wajmh/D-Y/CAN3_逻辑总结.md

# CAN3 / 小脑 (RK3588) 通信与总线逻辑总结

> [!IMPORTANT]
> **V1.2 硬件改版与总线对调关键背景**：
> - 依据《v1.2新版_电源板原理图_2026-09-17.pdf》及最新固件代码：由于 PCB 走线将 CAN2 与 CAN3 外接接口反接，且 STM32G474 物理引脚 AF 映射无法互换，固件已在**软件层对调 FDCAN2 与 FDCAN3 控制器职责**。
> - **与上位机 / 小脑 (RK3588) 通信的总线**：硬件接口连接 STM32 的 **`FDCAN2`（RX: PB5, TX: PB13）**；
> - **电池2 BMS 与外部充电桩总线**：硬件接口连接 STM32 的 **`FDCAN3`（RX: PA8, TX: PB4）**；
> - **电池1 BMS 总线**：连接 STM32 的 **`FDCAN1`（RX: PA11, TX: PA12）**。
> - 本文档全面梳理**与小脑 (RK3588) 交互的所有总线通信协议与底层逻辑**（在代码中由 [`fdcan.c`](file:///home/yq/ghf/workspace/D-Y-A10/Core/Src/fdcan.c) 的 `hfdcan2` 外设驱动），同时涵盖 V1.2 最新引入的**声光控制、IAP 在线升级、Bus-Off 自愈与硬件安全策略**。

---

## 1. 系统架构与总线拓扑

```mermaid
flowchart LR
    subgraph 电池与充电桩
        BAT1["电池1 BMS"] -->|FDCAN1 (PA11/PA12)| MCU
        BAT2["电池2 BMS"] -->|FDCAN3 (PA8/PB4)| MCU
        CHARGER["外部充电桩<br/>0x0500FF80"] -->|FDCAN3 (PA8/PB4)| MCU
    end

    subgraph 控制大脑
        MCU["STM32G474RBT6<br/>电源管理主控"]
    end

    subgraph 上位机小脑
        MCU -->|"FDCAN2 (PB13-TX)<br/>遥测/状态/转发"| RK["RK3588 小脑"]
        RK -->|"FDCAN2 (PB5-RX)<br/>控制/IAP/声光"| MCU
    end
```

### 控制器与物理引脚映射全景

| 逻辑总线角色 | MCU 外设控制器 | 物理引脚 | 外接对象 | 主要通信内容 |
|---|---|---|---|---|
| **小脑上位机总线** | **FDCAN2** | **RX: PB5<br/>TX: PB13** | **小脑 (RK3588)** | **遥测上报 (电流/告警/MOS/状态)<br/>声光控制 (0x04600000/01)<br/>IAP 固件升级 (0x04700000/01)<br/>BMS 报文转发 (0x0402/03/0E/07)** |
| **电池2 / 充电桩总线** | **FDCAN3** | **RX: PA8<br/>TX: PB4** | **电池2 BMS +<br/>外部充电桩** | 接收电池2状态/MOS/温度/故障<br/>接收充电桩握手帧 (0x0500FF80)<br/>向充电桩发送充电机回复帧 |
| **电池1 BMS 总线** | **FDCAN1** | **RX: PA11<br/>TX: PA12** | **电池1 BMS** | 接收电池1状态/MOS/温度/故障<br/>发送电池1开机唤醒帧 |

---

## 2. CAN 控制器硬件与参数配置

三路 FDCAN 控制器均采用标准经典 CAN 250 kbps 波特率配置（基于时钟源 PCLK1 = 170MHz）：

| 参数项 | FDCAN2 (小脑 RK 通信) | FDCAN3 (电池2 + 充电桩) | FDCAN1 (电池1 BMS) |
|---|---|---|---|
| **物理引脚** | PB5 (RX), PB13 (TX) | PA8 (RX), PB4 (TX) | PA11 (RX), PA12 (TX) |
| **波特率** | **250 kbps** | **250 kbps** | **250 kbps** |
| **位时序** | Prescaler=40, Seg1=13, Seg2=3, SJW=1 | Prescaler=40, Seg1=13, Seg2=3, SJW=1 | Prescaler=40, Seg1=13, Seg2=3, SJW=1 |
| **帧格式** | 经典 CAN (`FDCAN_FRAME_CLASSIC`) | 经典 CAN (`FDCAN_FRAME_CLASSIC`) | 经典 CAN (`FDCAN_FRAME_CLASSIC`) |
| **ID 类型** | 扩展帧 (29-bit Extended ID) | 扩展帧 (29-bit Extended ID) | 扩展帧 (29-bit Extended ID) |
| **TX 模式** | FIFO 队列模式 (`FDCAN_TX_FIFO_OPERATION`) | FIFO 队列模式 | FIFO 队列模式 |
| **自动重发** | 开启 (`AutoRetransmission = ENABLE`) | 开启 (`ENABLE`) | 开启 (`ENABLE`) |
| **RX 过滤器** | 1 标准 + **3 扩展过滤器**<br>(0x04500000, 0x04600000, 0x04700000) | 1 标准 + **8 扩展过滤器**<br>(7类BMS帧 + 0x0500FF80充电桩帧) | 1 标准 + **7 扩展过滤器**<br>(7类BMS帧) |

---

## 3. CAN 发送帧汇总（TX → 小脑 RK，由 FDCAN2 发送）

### 3.1 腿部电流上报 `0x04100000`

| 字段 | 属性 / 说明 |
|---|---|
| **CAN ID** | `0x04100000` |
| **帧类型** | 扩展帧 (29-bit)，数据帧 |
| **数据长度** | 8 字节 |
| **发送周期** | **200ms** 周期发送（与外设电流同时触发） |
| **发送函数** | [`FDCAN_SendCurrentReportsToRk()`](file:///home/yq/ghf/workspace/D-Y-A10/Core/Src/fdcan.c#L419-L435) |
| **硬件变动说明** | **V1.2 原理图已取消板载腿部运放检流电路**（PC0~PC3 废弃/预留，腿电流改由各关节电机 CAN 自行上报）。固件保留该接口与报文定义以保持上位机协议兼容，数据固定填充为 0.00A。 |

**数据格式（小端序 int16，缩放比例 100，即 0.01A）：**

| 字节偏移 | 字段定义 | 类型 | 数值范围与说明 |
|---|---|---|---|
| Byte 0-1 | Leg1 采样电流 | int16_t (LE) | `0`（硬件已取消，固定填充 0） |
| Byte 2-3 | Leg2 采样电流 | int16_t (LE) | `0`（硬件已取消，固定填充 0） |
| Byte 4-5 | Leg3 采样电流 | int16_t (LE) | `0`（硬件已取消，固定填充 0） |
| Byte 6-7 | Leg4 采样电流 | int16_t (LE) | `0`（硬件已取消，固定填充 0） |

---

### 3.2 外设电流上报 `0x04200000`

| 字段 | 属性 / 说明 |
|---|---|
| **CAN ID** | `0x04200000` |
| **帧类型** | 扩展帧 (29-bit)，数据帧 |
| **数据长度** | 8 字节 |
| **发送周期** | **200ms** 周期发送 |
| **发送函数** | [`FDCAN_SendCurrentReportsToRk()`](file:///home/yq/ghf/workspace/D-Y-A10/Core/Src/fdcan.c#L419-L435) |
| **硬件采样来源** | **PA4 (ADC2_IN17)** 经运放采样的外设放电电流，DMA 循环采集计算 |

**数据格式：**

| 字节偏移 | 字段定义 | 类型 | 数值范围与说明 |
|---|---|---|---|
| Byte 0-1 | 外设放电电流 | int16_t (LE) | 电流值(A) × 100（精度 0.01A） |
| Byte 2-7 | 保留字段 | uint8_t | 固定填充 `0x00` |

---

### 3.3 急停上报 `0x04300000` [已停用]

> [!WARNING]
> **硬件状态变动**：V1.2 硬件设计中，急停输入引脚 PD2 (`I_STOP_EN`) 硬件未连接且已在原理图中停用。
> 固件代码中，急停检测逻辑、定时轮询上报及 `0x04300000` 报文已在 [`fdcan.c`](file:///home/yq/ghf/workspace/D-Y-A10/Core/Src/fdcan.c#L43-L46) 中**注释停用**，正常运行期间不再发送此帧。

---

### 3.4 电池告警 + 本地 MOS 状态上报 `0x04400000`

| 字段 | 属性 / 说明 |
|---|---|
| **CAN ID** | `0x04400000` |
| **帧类型** | 扩展帧 (29-bit)，数据帧 |
| **数据长度** | 8 字节 |
| **发送周期** | **100ms** 周期（`FDCAN_BATTERY_ALARM_REPORT_PERIOD_MS = 100U`） |
| **发送函数** | [`FDCAN_SendBatteryAlarmReportToRk()`](file:///home/yq/ghf/workspace/D-Y-A10/Core/Src/fdcan.c#L446-L460) |

**多条件触发策略：**

| 运行条件 | 发送行为 | 说明 |
|---|---|---|
| **系统存在告警** | 每 **100ms** 周期发送 | 电池1或电池2告警状态不为 0 时持续高频上报 |
| **MOS 状态跳变** | **立即事件触发** | 任意 MOS（放电/回充/充电）发生开/关动作时立刻发送，零延时同步状态 |
| **告警刚刚清除** | 连续补发 **10 帧**（每 100ms） | 从有报警恢复正常时，突发补发 10 帧保证小脑可靠感知消除 |
| **正常心跳** | 每 **100ms** 周期发送 | 无告警且 MOS 稳定时的常规基线心跳（`FDCAN_BATTERY_ALARM_HEARTBEAT_PERIOD_MS`） |

**数据格式：**

| 字节偏移 | 字段定义 | 取值与说明 |
|---|---|---|
| **Byte 0** | 电池1 告警状态 | `0x00`=正常, 非0表示故障掩码（过压/欠压/过流/过温等） |
| **Byte 1** | 电池2 告警状态 | `0x00`=正常, 非0表示故障掩码 |
| **Byte 2** | 电池1 主放电 MOS 状态 | `0x01`=导通 (ON), `0x00`=断开 (OFF) |
| **Byte 3** | 电池1 回充 MOS 状态 | `0x01`=导通 (ON), `0x00`=断开 (OFF) |
| **Byte 4** | 电池2 主放电 MOS 状态 | `0x01`=导通 (ON), `0x00`=断开 (OFF) |
| **Byte 5** | 电池2 回充 MOS 状态 | `0x01`=导通 (ON), `0x00`=断开 (OFF) |
| **Byte 6** | 电池1 充电 MOS 状态 | `0x01`=导通 (ON), `0x00`=断开 (OFF)（V1.2 由 PB10 总充电 MOS 镜像同步） |
| **Byte 7** | 电池2 充电 MOS 状态 | `0x01`=导通 (ON), `0x00`=断开 (OFF)（V1.2 由 PB10 总充电 MOS 镜像同步） |

---

### 3.5 充电模式状态回复 `0x04500001`

| 字段 | 属性 / 说明 |
|---|---|
| **CAN ID** | `0x04500001` |
| **帧类型** | 扩展帧 (29-bit)，数据帧 |
| **数据长度** | 1 字节 |
| **触发条件** | **事件驱动**：进入或退出充电模式瞬间向小脑回复确认 |
| **发送函数** | [`FDCAN_SendChargeModeStatusToRk()`](file:///home/yq/ghf/workspace/D-Y-A10/Core/Src/fdcan.c#L462-L502) |

**数据格式：**

| 字节偏移 | 字段定义 | 取值说明 |
|---|---|---|
| Byte 0 | 充电模式当前状态 | `0x01` = 已成功切入充电模式<br/>`0x00` = 已退出充电模式 |

**典型触发场景：**
1. **握手进入**：小脑已发送充电请求（`rk_charge_mode_request = 1`）且 FDCAN3 收到充电桩握手帧（`0x0500FF80`）→ MCU 进入充电模式并回复 `0x01`；
2. **主动退出**：小脑发送 `0x04500000`（载荷 `0x00`）要求退出 → MCU 立即切出充电模式并回复 `0x00`；
3. **超时退出**：在充电激活状态下，若超过 **3000ms**（`FDCAN_CHARGER_CAN_TIMEOUT_MS`）未收到充电桩报文（拔枪或充电机断电）→ MCU 自动退出充电模式并回复 `0x00`；
4. **VBUS 持续供电保护**：进入充电模式时，在位电池的**主放电 MOS 保持导通**，确保 VBUS 持续带电供应板载 12V DCDC，**保障小脑 RK3588 绝对不掉电**；回充 MOS 与预充 MOS 强制切断以防倒灌。

---

### 3.6 声光指示状态遥测上报 `0x04600001` [V1.2 新增]

| 字段 | 属性 / 说明 |
|---|---|
| **CAN ID** | `0x04600001` |
| **帧类型** | 扩展帧 (29-bit)，数据帧 |
| **数据长度** | 8 字节 |
| **发送周期** | **500ms** 周期发送（`FDCAN_RK_INDICATOR_REPORT_PERIOD_MS = 500U`） |
| **发送函数** | [`FDCAN_SendIndicatorStatusToRk()`](file:///home/yq/ghf/workspace/D-Y-A10/Core/Src/fdcan.c#L2016-L2073) |

**数据格式：**

| 字节偏移 | 字段定义 | 取值与说明 |
|---|---|---|
| **Byte 0** | 小脑接管状态 | Bit0: `1`=RGB 被小脑接管, `0`=本地电量模式<br/>Bit1: `1`=蜂鸣器被小脑接管, `0`=本地默认 |
| **Byte 1** | 实际物理红灯状态 (R) | `0x01` = 点亮, `0x00` = 熄灭 |
| **Byte 2** | 实际物理绿灯状态 (G) | `0x01` = 点亮, `0x00` = 熄灭 |
| **Byte 3** | 实际物理蓝灯状态 (B) | `0x01` = 点亮, `0x00` = 熄灭 |
| **Byte 4** | 实际物理蜂鸣器状态 | `0x01` = 鸣响, `0x00` = 静音 |
| **Byte 5** | 双电池最小 SOC | 取两路在位电池 SOC 的最小值（0~100%，四舍五入整数） |
| **Byte 6** | 系统故障状态字节 | **Bit0**: `1` = 检测到 CAN Bus-Off 故障<br/>**Bit1**: 保留（原急停标志，已停用）<br/>**Bit2**: `1` = 严重低电量报警（SOC < 20%） |
| **Byte 7** | 保留字段 | 固定填充 `0x00` |

---

### 3.7 IAP 在线升级协议应答 `0x04700001` [V1.2 新增]

| 字段 | 属性 / 说明 |
|---|---|
| **CAN ID** | `0x04700001` |
| **帧类型** | 扩展帧 (29-bit)，数据帧 |
| **数据长度** | 8 字节 |
| **触发条件** | 收到小脑 `0x04700000` IAP 指令后立即应答 |
| **处理函数** | [`FDCAN_HandleIapCommand()`](file:///home/yq/ghf/workspace/D-Y-A10/Core/Src/fdcan.c#L1130-L1184) |

**数据格式（在 App 中运行时的典型回复）：**

| 响应指令 (CMD) | 作用 | 数据载荷 (8字节) | 详细含义 |
|---|---|---|---|
| `0x01` (PING 响应) | 查询当前固件状态 | `[0x01, 0x00, 0x02, Major, Minor, Patch, 0x01, 0x00]` | Byte1=0 (ACK_OK)<br/>Byte2=2 (当前运行于 App)<br/>Byte3~5=版本号 (如 1, 2, 4)<br/>Byte6=1 (App 固件有效) |
| `0x02` (START 响应) | 确认切入升级 | `[0x02, 0x00, 0x02, 0x00, 0x00, 0x00, 0x00, 0x00]` | Byte1=0 (ACK_OK)<br/>Byte2=2 (App 收到请求)<br/>*回复后延时 20ms 确保发送完成，随后执行无缝热接力平滑跳转至 Bootloader* |

---

### 3.8 电池 BMS 报文透明转发（FDCAN1/FDCAN3 → FDCAN2/小脑）

| 字段 | 属性 / 说明 |
|---|---|
| **CAN ID 规则** | `txId = (rxId & 0x1FFFFF00) | batteryIndex`<br>- `batteryIndex = 1`：源自 FDCAN1（电池1）<br>- `batteryIndex = 2`：源自 FDCAN3（电池2，硬件反接后映射） |
| **帧类型 / DLC** | 保持原始 BMS 扩展帧与数据长度 |
| **触发机制** | 收到符合条件的 BMS 扩展帧后立即打包转发至 FDCAN2 TX FIFO |
| **处理函数** | [`FDCAN_ForwardBatteryFrameToRk()`](file:///home/yq/ghf/workspace/D-Y-A10/Core/Src/fdcan.c#L641-L697) |

**转发的 4 类 BMS 核心帧：**

| 原始 ID Base (掩码过滤) | 转发后 ID (Bat1 / Bat2) | 报文含义 | 关键数据载荷 |
|---|---|---|---|
| `0x04028000` | `0x04028001` / `0x04028002` | **电池状态帧** | 总电压 (0.1V)、充放电电流 ((raw-30000)×0.1A)、SOC (0.1%) |
| `0x04038000` | `0x04038001` / `0x04038002` | **电池信息帧** | 电池容量、循环次数、出厂信息等 |
| `0x040E8000` | `0x040E8001` / `0x040E8002` | **电池故障帧** | BMS 内部单体过压/欠压、温差大、短路等硬报警 |
| `0x04078000` | `0x04078001` / `0x04078002` | **电池温度帧** | 各电芯探头采集的实际温度分布 |

> [!NOTE]
> - **不转发的帧**：BMS 内部 MOS 状态帧（`0x04068000`）和充电机回复帧（`0x04008000`, `0x04088000`）仅在 MCU 本地解析消抖并存储，不直接转发给小脑，而是通过 `0x04400000` 统一汇总上报。
> - **队列防溢出**：若 FDCAN2 总线处于 Bus-Off 或 TX FIFO 满，报文将被安全丢弃，丢帧计入 `battery_can_forward_drop_count` 调试计数器。

---

## 4. CAN 接收帧汇总（RX ← 小脑 RK，由 FDCAN2 接收）

小脑通过 FDCAN2 下发控制指令，MCU 在主循环 [`FDCAN_PollRkRx()`](file:///home/yq/ghf/workspace/D-Y-A10/Core/Src/fdcan.c#L1186-L1211) 中以非阻塞方式轮询处理。

### 4.1 充电模式控制指令 `0x04500000`

| 字段 | 属性 / 说明 |
|---|---|
| **CAN ID** | `0x04500000` |
| **帧类型** | 扩展帧 (29-bit)，数据帧 |
| **数据长度** | ≥ 1 字节 |
| **处理函数** | [`FDCAN_HandleRkChargeModeCommand()`](file:///home/yq/ghf/workspace/D-Y-A10/Core/Src/fdcan.c#L926-L949) |

**数据格式：**

| 字节偏移 | 字段定义 | 取值与作用 |
|---|---|---|
| Byte 0 | 充电模式指令代码 | `0x01` = 请求进入充电模式<br/>`0x00` = 请求退出充电模式 |

**状态机处理逻辑（两阶段安全握手）：**
- **收到 `0x01`**：置位标记 `rk_charge_mode_request = 1`。此时**并不立刻开启充电机 MOS**，而是等待外部充电桩在 FDCAN3 上发出 `0x0500FF80` 握手报文，确认充电机物理到位后才真正切换充电模式，避免空载打火；
- **收到 `0x00`**：立即清除请求，断开充电回路，退出充电模式，并回复状态帧 `0x04500001`（数据 `0x00`）。

---

### 4.2 小脑声光指示控制指令 `0x04600000` [V1.2 新增]

| 字段 | 属性 / 说明 |
|---|---|
| **CAN ID** | `0x04600000` |
| **帧类型** | 扩展帧 (29-bit)，数据帧 |
| **数据长度** | 1 ~ 8 字节 |
| **处理函数** | [`FDCAN_HandleRkIndicatorCommand()`](file:///home/yq/ghf/workspace/D-Y-A10/Core/Src/fdcan.c#L951-L1017) |

**数据格式：**

| 字节偏移 | 字段定义 | 详细取值与说明 |
|---|---|---|
| **Byte 0** | 接管使能掩码 (`ctrlMask`) | **Bit0 (0x01)**: 小脑接管 RGB 控制权（1:接管, 0:释放回到本地电量指示）<br/>**Bit1 (0x02)**: 小脑接管蜂鸣器（1:接管, 0:释放回到本地） |
| **Byte 1** | 红色分量 (R) | `0` = 关, `1` = 开 |
| **Byte 2** | 绿色分量 (G) | `0` = 关, `1` = 开 |
| **Byte 3** | 蓝色分量 (B) | `0` = 关, `1` = 开 |
| **Byte 4** | RGB 工作模式 | `0x00` = 常亮 (Solid)<br/>`0x01` = 闪烁 (Blink) |
| **Byte 5** | 蜂鸣器工作模式 | `0x00` = 静音 (Off)<br/>`0x01` = 持续长鸣 (On)<br/>`0x02` = 单次短鸣 200ms (`BEEP_ONCE`)<br/>`0x03` = 周期鸣叫 (`BLINK`) |
| **Byte 6** | 闪烁/鸣叫半周期 | 单位：**50 ms**（例如写入 `10` 表示 500ms 半周期，默认 500ms） |
| **Byte 7** | 通信安全超时时间 | 单位：**100 ms**（例如写入 `30` 表示 3000ms 超时）。超过此时间若无新指令，**自动安全释放接管权，退回本地电量显示**。若为 0 则表示无限期接管。 |

> [!TIP]
> 固件源码中定义有宏 `#define DEBUG_DISABLE_RK_BUZZER_CTRL 1`。在台架调试或特定版本中，可选择性屏蔽小脑对蜂鸣器的接管，避免上位机调试误触发尖锐警报。

---

### 4.3 IAP 在线升级控制指令 `0x04700000` [V1.2 新增]

| 字段 | 属性 / 说明 |
|---|---|
| **CAN ID** | `0x04700000` |
| **帧类型** | 扩展帧 (29-bit)，数据帧 |
| **数据长度** | 1 ~ 8 字节 |
| **处理函数** | [`FDCAN_HandleIapCommand()`](file:///home/yq/ghf/workspace/D-Y-A10/Core/Src/fdcan.c#L1130-L1184) |

**指令集：**

| 指令 (Byte 0) | 作用 | 载荷参数 | MCU 动作 |
|---|---|---|---|
| `0x01` | **握手与状态查询 (PING)** | 无附加参数 | 回复 `0x04700001`，上报当前运行状态（App态）及三位固件版本号 |
| `0x02` | **请求跳转 Bootloader** | 携带预备固件大小等 | 回复 ACK，随后**启动无缝热接力时序**平滑跳转至 Bootloader |

---

## 5. 小脑通信总线协议帧全景速查表

| # | 传输方向 | CAN 标识符 (ID) | DLC | 周期 / 触发方式 | 协议用途与核心作用 |
|:---:|:---:|:---:|:---:|:---:|---|
| **1** | TX → 小脑 | `0x04100000` | 8B | 200ms 周期 | **腿部电流上报**（V1.2 硬件取消，兼容保留填 0） |
| **2** | TX → 小脑 | `0x04200000` | 8B | 200ms 周期 | **外设放电电流上报**（PA4 运放检流，0.01A 精度） |
| **3** | TX → 小脑 | `0x04300000` | 8B | *(已停用)* | **急停状态上报**（硬件断开，代码已注释禁用） |
| **4** | TX → 小脑 | `0x04400000` | 8B | 100ms / 状态跳变 | **电池告警 + 6路MOS物理状态汇总上报** |
| **5** | TX → 小脑 | `0x04500001` | 1B | 事件驱动 | **充电模式状态应答**（0x01 进入 / 0x00 退出） |
| **6** | TX → 小脑 | `0x04600001` | 8B | 500ms 周期 | **声光指示状态遥测**（物理灯/蜂鸣器/SOC/Bus-Off） |
| **7** | TX → 小脑 | `0x04700001` | 8B | 事件驱动 | **IAP 固件升级握手响应与固件版本回复** |
| **8** | TX → 小脑 | `0x0402xx01/02` | 6~8B | 收到 BMS 立即转发 | **电池状态帧转发**（总压、电流、SOC） |
| **9** | TX → 小脑 | `0x0403xx01/02` | 8B | 收到 BMS 立即转发 | **电池信息帧转发**（容量、循环次数等） |
| **10** | TX → 小脑 | `0x040Exx01/02` | 8B | 收到 BMS 立即转发 | **电池故障告警帧转发**（BMS 硬件报警） |
| **11** | TX → 小脑 | `0x0407xx01/02` | 8B | 收到 BMS 立即转发 | **电池温度帧转发**（各电芯传感器测温） |
| **12** | RX ← 小脑 | `0x04500000` | 1B | 上位机事件下发 | **充电模式控制指令**（0x01 请求充电 / 0x00 退出） |
| **13** | RX ← 小脑 | `0x04600000` | 8B | 上位机事件/周期 | **声光指示接管控制**（RGB模式、蜂鸣器、超时设定） |
| **14** | RX ← 小脑 | `0x04700000` | 1~8B | 上位机升级指令 | **IAP 在线升级触发指令**（PING 查询 / 切入 Bootloader） |

---

## 6. 系统数据流向与状态机架构

```mermaid
flowchart TD
    subgraph 电池与充电桩输入
        B1["电池1 BMS (FDCAN1)"] -->|状态/信息/故障/温度| FWD["报文转发模块<br/>ID低8位替换为0x01"]
        B2["电池2 BMS (FDCAN3)"] -->|状态/信息/故障/温度| FWD2["报文转发模块<br/>ID低8位替换为0x02"]
        B1 -->|MOS/电压/SOC| PARSE["BMS状态解析与3帧消抖"]
        B2 -->|MOS/电压/SOC| PARSE
        CHG_PLUG["充电桩握手 0x0500FF80 (FDCAN3)"] --> CHARGE_MGR["充电状态机"]
    end

    subgraph MCU 核心业务处理
        ADC_SAMPLER["ADC2 DMA采样<br/>外设电流 (PA4) & VBUS (PB15)"]
        ALARM_MGR["电池与系统告警判断"]
        INDICATOR["声光优先级仲裁状态机<br/>Priority 1: Bus-Off (红闪)<br/>Priority 2: 小脑接管<br/>Priority 3: 本地电量 (绿/蓝/红)"]
        IAP_MGR["IAP 在线升级管理器"]
    end

    subgraph FDCAN2 上位机交互出口
        FWD -->|0x0402/03/0E/07xx01| RK_BUS["小脑 (RK3588)"]
        FWD2 -->|0x0402/03/0E/07xx02| RK_BUS
        ADC_SAMPLER -->|0x04100000 / 0x04200000| RK_BUS
        ALARM_MGR & PARSE -->|0x04400000 (100ms/跳变)| RK_BUS
        CHARGE_MGR -->|0x04500001| RK_BUS
        INDICATOR -->|0x04600001 (500ms)| RK_BUS
        IAP_MGR -->|0x04700001| RK_BUS

        RK_BUS -->|0x04500000 充电指令| CHARGE_MGR
        RK_BUS -->|0x04600000 声光控制| INDICATOR
        RK_BUS -->|0x04700000 IAP指令| IAP_MGR
    end
```

---

## 7. 关键系统安全与可靠性机制

### 7.1 Bus-Off 中断自动检测与非阻塞状态机恢复
- **问题与隐患**：当 CAN 总线受到大电机强烈干扰或插拔接头瞬间，物理层极易出现严重位错误使控制器陷入 Bus-Off（总线关闭）脱网状态。
- **恢复状态机**：
  1. `FDCAN_BUSOFF_STATE_PENDING`：在中断回调中捕获，等待 **100ms** 滤波延迟以避开突发总线噪声；
  2. `FDCAN_BUSOFF_STATE_REQUEST_INIT`：置位 `CCCR.INIT` 请求进入初始化模式；
  3. `FDCAN_BUSOFF_STATE_START_SYNC`：复位 `CCCR.INIT` 请求退出并启动恢复，硬件自动监听 **129 次 11 个隐性位序列**；
  4. `FDCAN_BUSOFF_STATE_RECOVERING`：持续监测 PSR，同步完成后自动切回 `IDLE` 正常工作。
- **上位机上报门禁**：当 FDCAN2 处于 Bus-Off 期间，MCU 会**自动阻断向小脑的一切发送尝试**，消除 TX FIFO 满队列导致的系统卡顿与计算开销。
- **故障声光指示**：总线发生 Bus-Off 故障时，三色状态灯自动切为**红灯闪烁**，蜂鸣器保持静音。

### 7.2 充电模式“小脑永不断电”设计
- **回路供电关系**：动力电池 → 主放电 MOS (PB6/PC11) → 母线 VBUS → 12V 隔离 DCDC (PA7) → 小脑 RK3588。
- **策略改进**：切入充电模式时，MCU **坚决维持在位电池的主放电 MOS 持续导通**，仅切断回充 MOS 与预放电 MOS；充电输入由 PB10 单路直通 VBUS，母线持续带电，**彻底消除切入充电导致小脑失电死机的严重隐患**。

### 7.3 IAP 在线升级“无缝热接力（Warm Handover）”
- **零断电跳转**：App 在跳转前仅关断充电与泄放回路，保持主放电 MOS 与 12V/24V DCDC 开启；
- **免预充直接切回**：升级完毕切回 App 时，App 识别 SRAM 握手魔数（`HOT_BOOT_MAGIC`），**直接跳过 400ms 预充延时与 MOS 开关动作**，实现毫秒级平滑过渡，确保小脑升级过程全程不掉电、不重启。
