wajmh/D-Y/电源板V1.2_MCU引脚分配与功能说明.md

# 电源板 V1.2 MCU 引脚分配与功能说明文档

- **芯片型号**：STM32G474RBT6
- **封装形式**：LQFP64
- **硬件版本**：V1.2（对应原理图 `v1.2新版_SCH_Schematic1_2026-09-17.pdf`）
- **基准工程**：`D-Y.ioc`（STM32CubeMX 6.18.1 / FW_G4 V1.6.3）
- **更新日期**：2026-09-20

---

## 一、 总体引脚分配全景表 (Pin 1 ~ Pin 64)

| 引脚号 | 芯片引脚名 | 网络标号 (Net Name) | STM32CubeMX 配置 | 默认电平 / 属性 | 功能说明 |
|:---:|:---|:---|:---|:---:|:---|
| **1** | VBAT | VCC_3V3 | Power | 3.3V | 芯片备用电池电源引脚，接 3.3V 主电源 |
| **2** | **PC13** | **O_Alarm** | GPIO_Output | Low (推挽) | **蜂鸣器报警控制**：高电平驱动 N-MOS (Q26) 导通，使蜂鸣器发声 |
| **3** | **PC14-OSC32_IN** | **O_RGB_B** | GPIO_Output | Low (推挽) | **三色状态指示灯-蓝灯**：高电平驱动 N-MOS (Q24) 导通拉低驱动 LED |
| **4** | **PC15-OSC32_OUT**| **O_RGB_R** | GPIO_Output | Low (推挽) | **三色状态指示灯-红灯**：高电平驱动 N-MOS (Q23) 导通拉低驱动 LED |
| **5** | PF0-OSC_IN | OSC_IN2 | RCC_OSC_IN | Analog | 外部高速晶振输入（24MHz） |
| **6** | PF1-OSC_OUT | OSC_OUT2 | RCC_OSC_OUT | Analog | 外部高速晶振输出（24MHz） |
| **7** | PG10-NRST | NRST | Reset | Input | 硬件复位引脚（外接 RC 复位电路） |
| **8** | PC0 | LPUART1_RX | NC / (LPUART1_RX) | 悬空 / 预留 | 预留低功耗串口 1 接收端（原腿4电流采样已取消） |
| **9** | PC1 | LPUART1_TX | NC / (LPUART1_TX) | 悬空 / 预留 | 预留低功耗串口 1 发送端（原腿3电流采样已取消） |
| **10** | **PC2** | **O_RGB_G** | GPIO_Output | Low (推挽) | **三色状态指示灯-绿灯**：高电平驱动 N-MOS (Q25) 导通拉低驱动 LED |
| **11** | PC3 | *(NC)* | Reset_State | 悬空 | 废弃悬空（原腿2电流采样已取消） |
| **12** | PA0 | *(NC)* | Reset_State | 悬空 | 废弃悬空（原电池1放电 MOS 已移至 PB6） |
| **13** | PA1 | RS485_1_DIR | USART2_DE | 硬件流控 | 无线充电 RS485 收发方向切换控制端 |
| **14** | PA2 | *(NC)* | Reset_State | 悬空 | 废弃悬空（原电池1充电电流采样已取消） |
| **15** | VSS | AGND | Ground | 0V | 芯片接地（通过 0Ω 电阻 R158 连接模拟地/数字地） |
| **16** | VDD | VCC_3V3 | Power | 3.3V | 芯片数字主供电（外接去耦电容） |
| **17** | PA3 | RS485_1_RX | USART2_RX | 复用输入 | 无线充电 RS485 接收引脚 |
| **18** | **PA4** | **A_Peripheral_Current** | **ADC2_IN17** | Analog (Rank 1)| **外设放电电流检测**：运放检流电路输入，经 DMA 连续循环采集 |
| **19** | **PA5** | **O_Peripheral_G** | GPIO_Output | Low (推挽) | **外设供电 MOS 控制**：控制外设电源总开关（高电平开启供电） |
| **20** | PA6 | *(NC)* | Reset_State | 悬空 | 废弃悬空（原电池1电压采样已取消，由 BMS 上报） |
| **21** | **PA7** | **O_Enable_12V** | GPIO_Output | Low (推挽) | **12V DCDC 电源使能控制**：高电平驱动 N-MOS (Q5) 导通拉低 EN |
| **22** | **PC4** | **O_Enable_24V** | GPIO_Output | Low (推挽) | **24V DCDC 电源使能控制**：高电平驱动 N-MOS (Q6) 导通拉低 EN |
| **23** | PC5 | *(NC)* | Reset_State | 悬空 | 废弃悬空（原充电器电压采样已取消） |
| **24** | PB0 | *(NC)* | Reset_State | 悬空 | 废弃悬空（原电池1预放电 MOS 已移至 PB9） |
| **25** | PB1 | *(NC)* | Reset_State | 悬空 | 废弃悬空（原电池2预放电 MOS 已移至 PC12） |
| **26** | PB2 | *(NC)* | Reset_State | 悬空 | 废弃悬空（原外设电流采样已移至 PA4） |
| **27** | VSSA | AGND | Ground | 0V | 模拟地 |
| **28** | VREF+ | VCC_3V3 | Power | 3.3V | ADC 模拟参考电压（3.3V） |
| **29** | VDDA | VCC_3V3 | Power | 3.3V | 模拟部分电源供电（3.3V） |
| **30** | **PB10** | **O_Bat_C_G** | GPIO_Output | Low (推挽) | **单路总充电 MOS 控制**：充电口背对背 MOS 控制，连通充电器与 VBUS |
| **31** | VSS | AGND | Ground | 0V | 芯片数字地 |
| **32** | VDD | VCC_3V3 | Power | 3.3V | 芯片数字主供电 |
| **33** | **PB11** | **O_Power_Release2**| GPIO_Output | Low (推挽) | **反电势吸收保护控制回路 2**：高电平导通泄放 MOS 吸收电势 |
| **34** | **PB12** | **O_Power_Release1**| GPIO_Output | Low (推挽) | **反电势吸收保护控制回路 1**：高电平导通泄放 MOS 吸收电势 |
| **35** | PB13 | CAN2_TX | FDCAN2_TX | 复用输出 | 电池2 BMS 通信 CAN2 发送端 |
| **36** | PB14 | *(NC)* | Reset_State | 悬空 | 废弃悬空（原 Vbus 电压采样已移至 PB15） |
| **37** | **PB15** | **A_Vbus_Voltage** | **ADC2_IN15** | Analog (Rank 2)| **总线电压检测 (VBUS)**：总线分压采样输入，经 DMA 连续循环采集 |
| **38** | PC6 | *(NC)* | Reset_State | 悬空 | 未引出 |
| **39** | PC7 | *(NC)* | Reset_State | 悬空 | 未引出 |
| **40** | PC8 | *(NC)* | Reset_State | 悬空 | 未引出 |
| **41** | PC9 | *(NC)* | Reset_State | 悬空 | 未引出 |
| **42** | PA8 | CAN3_RX | FDCAN3_RX | 复用输入 | 充电器 / RK3588 主控通信 CAN3 接收端 |
| **43** | PA9 | *(NC)* | Reset_State | 悬空 | 未引出 |
| **44** | PA10 | *(NC)* | Reset_State | 悬空 | 未引出 |
| **45** | PA11 | CAN1_RX | FDCAN1_RX | 复用输入 | 电池1 BMS 通信 CAN1 接收端 |
| **46** | PA12 | CAN1_TX | FDCAN1_TX | 复用输出 | 电池1 BMS 通信 CAN1 发送端 |
| **47** | VSS | AGND | Ground | 0V | 芯片数字地 |
| **48** | VDD | VCC_3V3 | Power | 3.3V | 芯片数字主供电 |
| **49** | PA13 | SWDIO | SYS_JTMS-SWDIO | 复用双向 | SWD 调试仿真数据线 |
| **50** | PA14 | SWCLK | SYS_JTCK-SWCLK | 复用输入 | SWD 调试仿真时钟线 |
| **51** | PA15 | *(NC)* | Reset_State | 悬空 | 废弃悬空（原 OLED I2C1_SCL 已取消） |
| **52** | **PC10** | **O_Bat2_D_CHG** | GPIO_Output | Low (推挽) | **电池2 回充 MOS 控制**：控制电池2双向回充通路 |
| **53** | **PC11** | **O_Bat2_D_DSG** | GPIO_Output | Low (推挽) | **电池2 主放电 MOS 控制**：控制电池2主放电通路 |
| **54** | **PC12** | **O_Bat2_D_PDSG**| GPIO_Output | Low (推挽) | **电池2 预放电 MOS 控制**：串联限流电阻软启动防打火冲击 |
| **55** | **PD2** | **I_STOP_EN** | GPIO_Input | Floating (浮空)| **急停信号输入**：停用，硬件上去除 |
| **56** | PB3 | RS485_1_TX | USART2_TX | 复用输出 | 无线充电 RS485 发送引脚 |
| **57** | PB4 | CAN3_TX | FDCAN3_TX | 复用输出 | 充电器 / RK3588 主控通信 CAN3 发送端 |
| **58** | PB5 | CAN2_RX | FDCAN2_RX | 复用输入 | 电池2 BMS 通信 CAN2 接收端 |
| **59** | **PB6** | **O_Bat1_D_DSG** | GPIO_Output | Low (推挽) | **电池1 主放电 MOS 控制**：控制电池1主放电通路 |
| **60** | **PB7** | **O_Bat1_D_CHG** | GPIO_Output | Low (推挽) | **电池1 回充 MOS 控制**：控制电池1双向回充通路 |
| **61** | PB8-BOOT0 | BOOT0 | BOOT0 | Input (下拉) | 启动模式选择（外接 10kΩ 下拉至地） |
| **62** | **PB9** | **O_Bat1_D_PDSG**| GPIO_Output | Low (推挽) | **电池1 预放电 MOS 控制**：串联限流电阻软启动防打火冲击 |
| **63** | VSS | AGND | Ground | 0V | 芯片数字地 |
| **64** | VDD | VCC_3V3 | Power | 3.3V | 芯片数字主供电 |

---

## 二、 功能模块分类说明

### 1. 双电池管理及充放电控制模块 (共 7 个 GPIO 输出)
V1.2 架构下，每个电池包具备 3 个控制 MOS，充电变更为单路直通 VBUS：
- **电池1 通路**：
  - `PB9` (`O_Bat1_D_PDSG`)：电池1 预放电 MOS。上电时先闭合预充回路，对系统大电容进行限流缓充。
  - `PB6` (`O_Bat1_D_DSG`)：电池1 主放电 MOS。预充完成后导通，承载主供电大电流。
  - `PB7` (`O_Bat1_D_CHG`)：电池1 回充 MOS。双电池并联均衡或外部回充时导通。
- **电池2 通路**：
  - `PC12` (`O_Bat2_D_PDSG`)：电池2 预放电 MOS。
  - `PC11` (`O_Bat2_D_DSG`)：电池2 主放电 MOS。
  - `PC10` (`O_Bat2_D_CHG`)：电池2 回充 MOS。
- **单路总充电控制**：
  - `PB10` (`O_Bat_C_G`)：单路总充电回路背对背 MOS 控制。外部充电器插入时，由此信号控制充电输入直通 `VBUS`。

### 2. 功率保护与外设供电模块 (共 3 个 GPIO 输出)
- `PA5` (`O_Peripheral_G`)：外设供电 MOS 控制。控制板载外设电源分支的开断。
- `PB12` (`O_Power_Release1`)：反电势吸收回路 1 控制。
- `PB11` (`O_Power_Release2`)：反电势吸收回路 2 控制。
  - *注：硬件由旧版的 1 路吸收扩展为 2 路独立吸收保护，当电机刹车等工况产生反向电动势且 VBUS 泵升超限时导通泄放。*

### 3. DCDC 电源使能控制模块 (共 2 个 GPIO 输出)
- `PA7` (`O_Enable_12V`)：12V 隔离电源模块硬件使能脚（低电平驱动 N-MOS 拉低使能端）。
- `PC4` (`O_Enable_24V`)：24V 隔离电源模块硬件使能脚（低电平驱动 N-MOS 拉低使能端）。

### 4. 状态指示与报警模块 (共 4 个 GPIO 输出)
- `PC15` (`O_RGB_R`)：三色状态灯红光控制（N-MOS 驱动低端吸电流）。
- `PC2` (`O_RGB_G`)：三色状态灯绿光控制（N-MOS 驱动低端吸电流）。
- `PC14` (`O_RGB_B`)：三色状态灯蓝光控制（N-MOS 驱动低端吸电流）。
- `PC13` (`O_Alarm`)：蜂鸣器报警控制（高电平导通驱动管使鸣响）。

### 5. 模拟量采样模块 (ADC2 DMA 循环连续采集，共 2 通道)
- `PA4` (`A_Peripheral_Current`)：**ADC2 通道 17 (Rank 1)**。外设负载回路检流采样。
- `PB15` (`A_Vbus_Voltage`)：**ADC2 通道 15 (Rank 2)**。系统主母线 VBUS 电压分压采样。
- *配置参数*：12位分辨率、右对齐、连续扫描模式、DMA 循环传输（DMA1 Channel 2）、DMA Continuous Requests 开启。

### 6. 安全与急停控制 (共 1 个 GPIO 输入)（停用，硬件没接）
- `PD2` (`I_STOP_EN`)：外部急停输入。硬件来源于小脑运控板光耦隔离输出，低电平代表急停触发。

### 7. 通信接口模块 (共 3 路 FDCAN + 1 路 RS485 + 1 路预留串口)
- **FDCAN1**（电池1 BMS 通信）：
  - `PA11`：FDCAN1_RX
  - `PA12`：FDCAN1_TX
- **FDCAN2**（硬件 PB13/PB5，因 PCB 走线与 CAN3 反接，软件已对调为上位机/小脑 RK3588 通信）：
  - `PB5`：FDCAN2_RX（硬件走线接 RK3588）
  - `PB13`：FDCAN2_TX（硬件走线接 RK3588）
- **FDCAN3**（硬件 PB4/PA8，因 PCB 走线与 CAN2 反接，软件已对调为电池2 BMS + 外部充电桩通信）：
  - `PA8`：FDCAN3_RX（硬件走线接 电池2 BMS / 充电桩）
  - `PB4`：FDCAN3_TX（硬件走线接 电池2 BMS / 充电桩）
- **USART2**（无线充电 RS485 通信）：
  - `PA1`：USART2_DE（方向切换控制）
  - `PA3`：USART2_RX
  - `PB3`：USART2_TX
- **LPUART1**（低功耗串口，硬件预留）：
  - `PC0`：LPUART1_RX
  - `PC1`：LPUART1_TX

> **说明（硬件反接软件对调）**：因 PCB 走线将 CAN2 与 CAN3 的外接接口反接，而 STM32G474 物理引脚 AF 映射无法互换，固件已在软件层对调 FDCAN2 与 FDCAN3 控制器职责：由 FDCAN2 接管原 FDCAN3 的所有上位机通信及上报；由 FDCAN3 接管原 FDCAN2 的电池2与充电桩通信。

---

## 三、 V1.0 至 V1.2 引脚迁移速查对照表

| 目标电路 / 功能 | 原 V1.0 引脚 | 新 V1.2 引脚 | 状态变动说明 |
|:---|:---:|:---:|:---|
| 电池1 主放电 MOS | PA0 | **PB6** | 迁移至 PB6 |
| 电池1 回充 MOS | PA4 | **PB7** | 迁移至 PB7 |
| 电池1 预放电 MOS | PB0 | **PB9** | 迁移至 PB9 |
| 电池2 主放电 MOS | PA5 | **PC11** | 迁移至 PC11 |
| 电池2 回充 MOS | PC4 | **PC10** | 迁移至 PC10 |
| 电池2 预放电 MOS | PB1 | **PC12** | 迁移至 PC12 |
| 电池独立充电 MOS | PC12, PC11 | **PB10** | 废弃双路独立充电，改为单路直通 VBUS (PB10) |
| 外设供电 MOS | PB10 | **PA5** | 迁移至 PA5 |
| 反电势保护吸收 | PB11 (1路) | **PB12, PB11** | 扩充为 2 路独立控制 |
| 外设电流采样 | PB2 (ADC2_IN12) | **PA4 (ADC2_IN17)**| 迁移通道与引脚 |
| 母线电压采样 | PB14 (ADC1_IN5) | **PB15 (ADC2_IN15)**| 迁移通道与引脚，合并至 ADC2 |
| 12V / 24V DCDC 使能 | *(无)* | **PA7, PC4** | 新增硬件使能控制 |
| 三色灯 RGB (R/G/B) | *(无)* | **PC15, PC2, PC14** | 新增状态指示灯驱动 |
| 蜂鸣器报警 | *(无)* | **PC13** | 新增报警蜂鸣器驱动 |
| 板载 OLED (I2C1) | PA15, PB7 | *(取消)* | 硬件取消 OLED 接口，释放 I2C1 |
| 腿1~4 电流检测 | PC2, PC3, PC1, PC0 | *(取消)* | 硬件取消，改由电机 CAN 通信读取 |
| 电池电压与充电电流 | PA6, PA7, PA2, PB12, PC5| *(取消)* | 硬件取消，改由 BMS CAN 通信读取 |
