wajmh/D-Y/v1.2新版_电源板原理图_2026-09-17.pdf

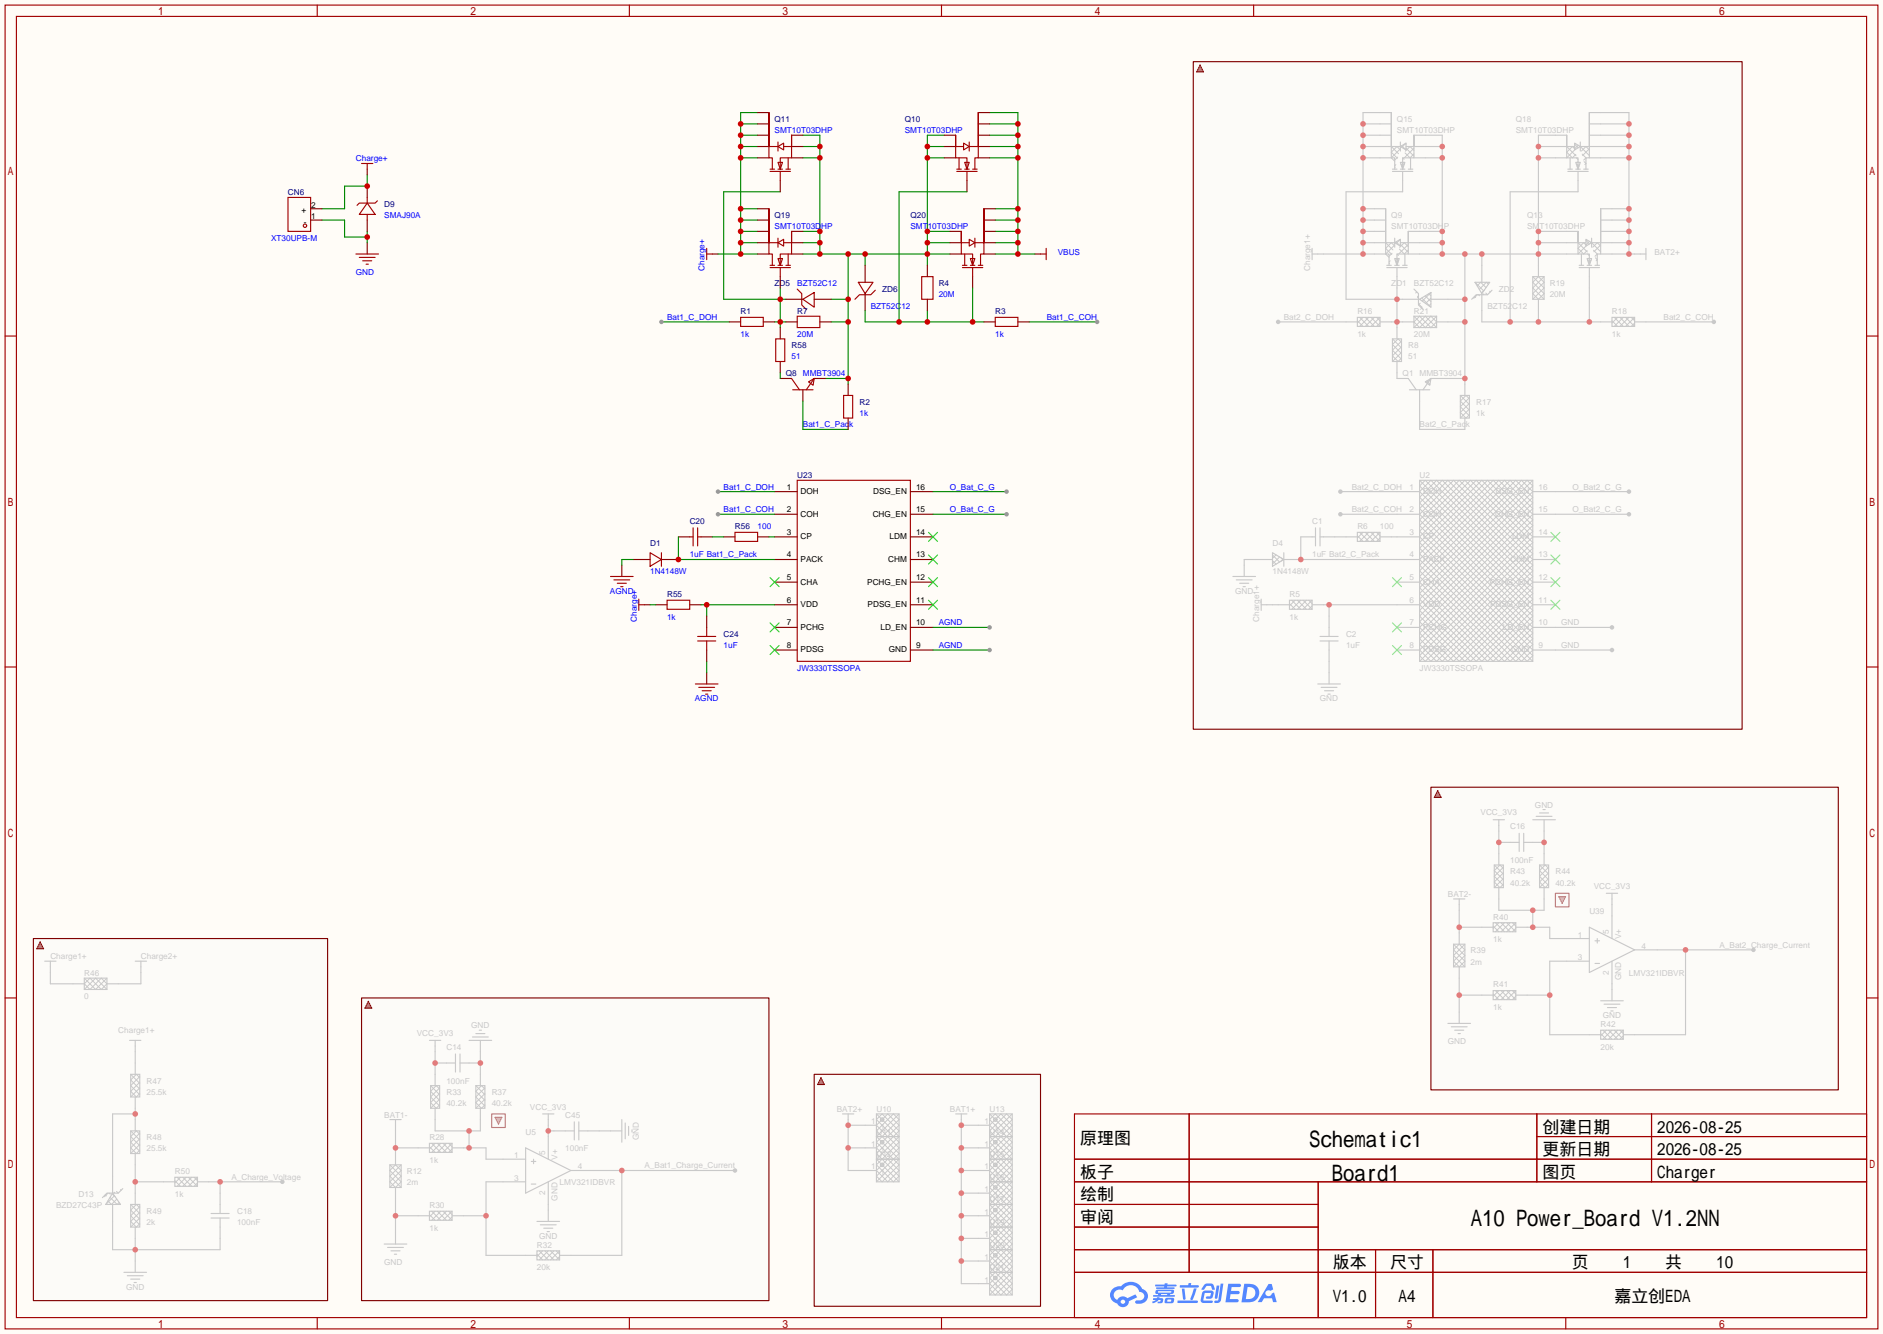
[picture p1: page 1]

原理图 | Schematic1 | 创建日期 | 2026-08-25

更新日期 | 2026-08-25

绘制 | A10 Power_Board V1.2NN
审阅

V1.0 | A4 | 嘉立创EDA

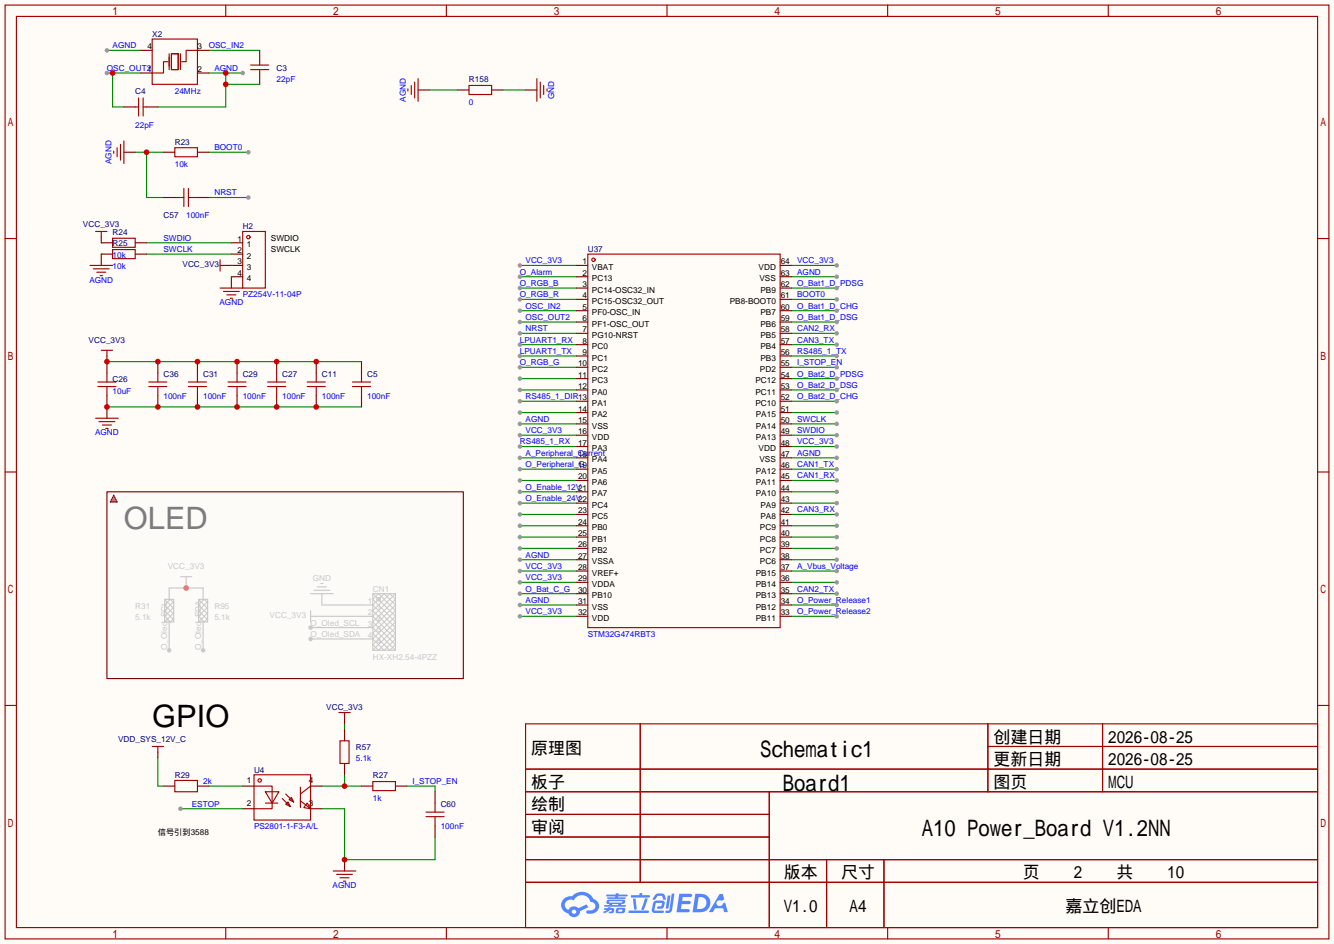
[picture p2: page 2]

原理图 | Schematic1 | 创建日期 | 2026-08-25

更新日期 | 2026-08-25

板子 | Board1 | 图页 | MCU
绘制 | | A10 Power_Board V1.2NN
审阅

72V~12V

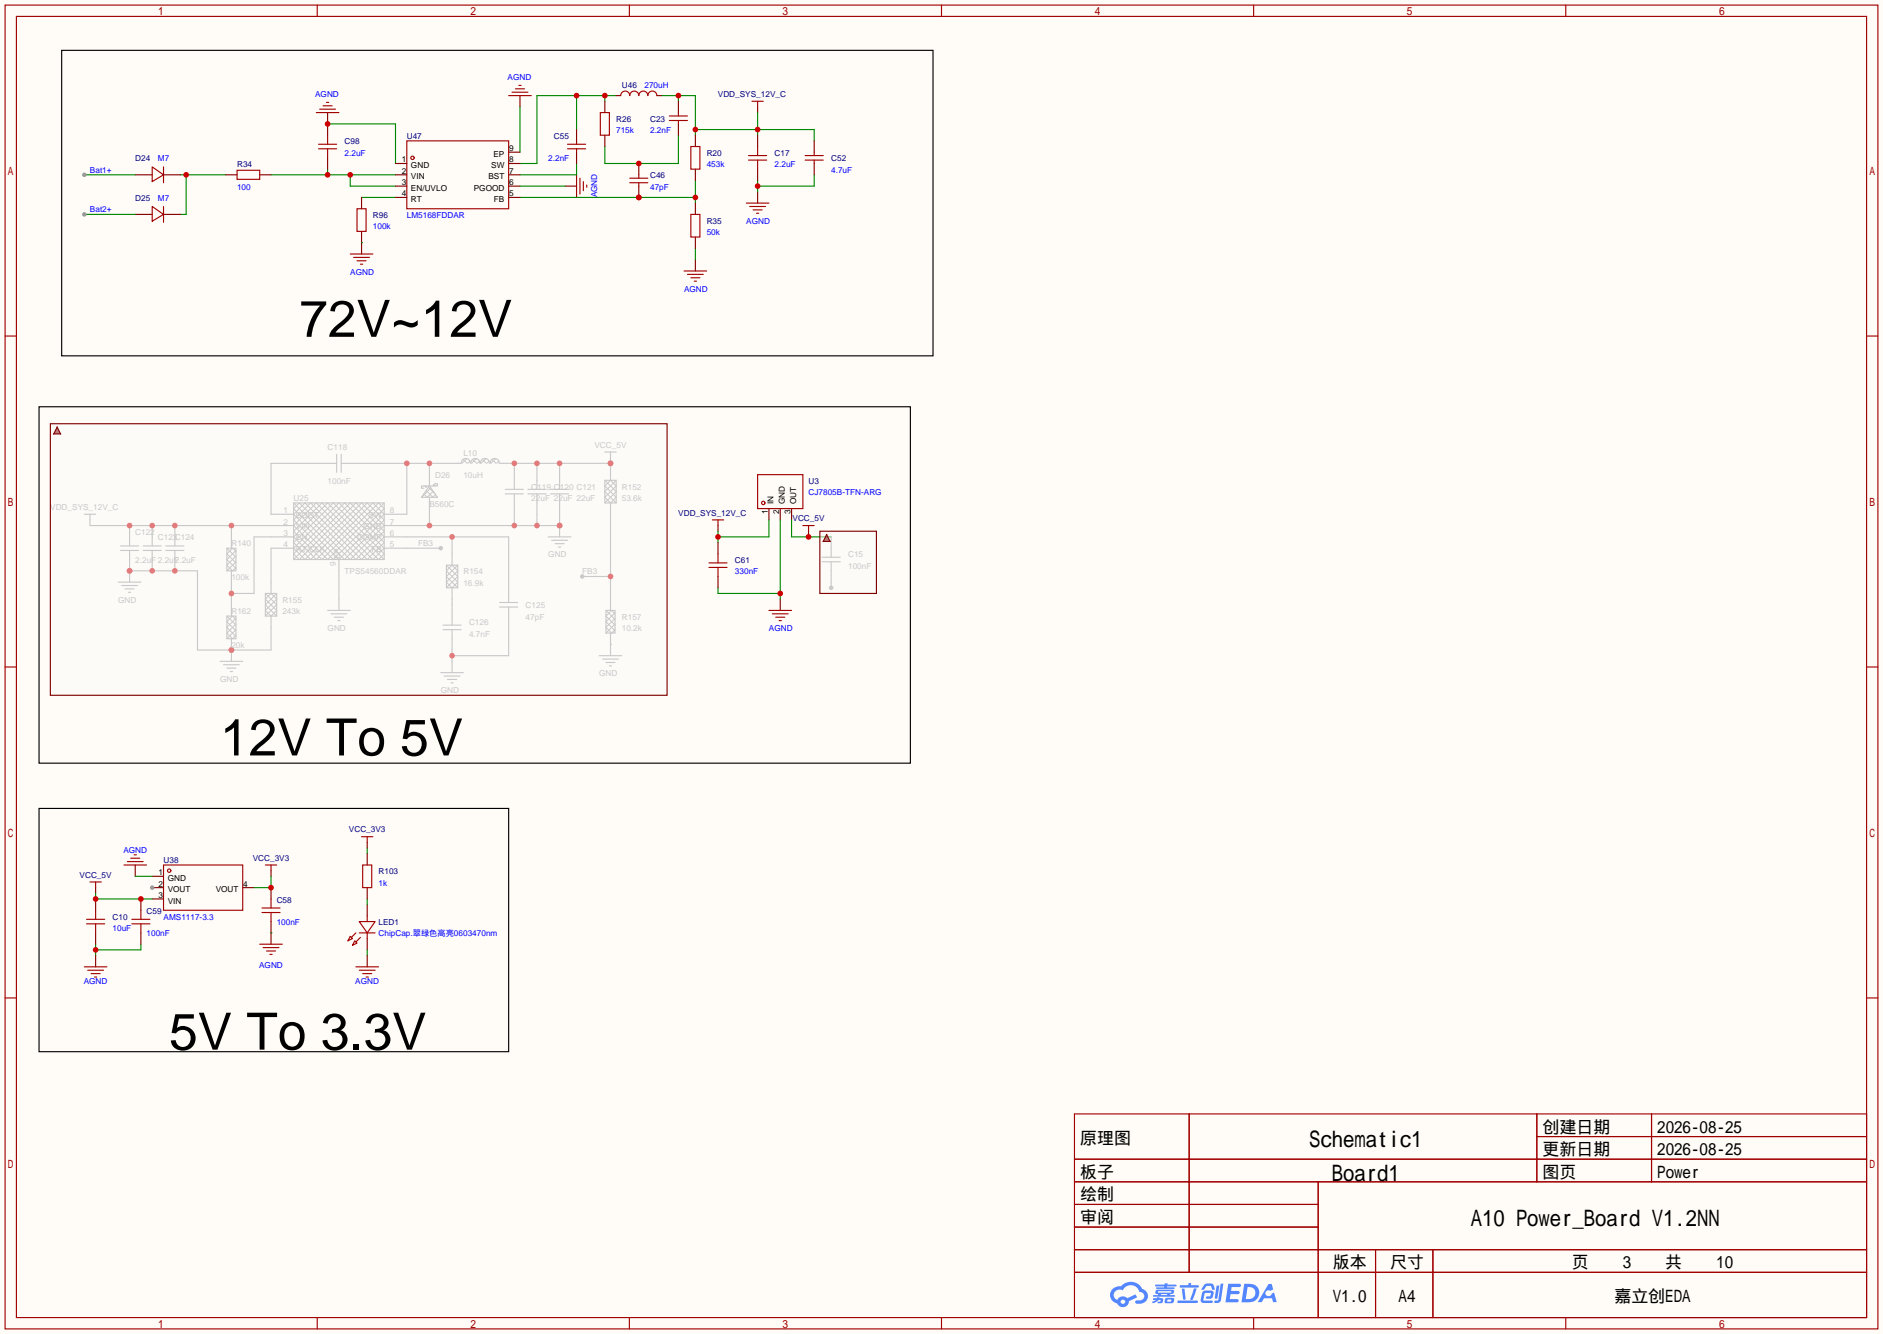
[picture p3: page 3]

原理图 | Schematic1 | 创建日期 | 2026-08-25

更新日期 | 2026-08-25

板子 | Board1 | 图页 | Power
绘制 | | A10 Power_Board V1.2NN
审阅

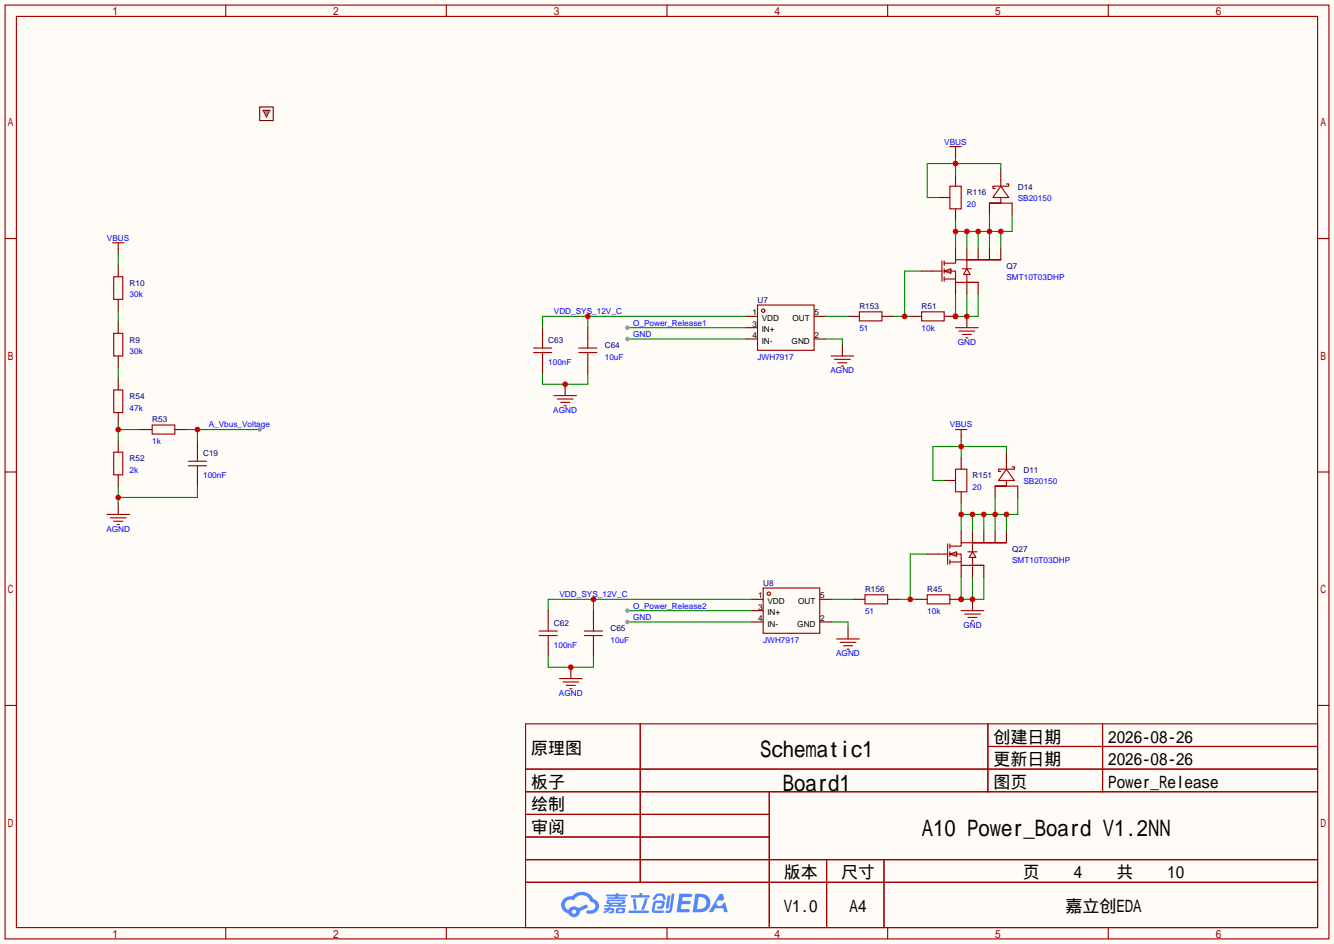
[picture p4: page 4]

原理图 | Schematic1 | 创建日期 | 2026-08-26

更新日期 | 2026-08-26

板子 | Board1 | 图页 | Power_Release
绘制 | | A10 Power_Board V1.2NN
审阅

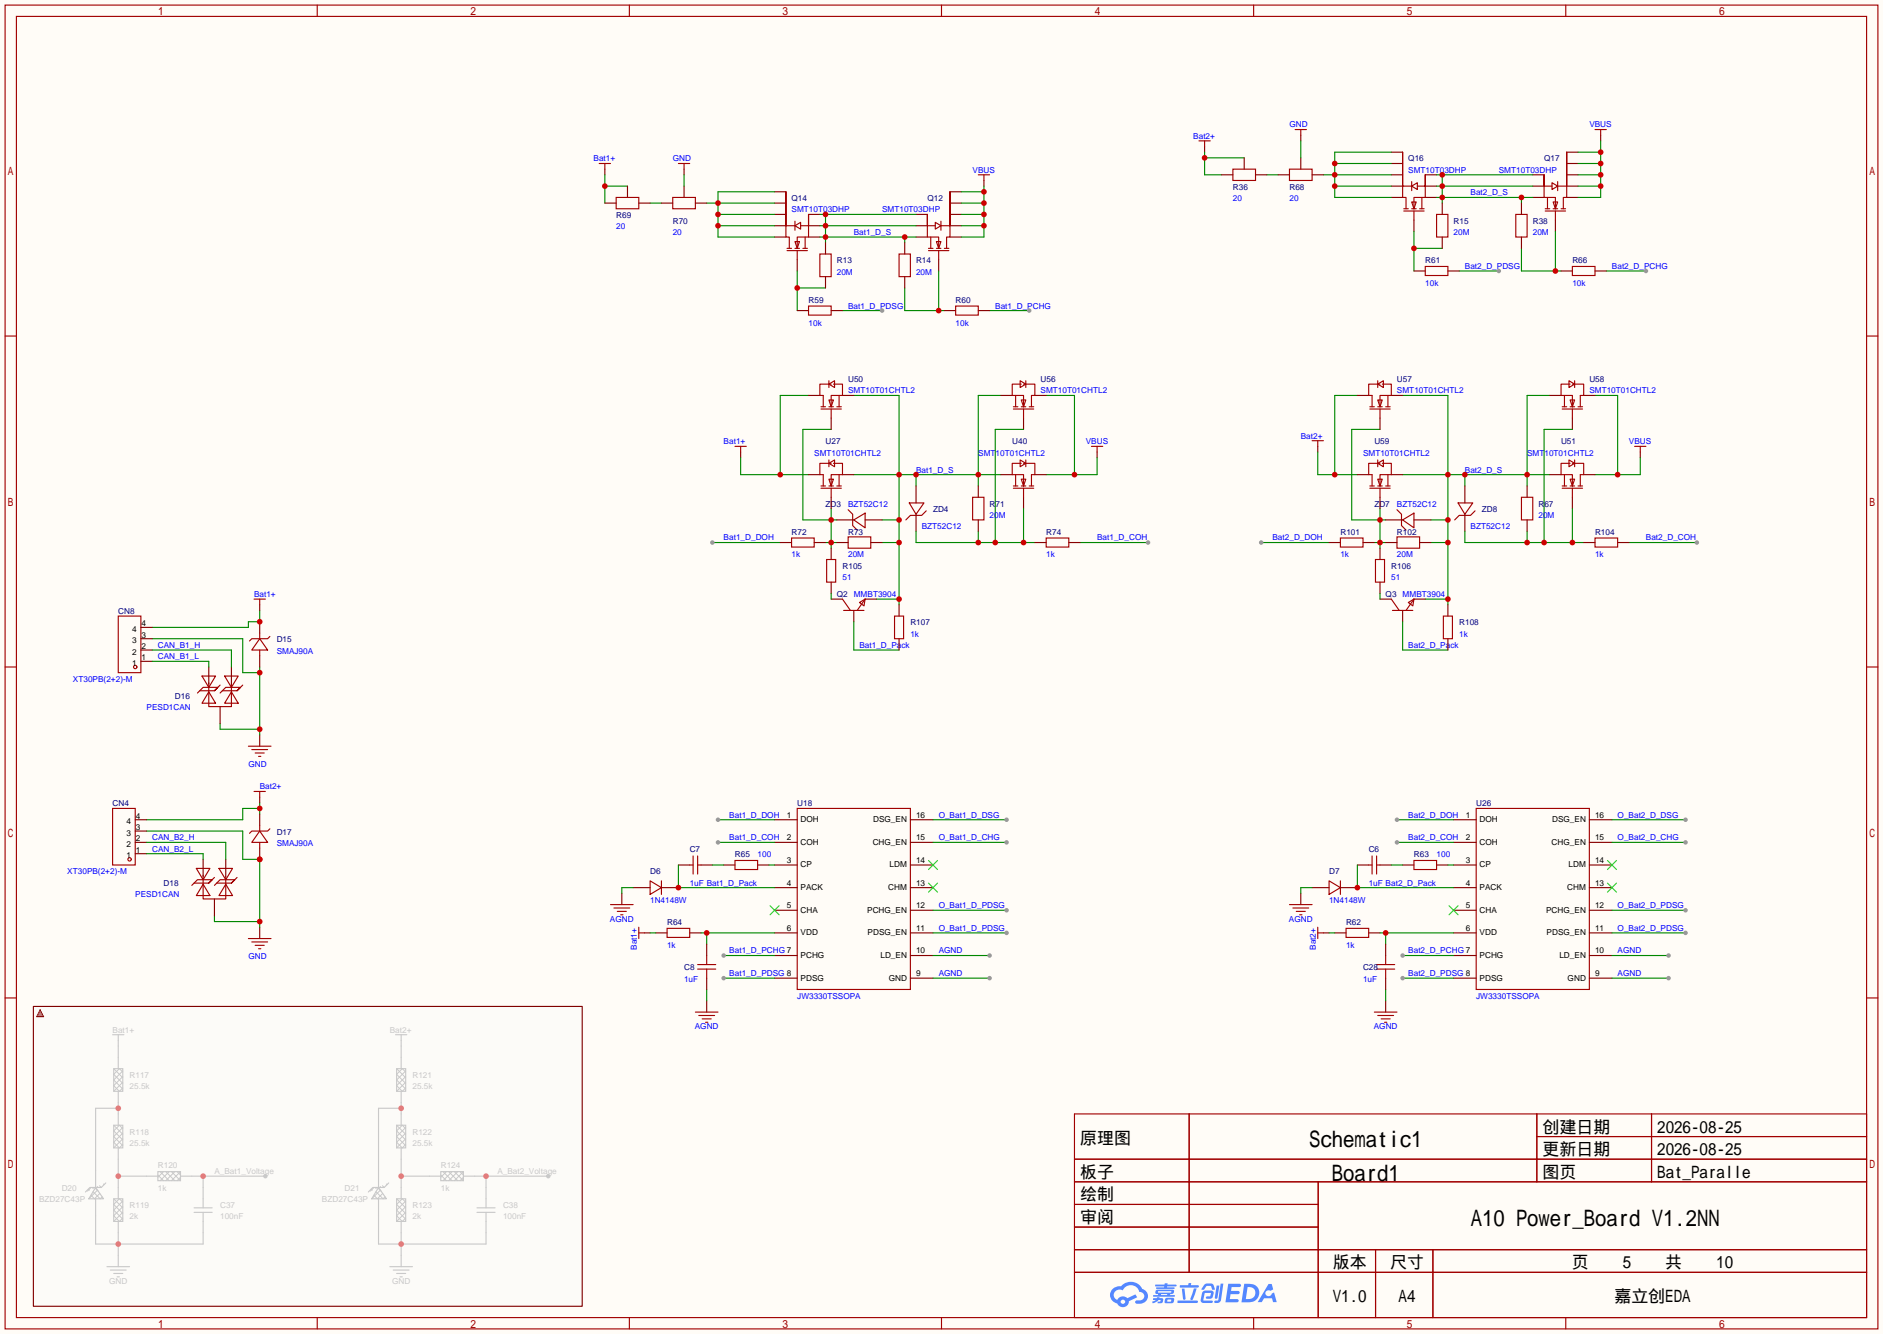
[picture p5: page 5]

原理图 | Schematic1 | 创建日期 | 2026-08-25

更新日期 | 2026-08-25

板子 | Board1 | 图页 | Bat_Paralle
绘制 | | A10 Power_Board V1.2NN
审阅

# XLB20(2)-M + 4 - 3 2 2 1 1

# XLB20(2)-M + 4 - 3 2 2 1 1

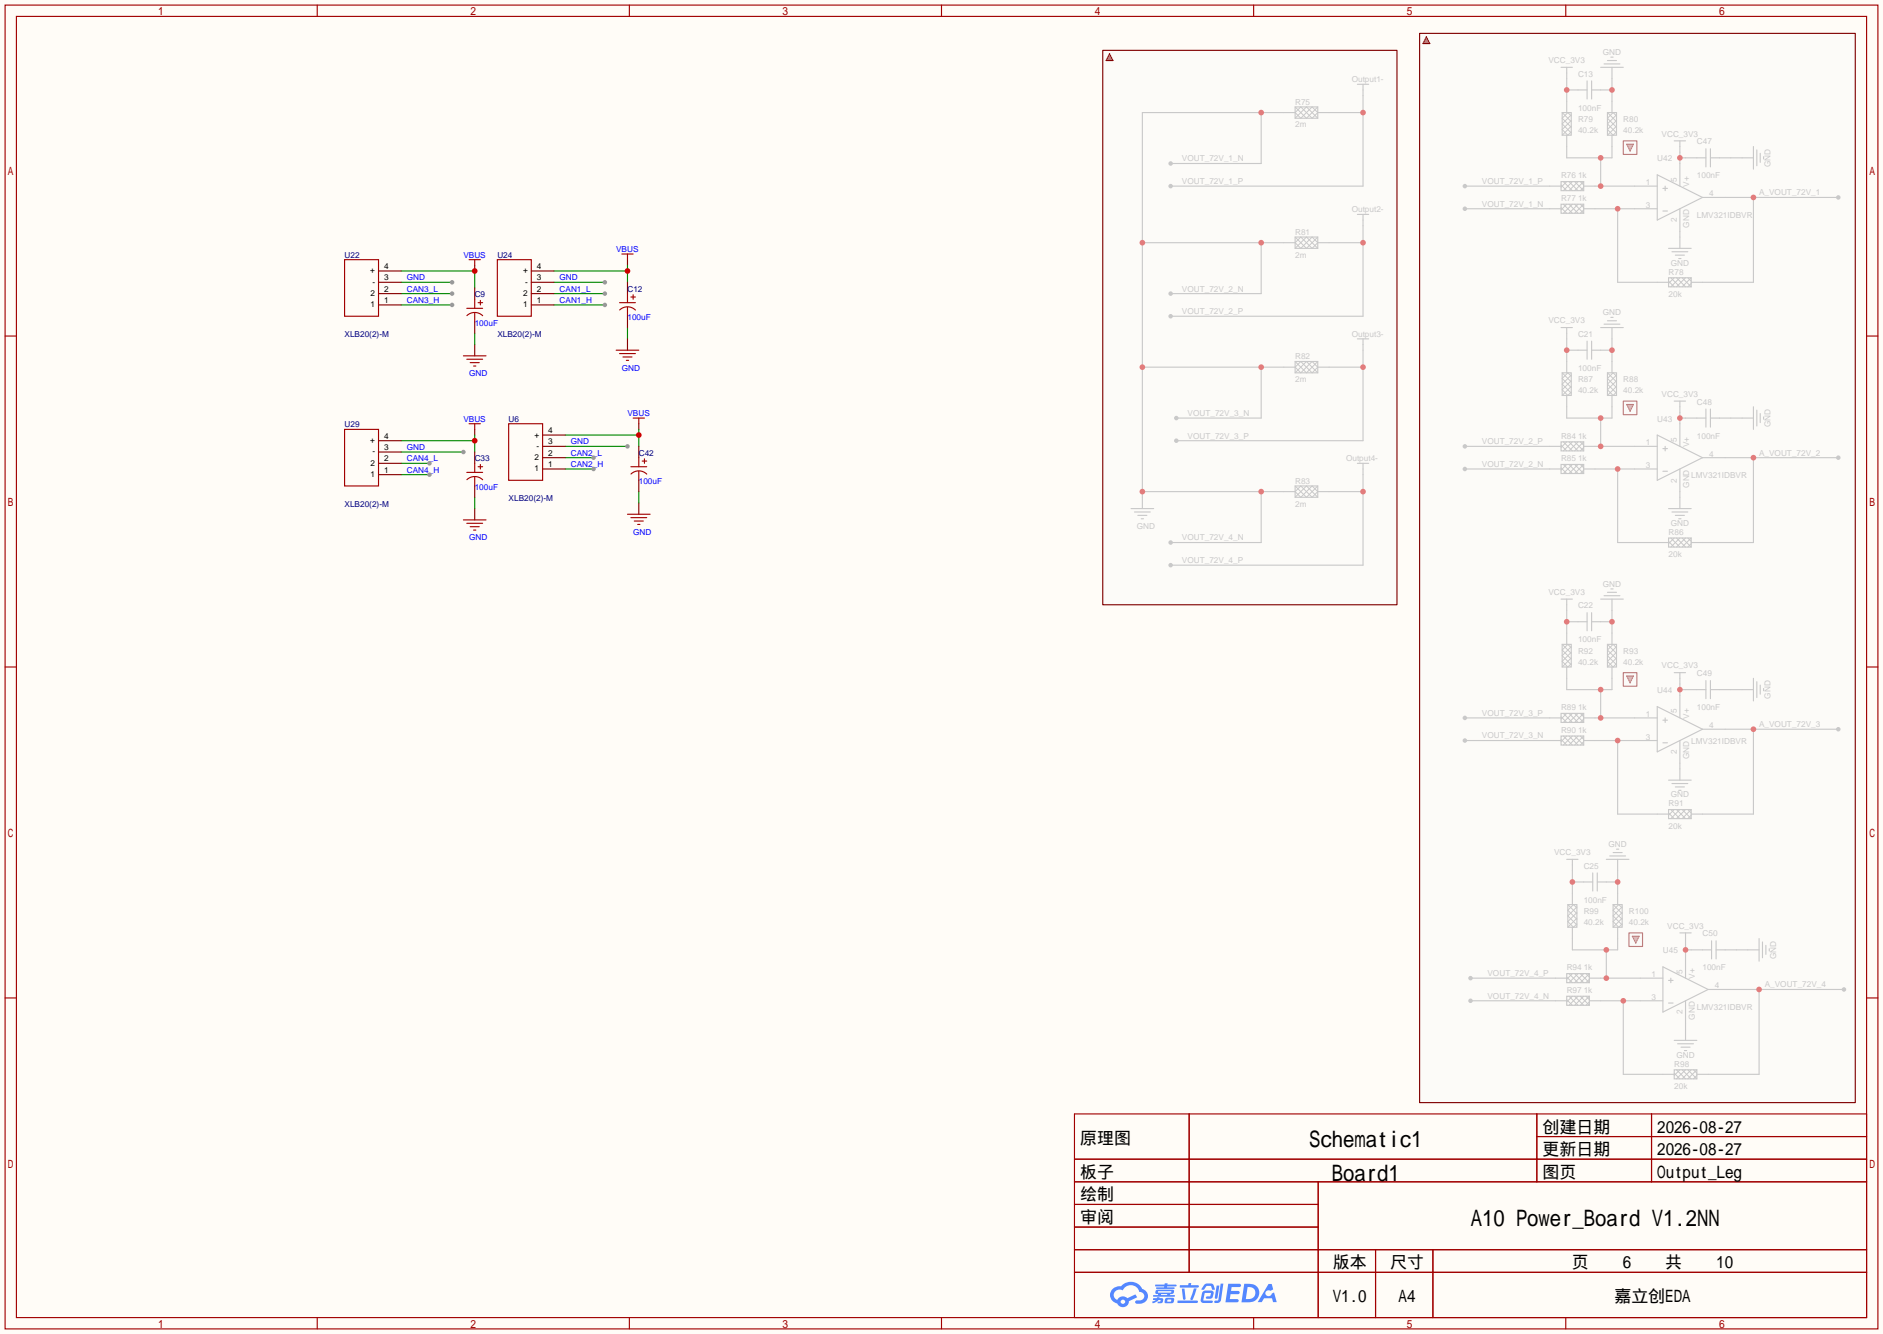
[picture p6: page 6]

原理图 | Schematic1 | 创建日期 | 2026-08-27

更新日期 | 2026-08-27

板子 | Board1 | 图页 | Output_Leg
绘制 | | A10 Power_Board V1.2NN
审阅

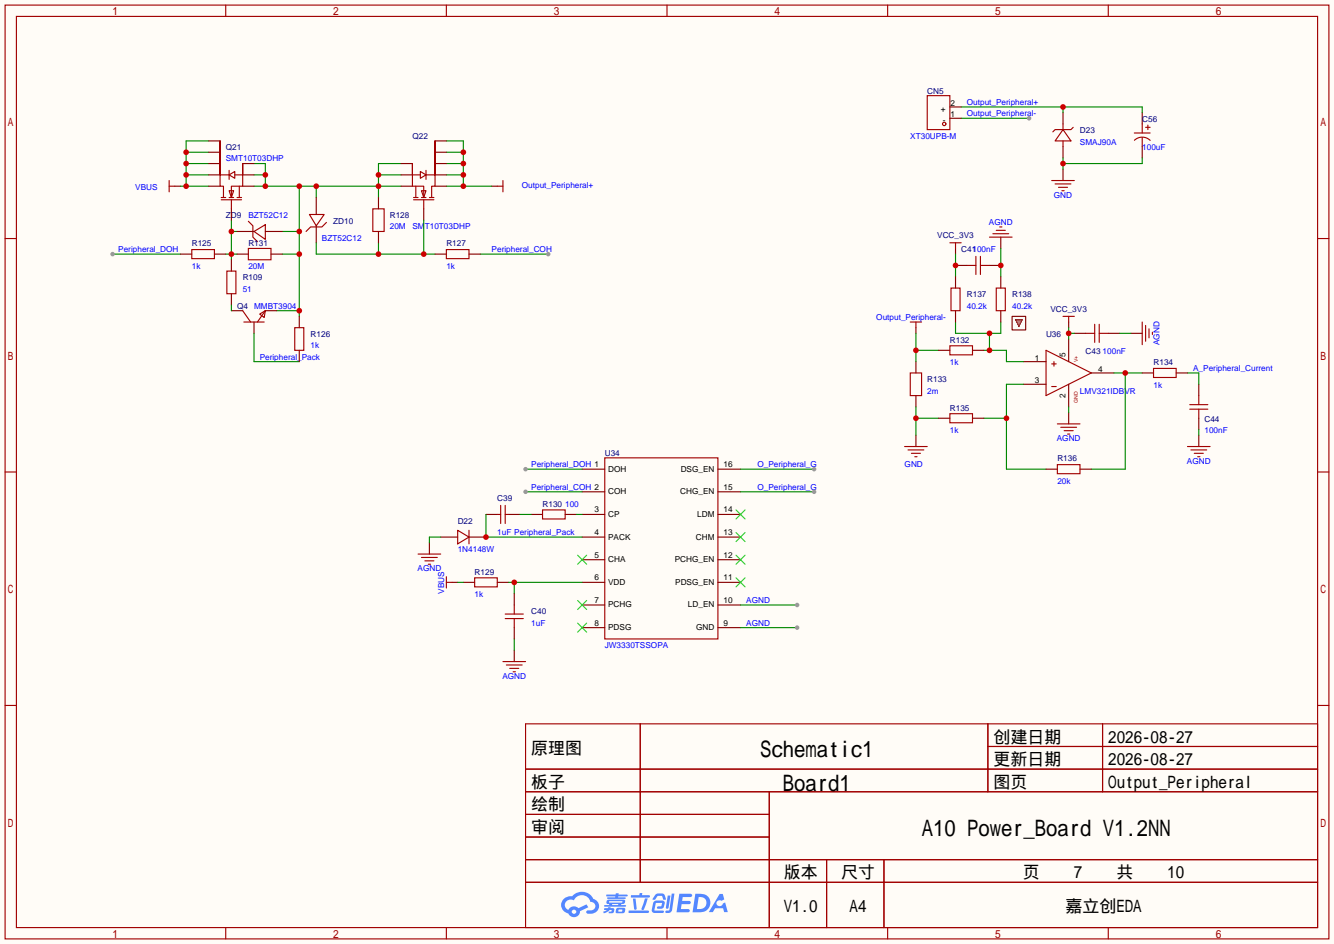
[picture p7: page 7]

原理图 | Schematic1 | 创建日期 | 2026-08-27

更新日期 | 2026-08-27

板子 | Board1 | 图页 | Output_Peripheral
绘制 | | A10 Power_Board V1.2NN
审阅

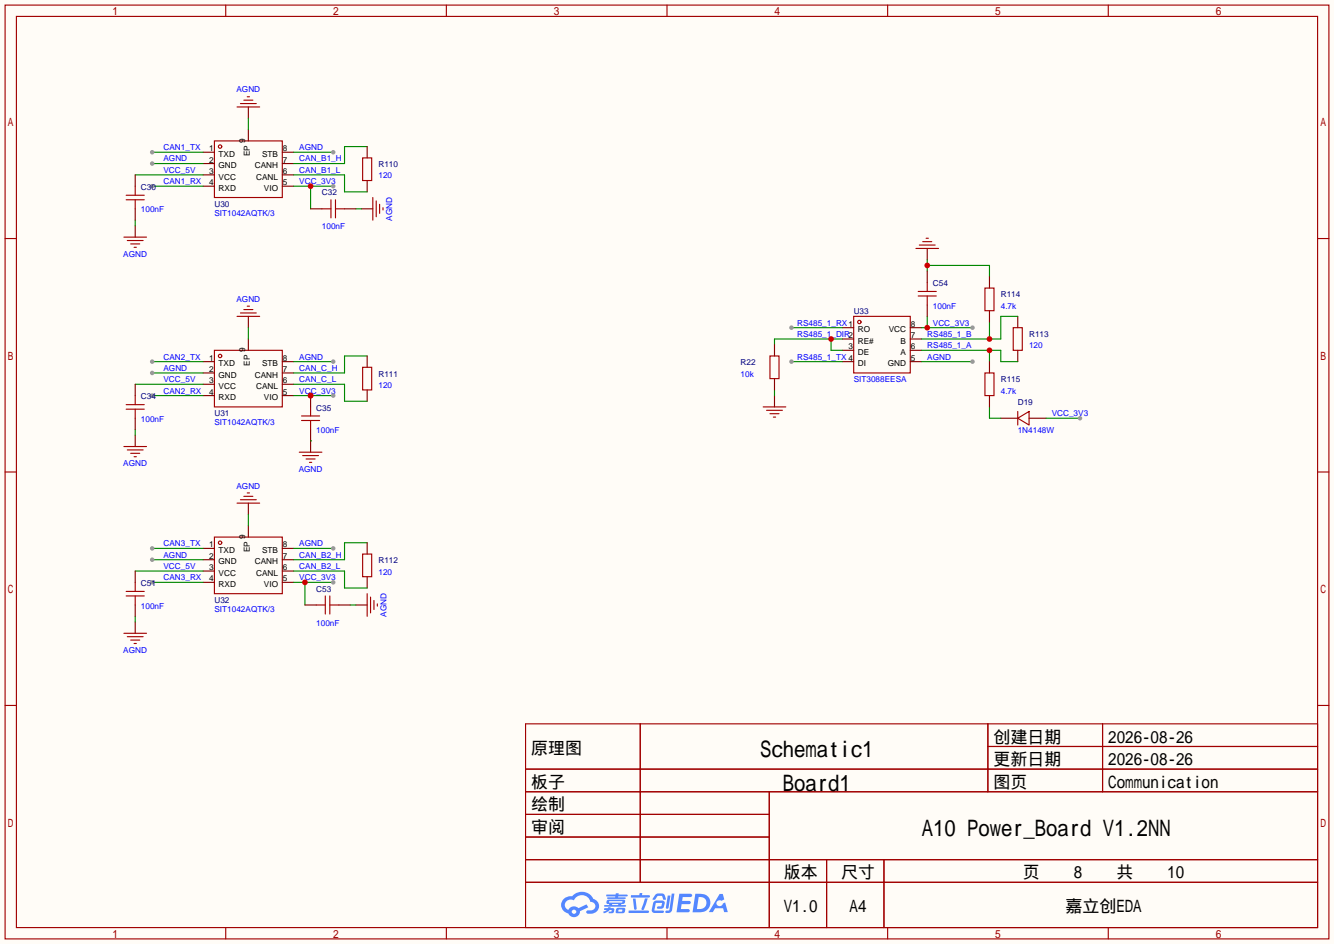
[picture p8: page 8]

原理图 | Schematic1 | 创建日期 | 2026-08-26

更新日期 | 2026-08-26

板子 | Board1 | 图页 | Communication
绘制 | | A10 Power_Board V1.2NN
审阅

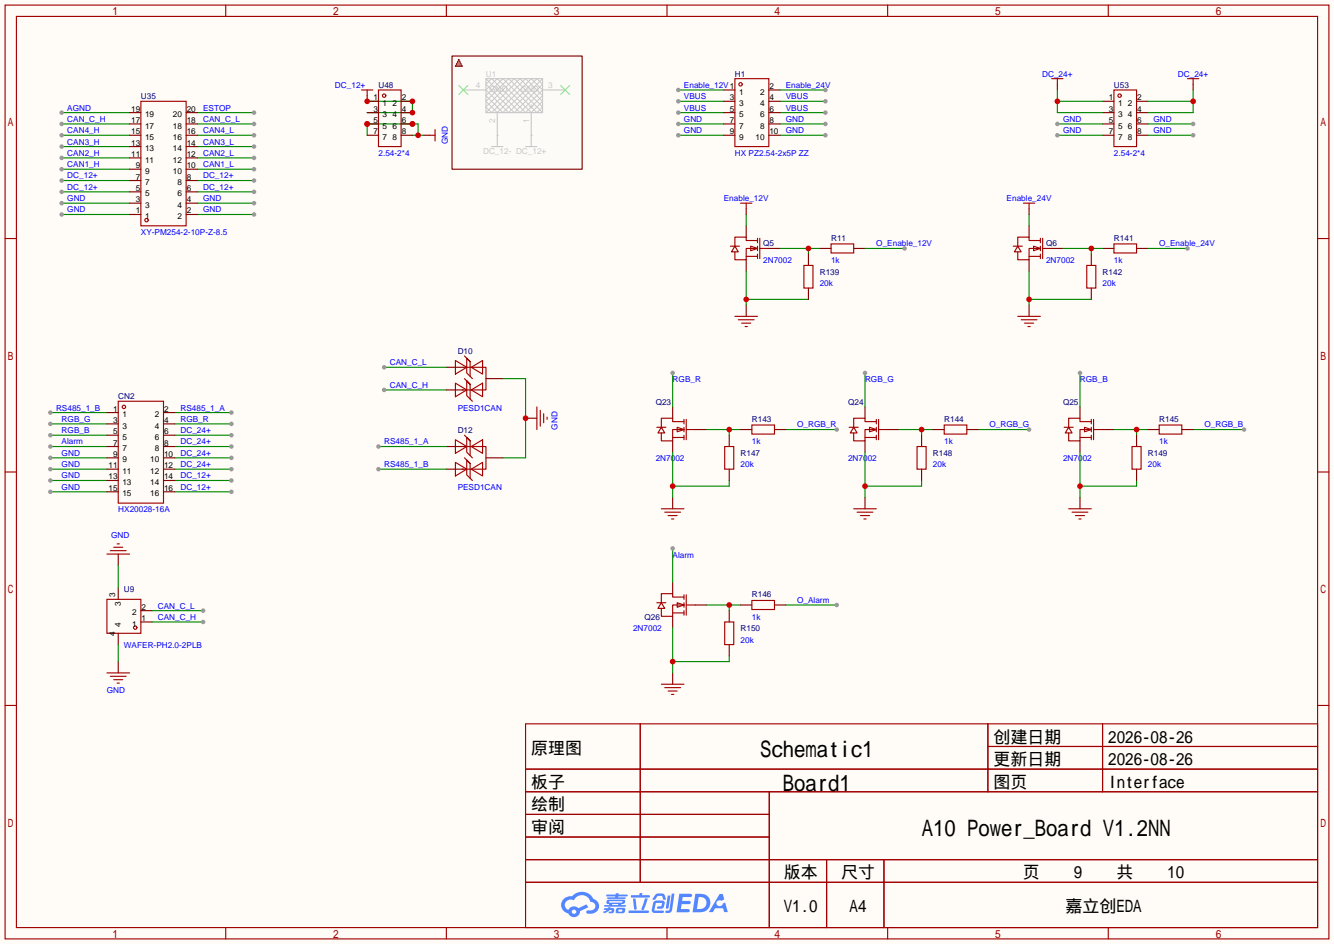
[picture p9: page 9]

原理图 | Schematic1 | 创建日期 | 2026-08-26

更新日期 | 2026-08-26

板子 | Board1 | 图页 | Interface
绘制 | | A10 Power_Board V1.2NN
审阅

原理图 | Schematic1 | 创建日期 | 2026-08-14
| | 更新日期 | 2026-08-14
板子 | Board1 | 图页 | 框图
绘制 | | A10 Power_Board V1.2NN
审阅
版本 | 尺寸 | 页 | 10 | 共 | 10

电池2

电池1

CAN0：电池包1
CAN1：电池包2
CAN3：充电器、RK3588

外设急停
GPIO

反电势保护电路

无线充电485

隔离电源模块
12V输出：20w + 16W雷达
+ 20w交换机 + 15w led 喇叭 UWB
+ 外设 48W = 120W
24V输出： 金升阳 60W

三色灯、蜂鸣器

外设输出管理及电流采样

电源板控制电源DCDC

单片机
STM32G474

充放电控制
GPIO 充电1、
放电4，预充2、外设1个

腿4

腿3

腿2

反向电动势保护电路

腿1

外部输出
电流采样

外部输出
480w

有线充电
CAN

无线充电
485

背对背mos
（双控）

预充mos

预充mos

背对背mos
（双控）

背对背mos
（双控）

背对背mos
（单控）

四条腿一共800w
