wajmh/D-Y/v1.1_电源板原理图_2026-05-09.pdf

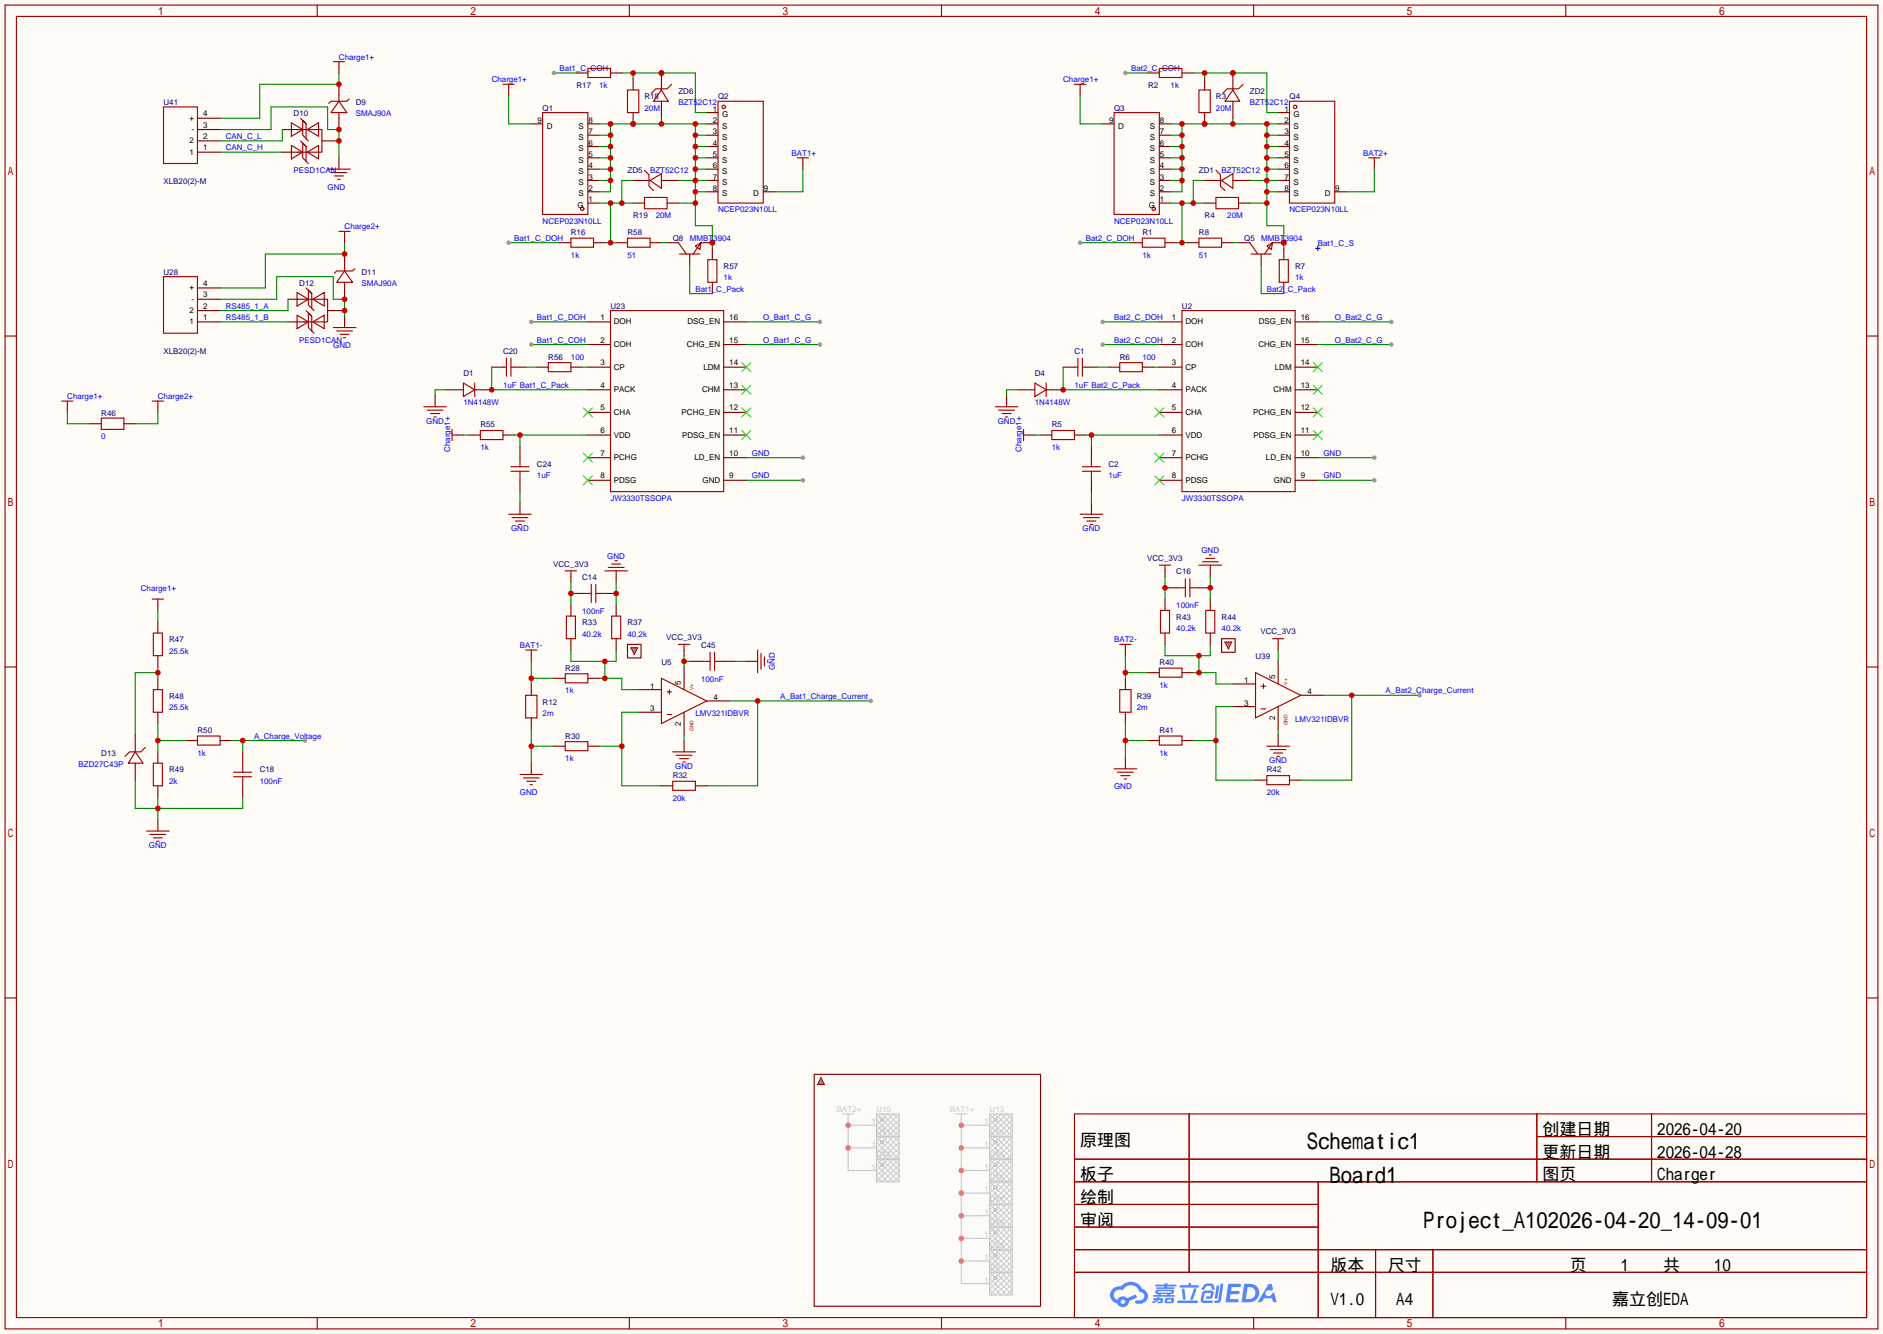
[picture p10: page 1]

原理图 | Schematic1 | 创建日期 | 2026-04-20

更新日期 | 2026-04-28

板子 | Board1 | 图页 | Charger
绘制 | | Project_A102026-04-20_14-09-01
审阅

V1.0 | A4 | 嘉立创EDA

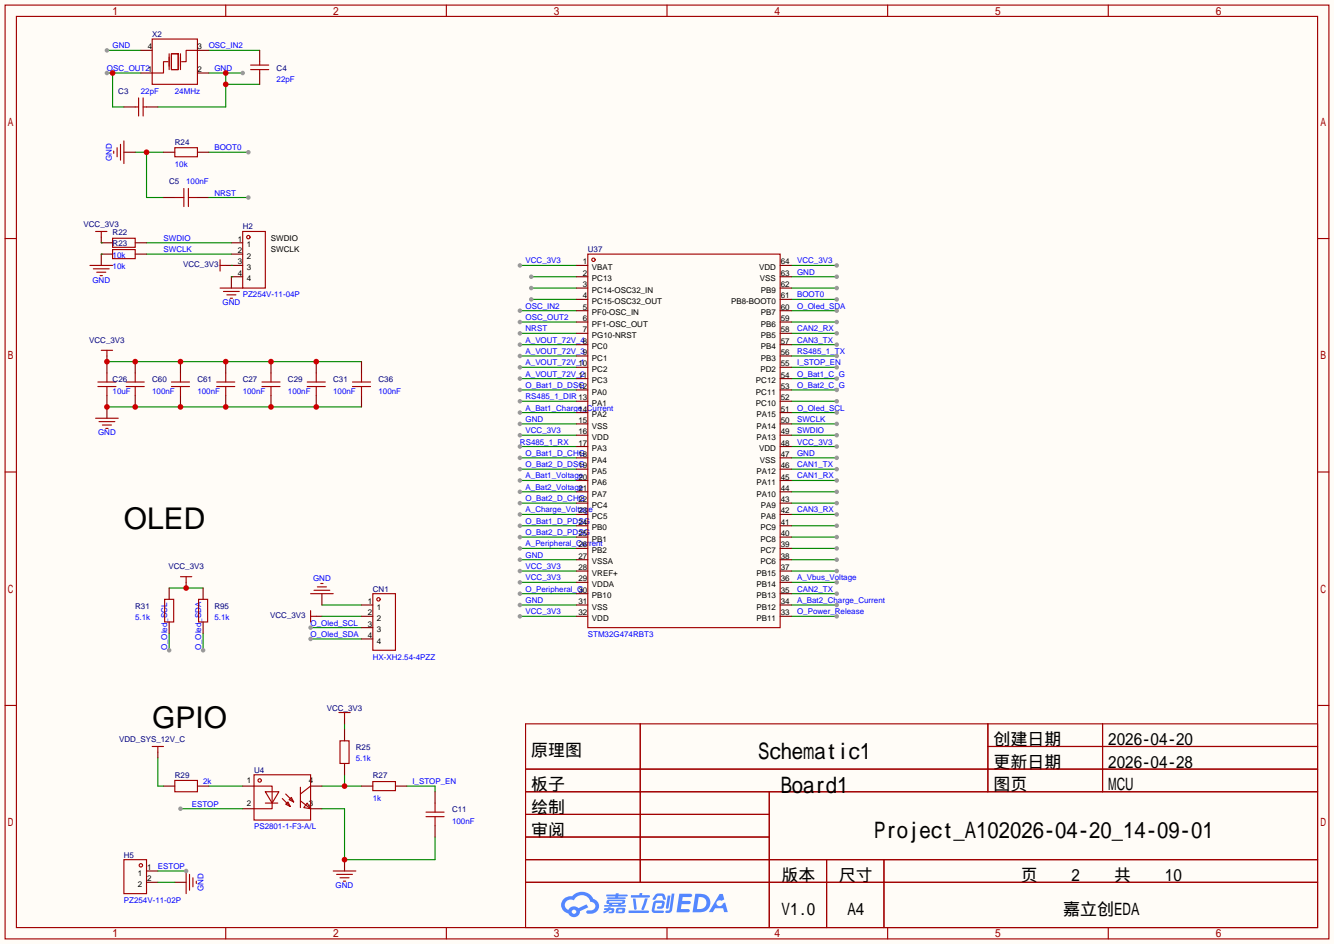
[picture p11: page 2]

原理图 | Schematic1 | 创建日期 | 2026-04-20

更新日期 | 2026-04-28

板子 | Board1 | 图页 | MCU
绘制 | | Project_A102026-04-20_14-09-01
审阅

72V~12V

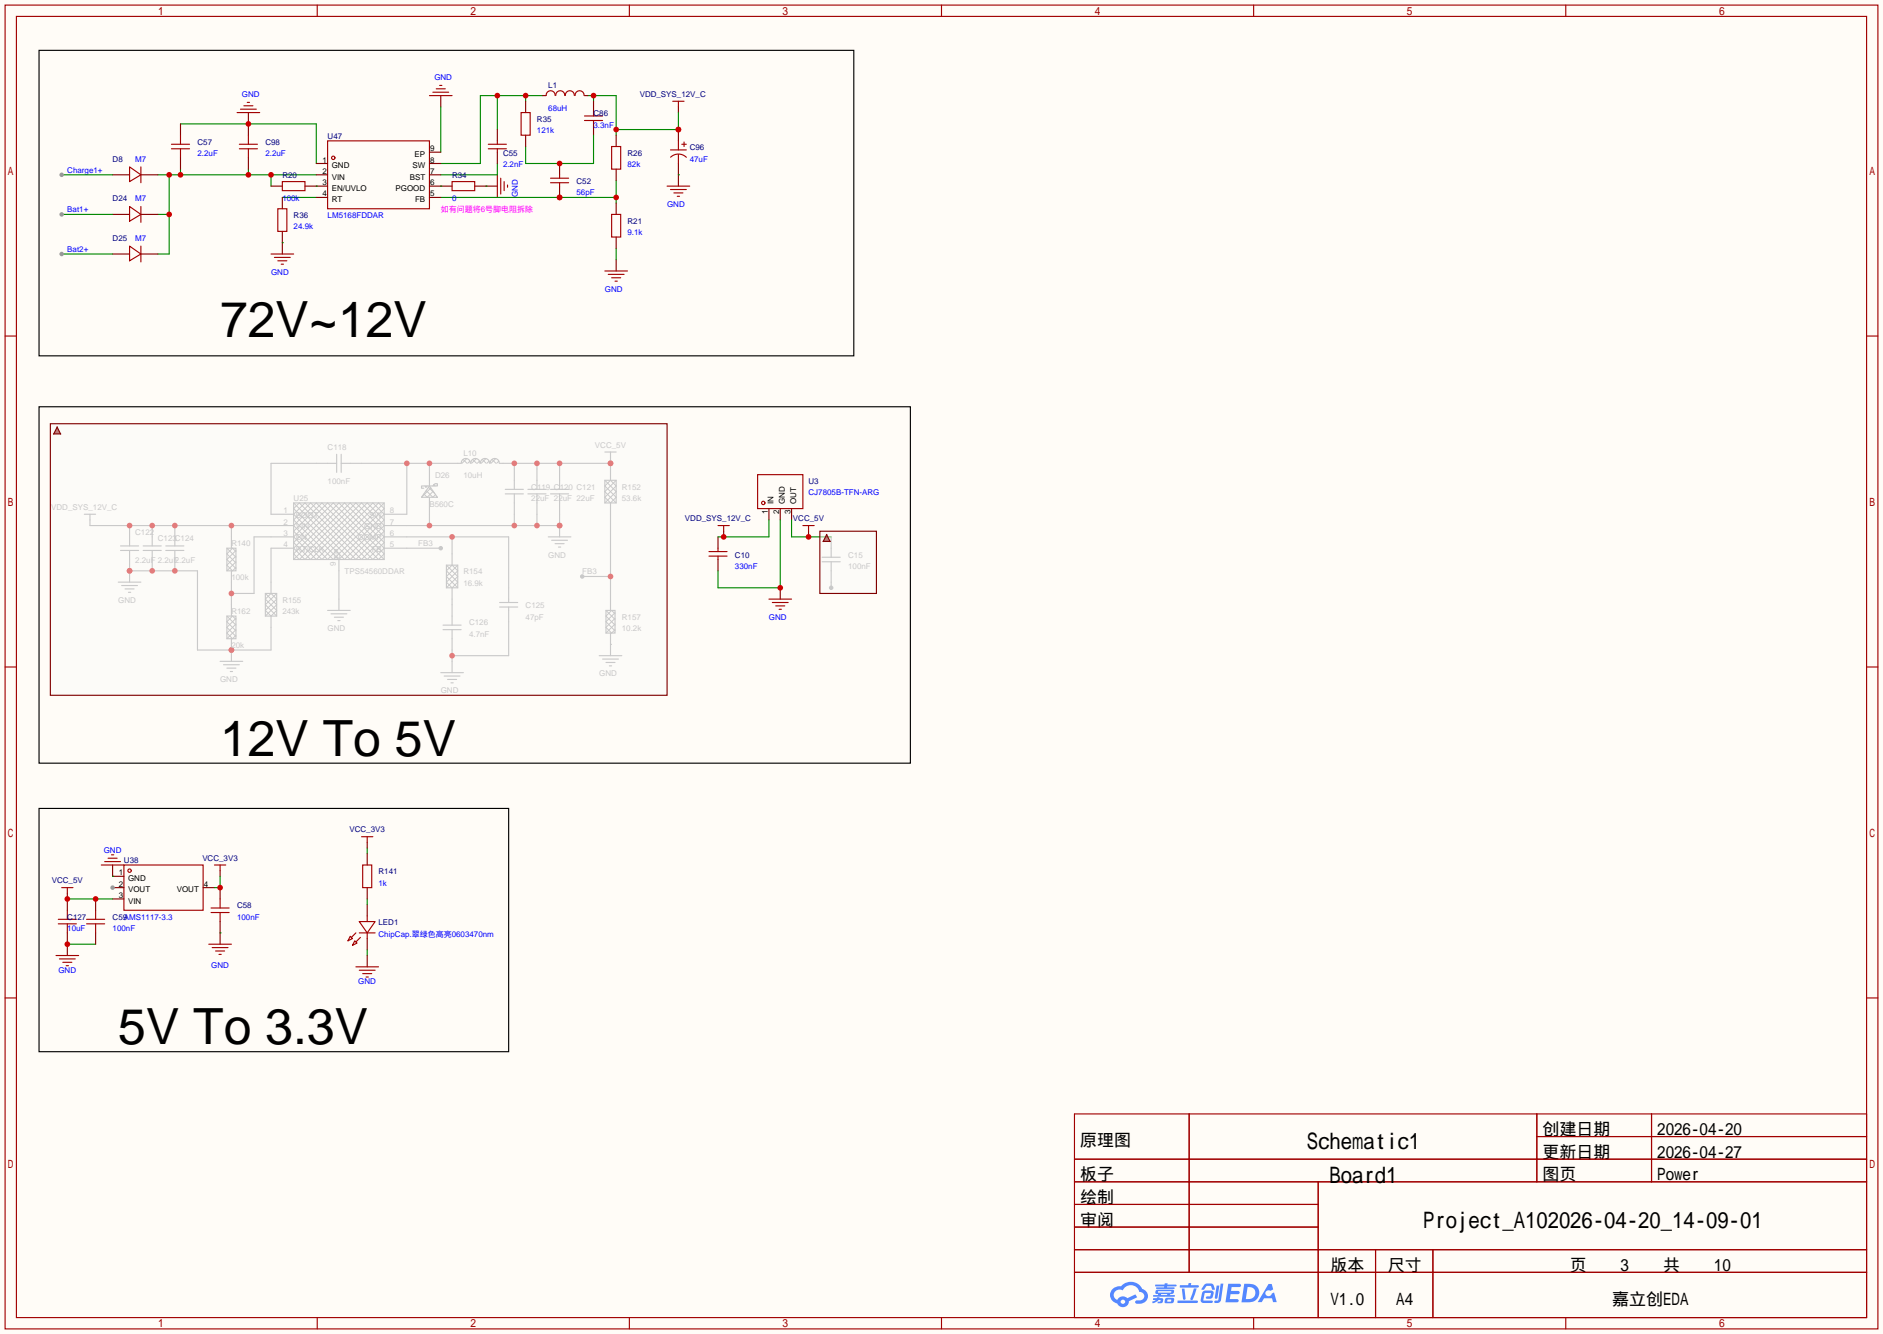
[picture p12: page 3]

原理图 | Schematic1 | 创建日期 | 2026-04-20

更新日期 | 2026-04-27

板子 | Board1 | 图页 | Power
绘制 | | Project_A102026-04-20_14-09-01
审阅

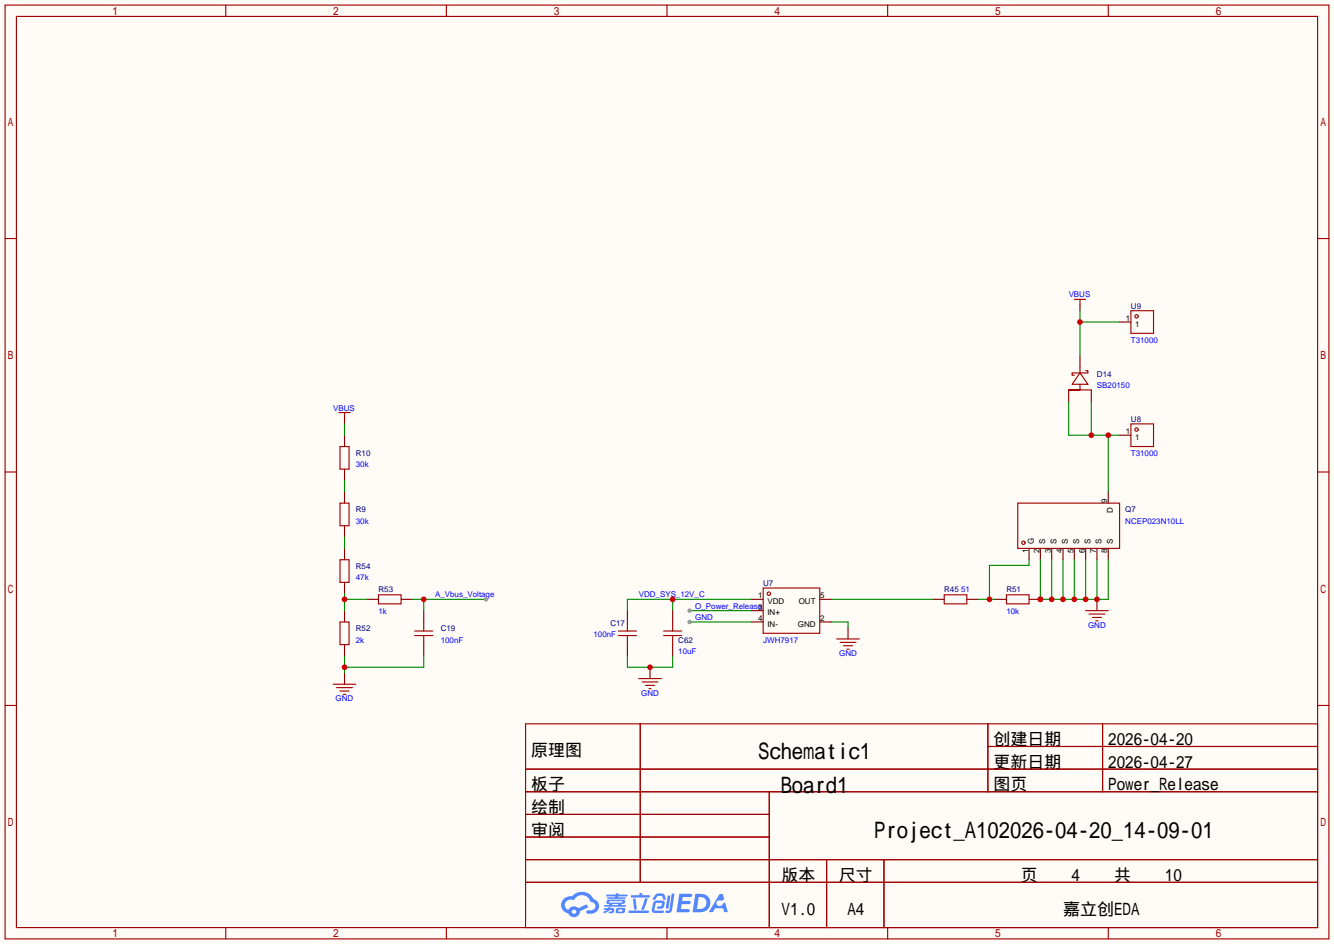
[picture p13: page 4]

原理图 | Schematic1 | 创建日期 | 2026-04-20

更新日期 | 2026-04-27

板子 | Board1 | 图页 | Power_Release
绘制 | | Project_A102026-04-20_14-09-01
审阅

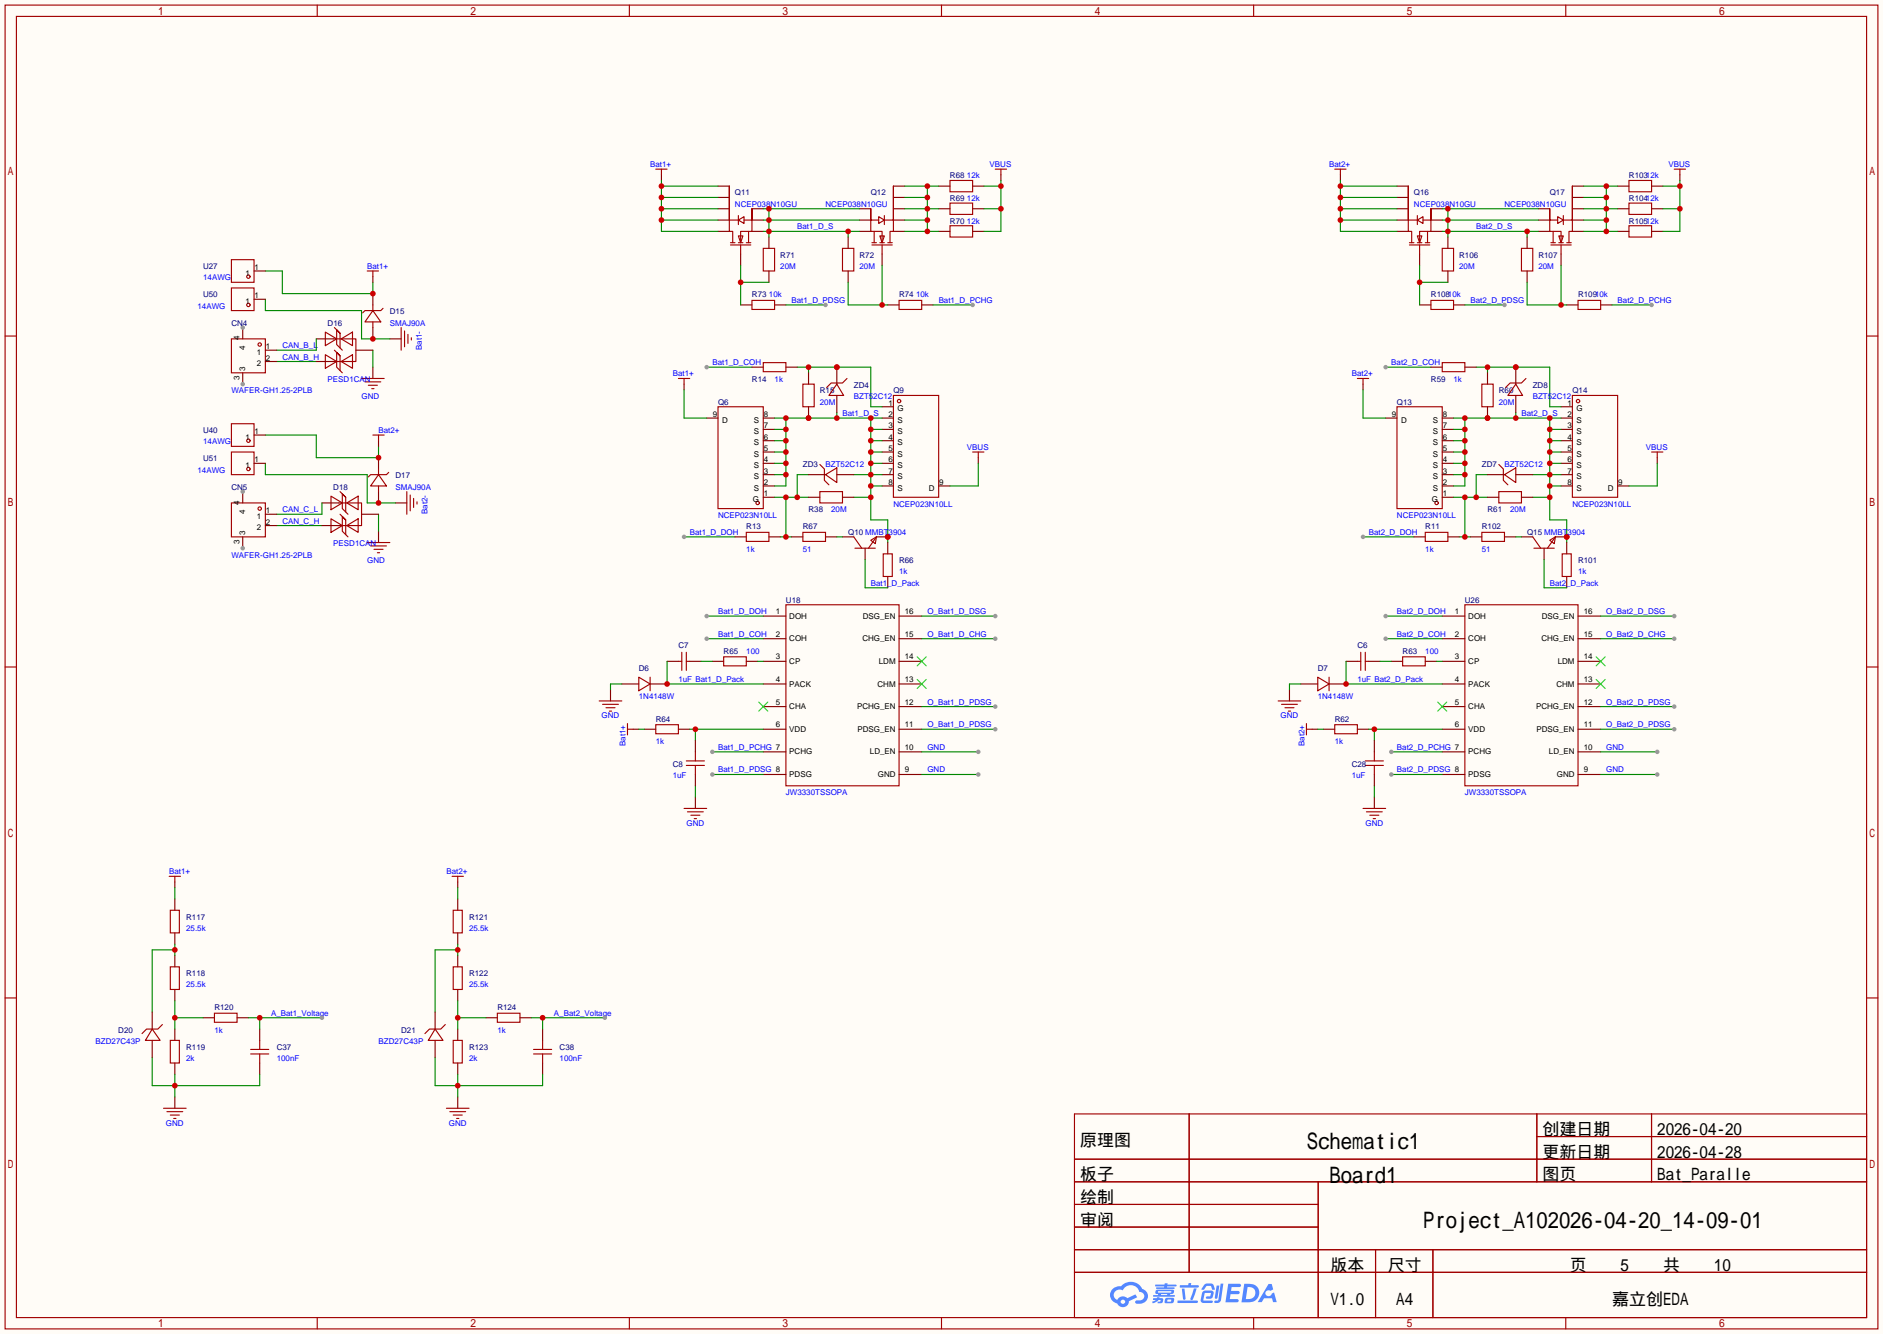
[picture p14: page 5]

原理图 | Schematic1 | 创建日期 | 2026-04-20

更新日期 | 2026-04-28

板子 | Board1 | 图页 | Bat_Paralle
绘制 | | Project_A102026-04-20_14-09-01
审阅

U244

# XLB20(2)-M + 4 - 3 2 2 1 1

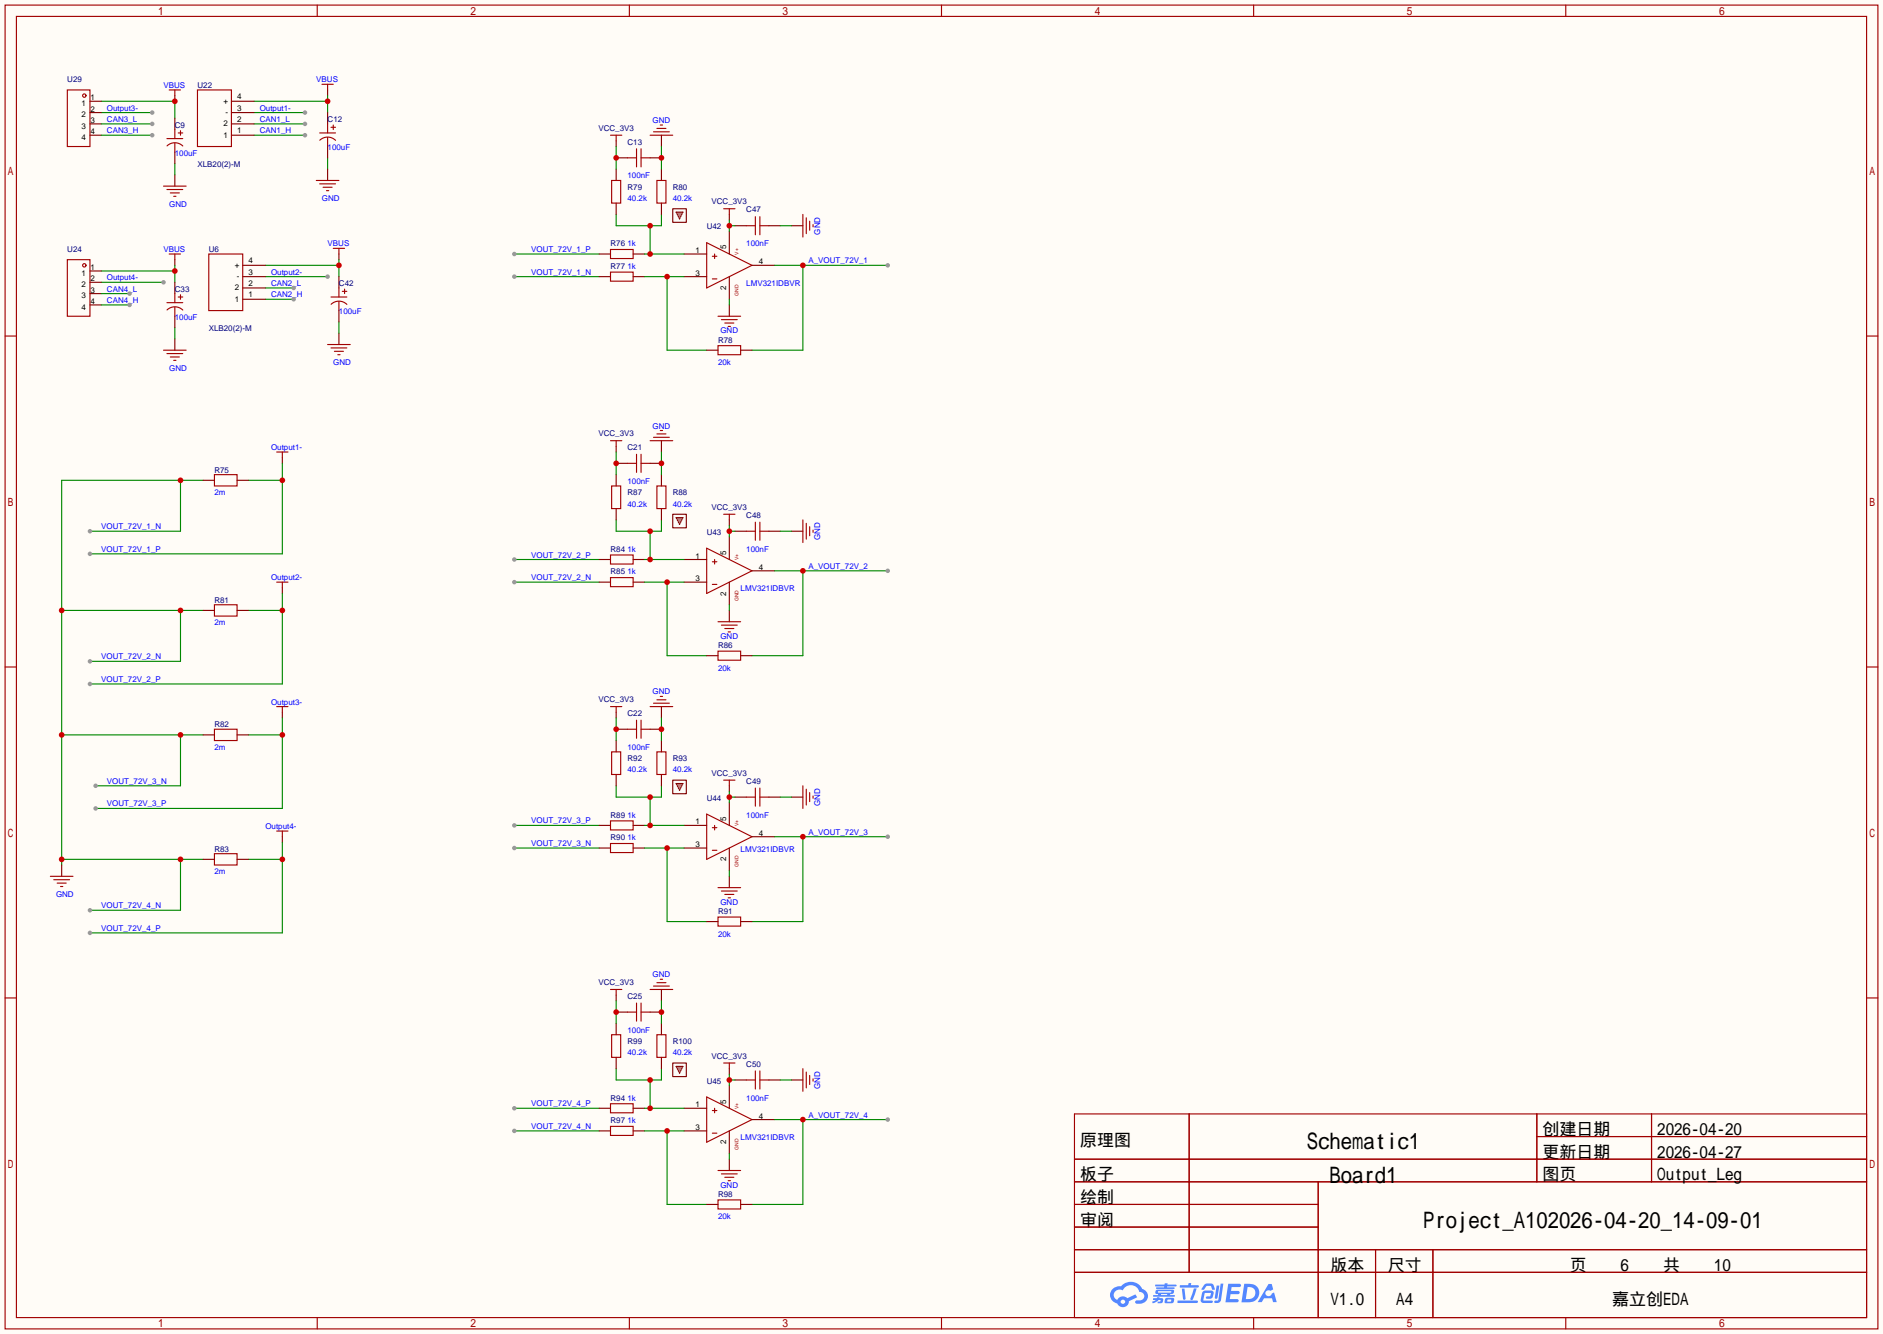
[picture p15: page 6]

原理图 | Schematic1 | 创建日期 | 2026-04-20

更新日期 | 2026-04-27

板子 | Board1 | 图页 | Output_Leg
绘制 | | Project_A102026-04-20_14-09-01
审阅

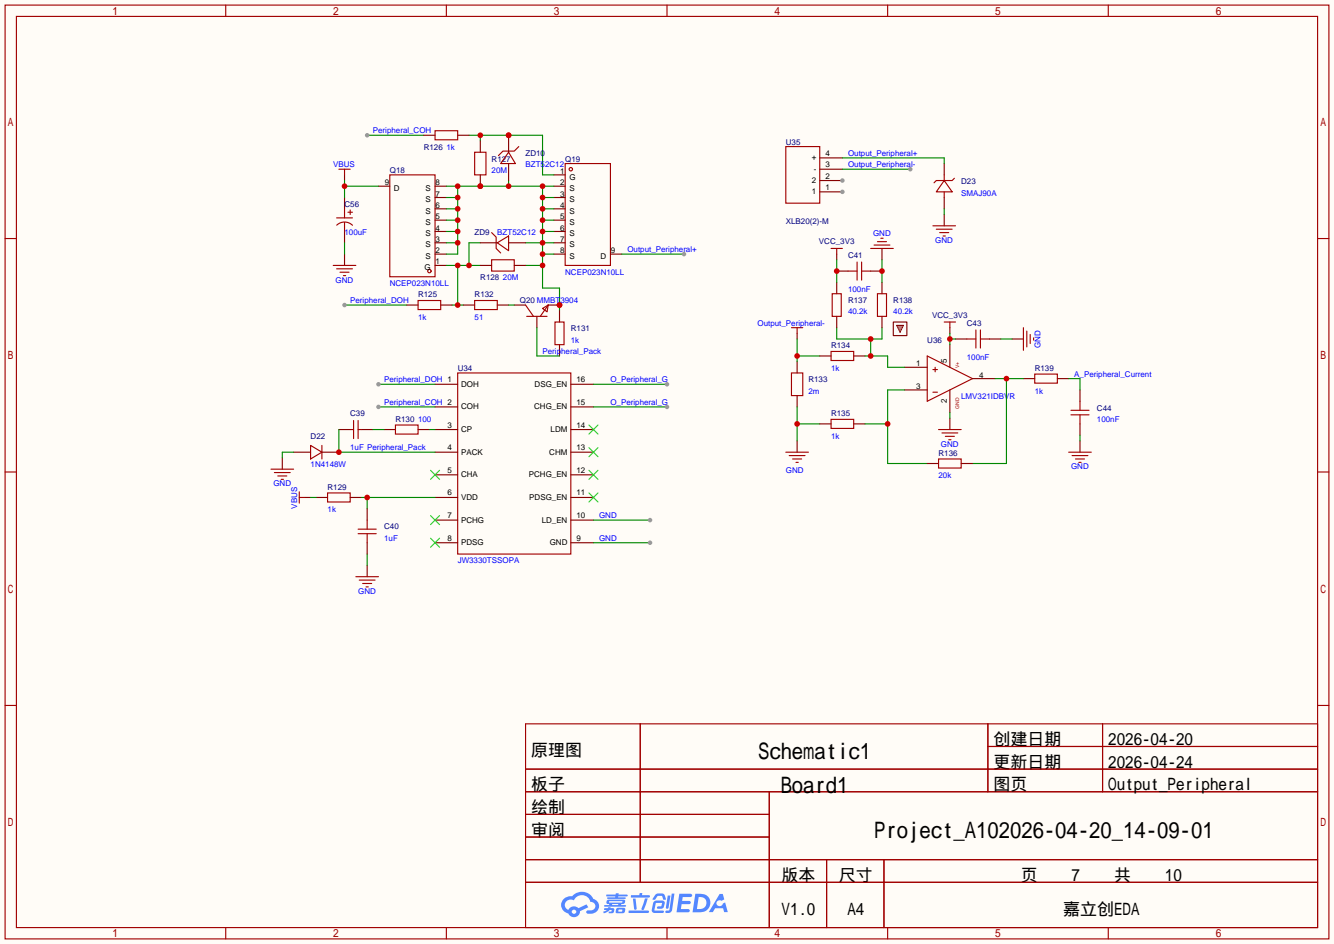
[picture p16: page 7]

原理图 | Schematic1 | 创建日期 | 2026-04-20

更新日期 | 2026-04-24

板子 | Board1 | 图页 | Output_Peripheral
绘制 | | Project_A102026-04-20_14-09-01
审阅

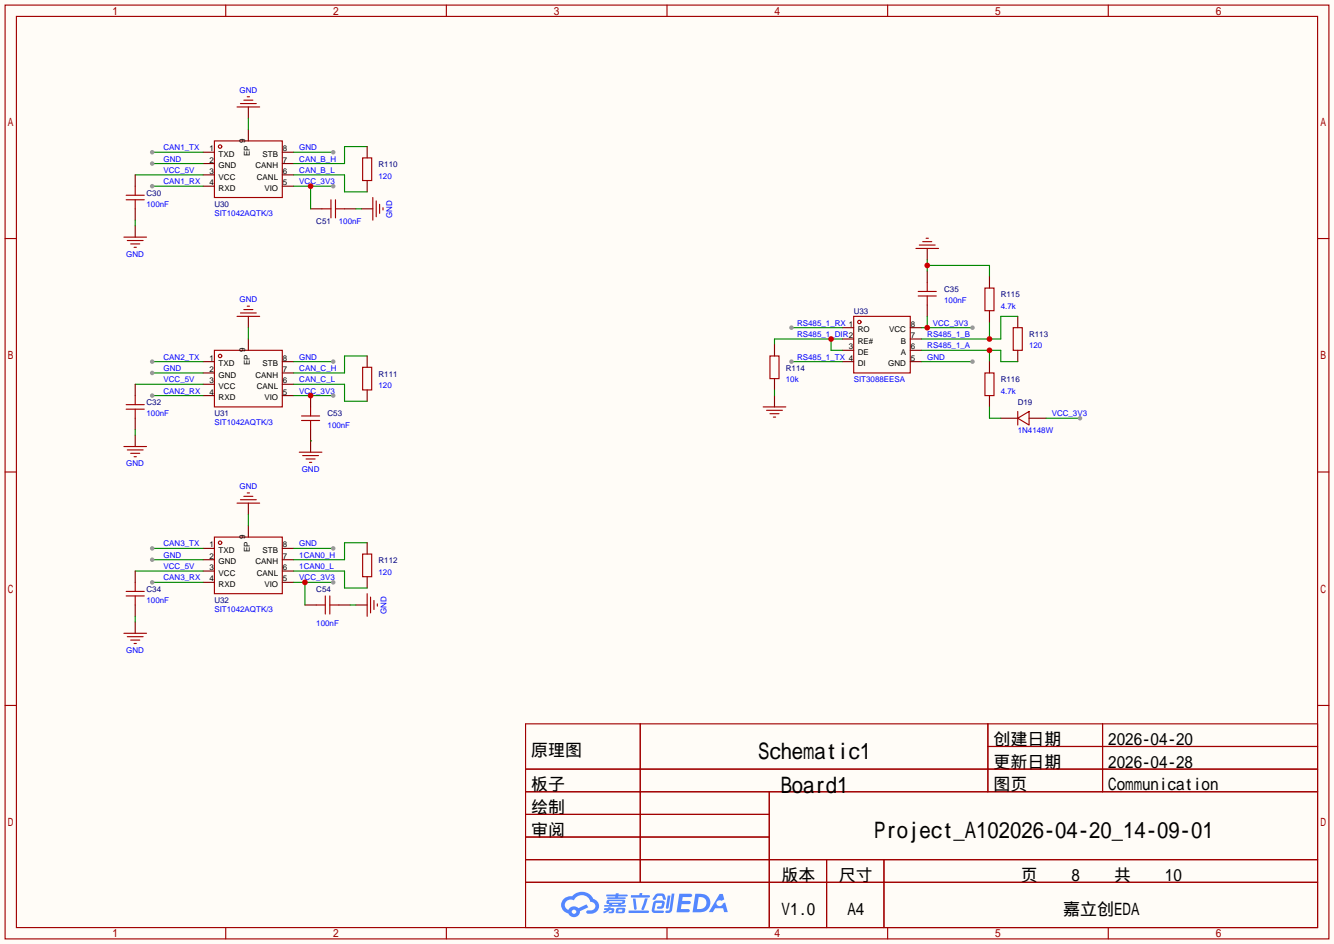
[picture p17: page 8]

原理图 | Schematic1 | 创建日期 | 2026-04-20

更新日期 | 2026-04-28

板子 | Board1 | 图页 | Communication
绘制 | | Project_A102026-04-20_14-09-01
审阅

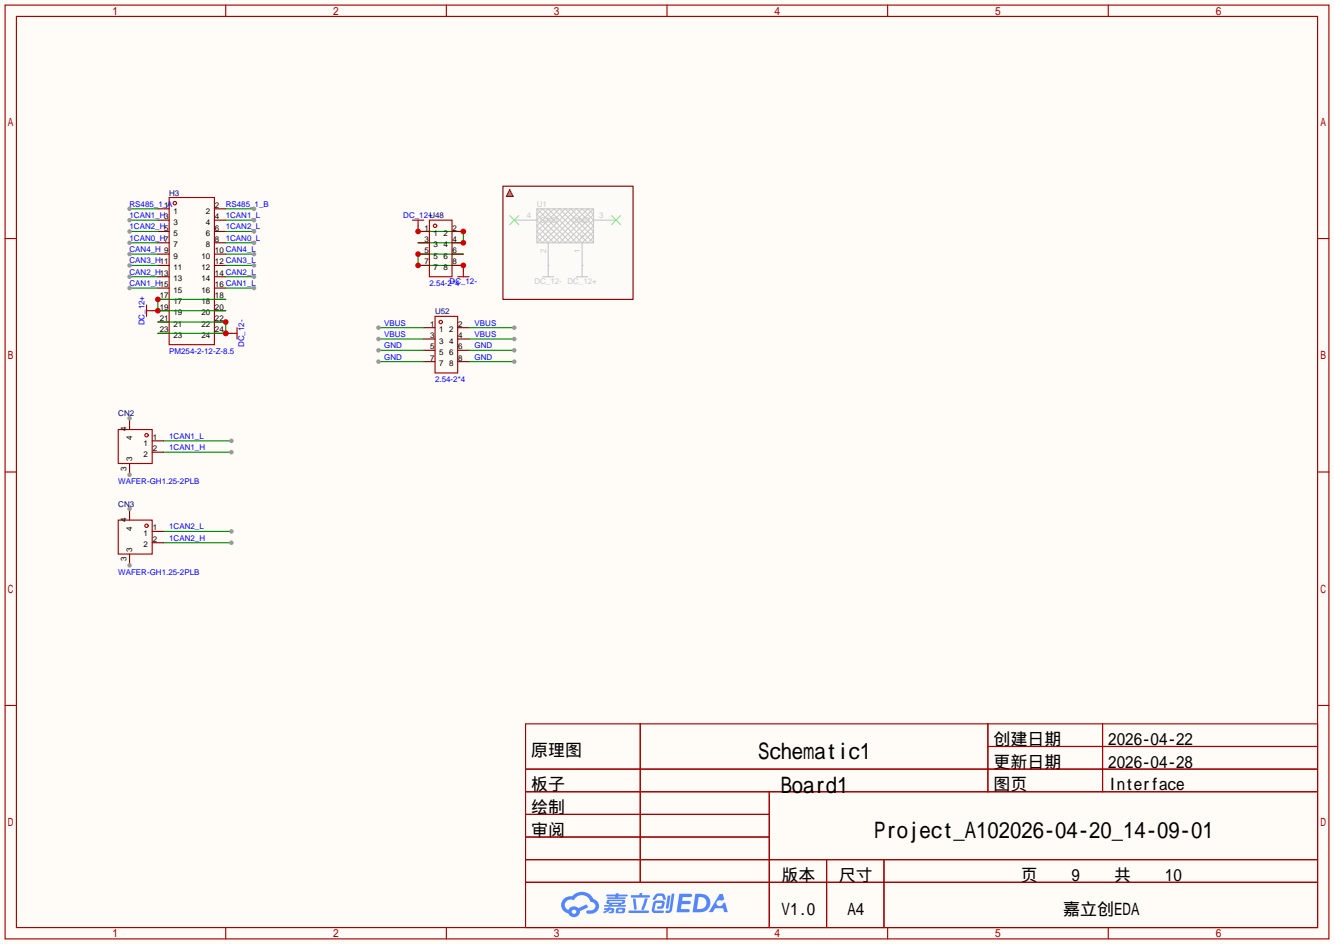
[picture p18: page 9]

原理图 | Schematic1 | 创建日期 | 2026-04-22

更新日期 | 2026-04-28

板子 | Board1 | 图页 | Interface
绘制 | | Project_A102026-04-20_14-09-01
审阅

原理图 | Schematic1 | 创建日期 | 2026-04-20
| | 更新日期 | 2026-04-23
板子 | Board1 | 图页 | 框图
绘制 | | Project_A102026-04-20_14-09-01
审阅
版本 | 尺寸 | 页 | 10 | 共 | 10

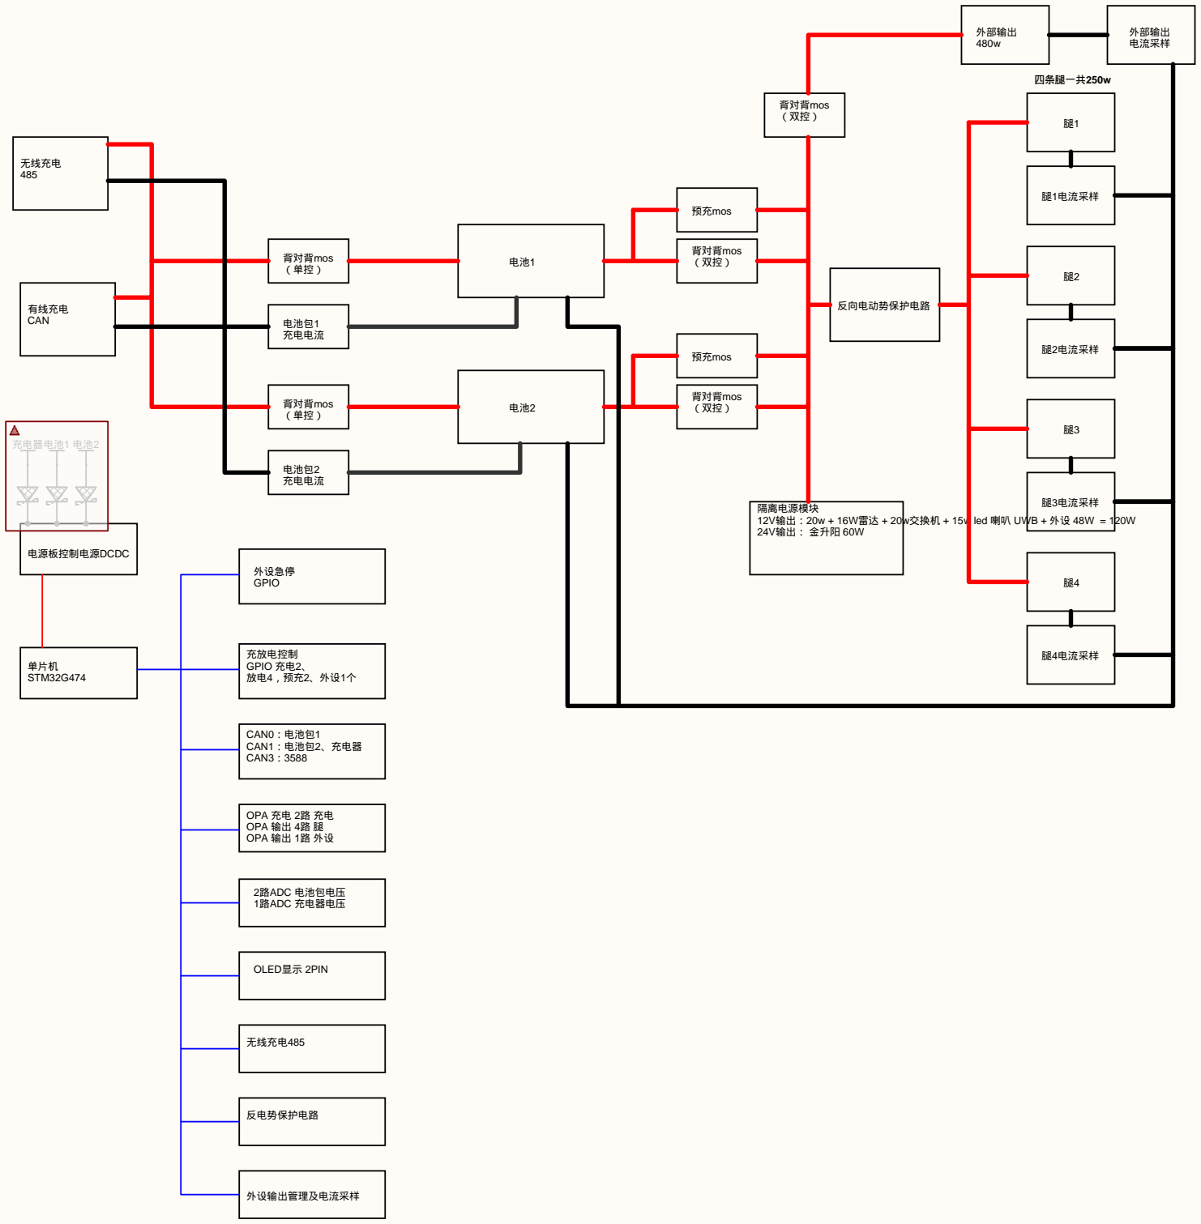
[picture p19: figure]
隔离电源模块; 24V输出： 金升阳 60W; 外设输出管理及电流采样; 无线充电485; 电源板控制电源DCDC; OPA 充电 2路 充电 OPA 输出 4路 腿 OPA 输出 1路 外设; 2路ADC 电池包电压 1路ADC 充电器电压; 反电势保护电路; OLED显示 2PIN; 单片机 STM32G474; CAN0：电池包1 CAN1：电池包2、充电器 CAN3：3588; 充放电控制 GPIO 充电2、 放电4，预充2、外设1个; 外设急停 GPIO; 腿1电流采样; 反向电动势保护电路; 外部输出 电流采样; 外部输出 480w; 腿4电流采样; 腿3电流采样; 腿2电流采样; 有线充电 CAN; 无线充电 485; 预充mos; 背对背mos （双控）; 电池包1 充电电流; 电池包2 充电电流; 背对背mos （单控）; 充电器电池1 电池2; 四条腿一共250w

12V输出：20w + 16W雷达 + 20w交换机 + 15w led 喇叭 UWB + 外设 48W = 120W
