wajmh/D-Y/Core/Src/main.c

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
/* Includes ------------------------------------------------------------------*/
#include "main.h"
#include "adc.h"
#include "dma.h"
#include "fdcan.h"
#include "tim.h"
#include "usart.h"
#include "gpio.h"


void SystemClock_Config(void);
/**
  * @brief  The application entry point.
  * @retval int
  */
int main(void)
{

  /* USER CODE BEGIN 1 */
  SCB->VTOR = 0x08006000U;
  __enable_irq();
  Power_CheckAndHandleHotBoot();
  /* USER CODE END 1 */

  /* MCU Configuration--------------------------------------------------------*/

  /* Reset of all peripherals, Initializes the Flash interface and the Systick. */
  HAL_Init();

  /* Configure the system clock */
  SystemClock_Config();

  /* Initialize all configured peripherals */
  MX_GPIO_Init();
  MX_DMA_Init();
  MX_ADC2_Init();
  MX_FDCAN1_Init();
  MX_FDCAN2_Init();
  MX_FDCAN3_Init();
  MX_USART2_UART_Init();
  MX_TIM2_Init();
  /* USER CODE BEGIN 2 */
  ADC2_StartDMA();
  HAL_TIM_PWM_Start(&htim2, TIM_CHANNEL_4);
  if (Power_IsHotBoot() == 0U)
  {
    HAL_Delay(20);
    ADC_CalibrateCurrentOffsets();
  }
  ADC_UpdateCurrents();
  ADC2_UpdateBatteryVoltages();
  FDCAN_BatteryCanStart();
  Power_UpdateGpioDebugStates();//mos管的检测
  Power_EnterDischargeMode();//初始化双电池状态 (热接力时跳过预充平滑接管)
  Power_UpdateStatusIndicators();//正常上电后点亮声光指示灯（默认绿灯常亮）

  /* USER CODE END 2 */

  /* Infinite loop */
  /* USER CODE BEGIN WHILE */
  while (1)
  {
    /* USER CODE END WHILE */

    /* USER CODE BEGIN 3 */
    ADC_UpdateCurrents();//放电电流的更新
    ADC2_UpdateBatteryVoltages();//电池电压的更新
    FDCAN_BatteryCanTask();
    Power_UpdateGpioDebugStates();
    Power_ModeTask();
    Power_UpdateStatusIndicators();//声光状态指示与小脑控制响应
    FDCAN_CheckAndRecoverAllBusOff(); // ★ 纯异步执行恢复状态机
  }
  /* USER CODE END 3 */
}

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
