wajmh/D-Y/D-Y.ioc

Mcu.UserName=STM32G474RBTx
PA1.Signal=USART2_DE
PA11.Signal=FDCAN1_RX
PA12.Signal=FDCAN1_TX
PA13.Signal=SYS_JTMS-SWDIO
PA14.Signal=SYS_JTCK-SWCLK
PA3.Signal=USART2_RX
PA4.Signal=ADC2_IN17
PA5.Signal=GPIO_Output
PA7.Signal=GPIO_Output
PA8.Signal=FDCAN3_RX
PB10.Signal=GPIO_Output
PB11.Signal=S_TIM2_CH4
PB13.Signal=FDCAN2_TX
PB15.Signal=ADC2_IN15
PB3.Signal=USART2_TX
PB4.Signal=FDCAN3_TX
PB5.Signal=FDCAN2_RX
PB6.Signal=GPIO_Output
PB7.Signal=GPIO_Output
PB9.Signal=GPIO_Output
PC10.Signal=GPIO_Output
PC11.Signal=GPIO_Output
PC12.Signal=GPIO_Output
PC13.Signal=GPIO_Output
PC14-OSC32_IN.Signal=GPIO_Output
PC15-OSC32_OUT.Signal=GPIO_Output
PC2.Signal=GPIO_Output
PC4.Signal=GPIO_Output
PF0-OSC_IN.Signal=RCC_OSC_IN
PF1-OSC_OUT.Signal=RCC_OSC_OUT
