wajmh/D-Y/Core/Src/fdcan.c

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
/* Includes ------------------------------------------------------------------*/
#include "fdcan.h"

/* USER CODE BEGIN 0 */
#include "adc.h"
#include "gpio.h"
#include "tim.h"
#include "usart.h"
#include <string.h>

#define FDCAN_BATTERY_STATUS_ID_BASE 0x04028000U
#define FDCAN_BATTERY_STATUS_ID_MASK 0x1FFFFF00U
#define FDCAN_BATTERY_CHARGE_REPLY_STATUS_ID_BASE 0x04028000U
#define FDCAN_BATTERY_CHARGE_REPLY_INFO_ID_BASE   0x04008000U
#define FDCAN_BATTERY_CHARGE_REPLY_TEMP_ID_BASE   0x04088000U
#define FDCAN_BATTERY_MOS_ID_BASE    0x04068000U
#define FDCAN_BATTERY_MOS_ID_MASK    0x1FFFFF00U
#define FDCAN_BATTERY_INFO_ID_BASE   0x04038000U
#define FDCAN_BATTERY_FAULT_ID_BASE  0x040E8000U
#define FDCAN_BATTERY_TEMP_ID_BASE   0x04078000U
#define FDCAN_BATTERY_ID_MASK        0x1FFFFF00U
#define FDCAN_LEG_CURRENT_REPORT_ID  0x04100000U
#define FDCAN_PERIPHERAL_CURRENT_REPORT_ID 0x04200000U
/* [急停功能已停用]
#define FDCAN_ESTOP_REPORT_ID        0x04300000U
#define FDCAN_ESTOP_REPORT_PERIOD_MS 50U
*/
#define FDCAN_BATTERY_ALARM_REPORT_ID 0x04400000U
#define FDCAN_CURRENT_REPORT_PERIOD_MS 200U
#define FDCAN_BATTERY_ALARM_REPORT_PERIOD_MS 100U
#define FDCAN_CURRENT_REPORT_SCALE    100.0f
#define FDCAN_BATTERY_WAKE_PERIOD_MS  2000U
#define FDCAN_BMS_MOS_DEBOUNCE_FRAMES 3U

static uint8_t batteryCanStarted = 0U;
static uint8_t bat1AllowedDebounceCount = 0U;
static uint8_t bat1ProhibitDebounceCount = 0U;
static uint8_t bat1UnknownDebounceCount = 0U;
static uint8_t bat2AllowedDebounceCount = 0U;
static uint8_t bat2ProhibitDebounceCount = 0U;
static uint8_t bat2UnknownDebounceCount = 0U;
static uint32_t batteryCanLastTxTick = 0U;
static uint32_t currentReportLastTxTick = 0U;
/* static uint32_t estopReportLastTxTick = 0U; // [急停功能已停用] */
static uint32_t batteryAlarmReportLastTxTick = 0U;

typedef struct
{
  uint8_t valid;
  uint32_t id;
  uint32_t dataLength;
  uint8_t data[8];
} FDCAN_ChargeReplyFrame_t;

static FDCAN_ChargeReplyFrame_t batteryChargeReplyFrames[2][3];
volatile uint32_t battery_can_forward_count = 0U;
volatile uint32_t battery_can_forward_drop_count = 0U;
volatile float battery1_can_sum_voltage = 0.0f;
volatile float battery1_can_current = 0.0f;
volatile float battery1_can_soc = 0.0f;
volatile uint8_t battery1_can_soc_valid = 0U;
volatile uint32_t battery1_can_rx_id = 0U;
volatile uint32_t battery1_can_rx_count = 0U;
volatile uint32_t battery1_can_status_last_rx_tick = 0U;
volatile uint8_t battery1_can_charge_mos_state = 0U;
volatile uint8_t battery1_can_discharge_mos_state = 0U;
volatile BmsDischargeMosState_t battery1_bms_discharge_state = BMS_DISCHARGE_MOS_UNKNOWN;
volatile uint32_t battery1_can_mos_rx_id = 0U;
volatile uint32_t battery1_can_mos_rx_count = 0U;
volatile uint32_t battery1_can_mos_last_rx_tick = 0U;
volatile float battery2_can_sum_voltage = 0.0f;
volatile float battery2_can_current = 0.0f;
volatile float battery2_can_soc = 0.0f;
volatile uint8_t battery2_can_soc_valid = 0U;
volatile uint32_t battery2_can_rx_id = 0U;
volatile uint32_t battery2_can_rx_count = 0U;
volatile uint32_t battery2_can_status_last_rx_tick = 0U;
volatile uint8_t battery2_can_charge_mos_state = 0U;
volatile uint8_t battery2_can_discharge_mos_state = 0U;
volatile BmsDischargeMosState_t battery2_bms_discharge_state = BMS_DISCHARGE_MOS_UNKNOWN;
volatile uint32_t battery2_can_mos_rx_id = 0U;
volatile uint32_t battery2_can_mos_rx_count = 0U;
volatile uint32_t battery2_can_mos_last_rx_tick = 0U;
volatile uint32_t charger_can_rx_count = 0U;
volatile uint32_t charger_can_rx_id = 0U;
volatile uint32_t charger_can_last_rx_tick = 0U;
volatile uint32_t charger_can_rx_interval_ms = 0U;
volatile uint8_t rk_charge_mode_request = 0U;
volatile uint8_t charge_mode_active = 0U;
volatile RkIndicatorControl_t rkIndicatorCtrl = {0};
static uint32_t rkIndicatorReportLastTxTick = 0U;

static void FDCAN_IncrementDebugCounter(volatile uint32_t *counter)
{
  if (*counter < 0xFFFFFFFFU)
  {
    (*counter)++;
  }
}

/* ============================================================================
 * Bus-Off 中断驱动恢复配置与状态机
 * ========================================================================== */
#define FDCAN_BUSOFF_RECOVERY_DELAY_MS 100U   /* 恢复延迟，等待总线稳定 */
#define FDCAN_BUSOFF_RECOVERY_TIMEOUT_MS 10U  /* 硬件操作超时（CCCR.INIT 响应） */
#define FDCAN_BUSOFF_BACKUP_POLL_MS 100U      /* IDLE 兜底轮询周期（防中断丢失，限制 PSR 访问频率） */

typedef enum
{
  FDCAN_BUSOFF_STATE_IDLE = 0U,           /* 正常工作状态，无 Bus-Off */
  FDCAN_BUSOFF_STATE_PENDING = 1U,        /* 等待总线稳定（100ms），优先检查是否自愈 */
  FDCAN_BUSOFF_STATE_REQUEST_INIT = 2U,   /* 请求进入配置模式（CCCR.INIT=1），非阻塞等待确认 */
  FDCAN_BUSOFF_STATE_START_SYNC = 3U,     /* 取消待发请求，请求退出配置模式（CCCR.INIT=0） */
  FDCAN_BUSOFF_STATE_RECOVERING = 4U      /* 持续非阻塞等待 129 × 11 bit 隐性位同步完成 */
} FDCAN_BusOffState_t;

/* 分别为 FDCAN1, FDCAN2, FDCAN3 定义恢复状态变量 */
#define DEFINE_FDCAN_BUSOFF_VARS(idx) \
  static volatile uint8_t fdcan##idx##_busoff_flag = 0U; \
  static volatile uint32_t fdcan##idx##_busoff_generation = 0U; \
  static volatile FDCAN_BusOffState_t fdcan##idx##_busoff_state = FDCAN_BUSOFF_STATE_IDLE; \
  static volatile uint32_t fdcan##idx##BusoffDetectTick = 0U; \
  static volatile uint32_t fdcan##idx##StateTick = 0U; \
  static volatile uint32_t fdcan##idx##SyncStartTick = 0U; \
  volatile uint32_t fdcan##idx##_busoff_recovery_count = 0U; \
  volatile uint32_t fdcan##idx##_busoff_recovery_fail_count = 0U; \
  volatile uint32_t fdcan##idx##_last_psr = 0U; \
  volatile uint32_t fdcan##idx##_last_ecr = 0U;

DEFINE_FDCAN_BUSOFF_VARS(1)
DEFINE_FDCAN_BUSOFF_VARS(2)
DEFINE_FDCAN_BUSOFF_VARS(3)

static uint8_t FDCAN_VerifyRecovery(const FDCAN_GlobalTypeDef *instance, const FDCAN_HandleTypeDef *hfdcan)
{
  if ((instance == NULL) || (hfdcan == NULL)) return 0U;
  if ((instance->CCCR & FDCAN_CCCR_INIT) != 0U) return 0U;
  if ((instance->PSR & FDCAN_PSR_BO) != 0U) return 0U;
  return 1U;
}

static void FDCAN_HandleInstanceBusOff(
  FDCAN_HandleTypeDef *hfdcan,
  FDCAN_GlobalTypeDef *instance,
  volatile uint8_t *busoffFlag,
  volatile uint32_t *generation,
  volatile uint32_t *detectTick,
  volatile uint32_t *stateTick,
  volatile uint32_t *syncStartTick,
  volatile FDCAN_BusOffState_t *state,
  volatile uint32_t *recoveryCount,
  volatile uint32_t *recoveryFailCount,
  volatile uint32_t *diagPsr,
  volatile uint32_t *diagEcr,
  uint32_t now)
{
  uint8_t localFlag;
  uint32_t localDetectTick, localStateTick, localGen;
  FDCAN_BusOffState_t localState;
  uint32_t primask;

  primask = __get_PRIMASK();
  __disable_irq();
  localFlag = *busoffFlag;
  localDetectTick = *detectTick;
  localStateTick = *stateTick;
  localGen = *generation;
  localState = *state;
  __set_PRIMASK(primask);

  /* 兜底检测（防御中断丢失，限制轮询频率避免持续清零 PSR.LEC） */
  if ((localFlag == 0U) && (localState == FDCAN_BUSOFF_STATE_IDLE))
  {
    if ((now - localStateTick) >= FDCAN_BUSOFF_BACKUP_POLL_MS)
    {
      *stateTick = now;
      uint32_t psr_snapshot = instance->PSR;
      if ((psr_snapshot & FDCAN_PSR_BO) != 0U)
      {
        primask = __get_PRIMASK();
        __disable_irq();
        if (*busoffFlag == 0U)
        {
          (*generation)++;
          *busoffFlag = 1U;
          *detectTick = now;
          *state = FDCAN_BUSOFF_STATE_PENDING;
          if (diagPsr != NULL) *diagPsr = psr_snapshot;
          if (diagEcr != NULL) *diagEcr = instance->ECR;
        }
        __set_PRIMASK(primask);
      }
    }
    return;
  }

  switch (localState)
  {
    case FDCAN_BUSOFF_STATE_PENDING:
      /* 优先检查自愈 */
      if (((instance->PSR & FDCAN_PSR_BO) == 0U) && ((instance->CCCR & FDCAN_CCCR_INIT) == 0U))
      {
        primask = __get_PRIMASK();
        __disable_irq();
        if (*generation == localGen)
        {
          hfdcan->State = HAL_FDCAN_STATE_BUSY;
          hfdcan->ErrorCode = HAL_FDCAN_ERROR_NONE;
          hfdcan->LatestTxFifoQRequest = 0U;
          *busoffFlag = 0U;
          *state = FDCAN_BUSOFF_STATE_IDLE;
          *stateTick = now;
          FDCAN_IncrementDebugCounter(recoveryCount);
        }
        __set_PRIMASK(primask);
        break;
      }

      /* 100ms 稳定期等待 */
      if ((now - localDetectTick) >= FDCAN_BUSOFF_RECOVERY_DELAY_MS)
      {
        SET_BIT(instance->CCCR, FDCAN_CCCR_INIT);
        primask = __get_PRIMASK();
        __disable_irq();
        if (*generation == localGen)
        {
          *stateTick = now;
          *state = FDCAN_BUSOFF_STATE_REQUEST_INIT;
        }
        __set_PRIMASK(primask);
      }
      break;

    case FDCAN_BUSOFF_STATE_REQUEST_INIT:
      if ((instance->CCCR & FDCAN_CCCR_INIT) != 0U)
      {
        /* 清除残留 TX 队列，准备退出 INIT */
        SET_BIT(instance->CCCR, FDCAN_CCCR_CCE);
        instance->TXBCR = FDCAN_TXBCR_CR_Msk;  /* 0x7 */
        hfdcan->LatestTxFifoQRequest = 0U;

        CLEAR_BIT(instance->CCCR, FDCAN_CCCR_CCE);
        CLEAR_BIT(instance->CCCR, FDCAN_CCCR_INIT);

        primask = __get_PRIMASK();
        __disable_irq();
        if (*generation == localGen)
        {
          *stateTick = now;
          *state = FDCAN_BUSOFF_STATE_START_SYNC;
        }
        __set_PRIMASK(primask);
      }
      else if ((now - localStateTick) >= FDCAN_BUSOFF_RECOVERY_TIMEOUT_MS)
      {
        primask = __get_PRIMASK();
        __disable_irq();
        if (*generation == localGen)
        {
          *detectTick = now;
          *state = FDCAN_BUSOFF_STATE_PENDING;
          FDCAN_IncrementDebugCounter(recoveryFailCount);
        }
        __set_PRIMASK(primask);
      }
      break;

    case FDCAN_BUSOFF_STATE_START_SYNC:
      if ((instance->CCCR & FDCAN_CCCR_INIT) == 0U)
      {
        primask = __get_PRIMASK();
        __disable_irq();
        if (*generation == localGen)
        {
          *syncStartTick = now;
          *state = FDCAN_BUSOFF_STATE_RECOVERING;
        }
        __set_PRIMASK(primask);
      }
      else if ((now - localStateTick) >= FDCAN_BUSOFF_RECOVERY_TIMEOUT_MS)
      {
        primask = __get_PRIMASK();
        __disable_irq();
        if (*generation == localGen)
        {
          *detectTick = now;
          *state = FDCAN_BUSOFF_STATE_PENDING;
          FDCAN_IncrementDebugCounter(recoveryFailCount);
        }
        __set_PRIMASK(primask);
      }
      break;

    case FDCAN_BUSOFF_STATE_RECOVERING:
      /* 核心：不设超时，持续轮询等待硬件完成 129×11 bit 同步 */
      if ((instance->PSR & FDCAN_PSR_BO) == 0U)
      {
        if (FDCAN_VerifyRecovery(instance, hfdcan) != 0U)
        {
          primask = __get_PRIMASK();
          __disable_irq();
          if (*generation == localGen)
          {
            hfdcan->State = HAL_FDCAN_STATE_BUSY;
            hfdcan->ErrorCode = HAL_FDCAN_ERROR_NONE;
            hfdcan->LatestTxFifoQRequest = 0U;
            *busoffFlag = 0U;
            *state = FDCAN_BUSOFF_STATE_IDLE;
            *stateTick = now;
            FDCAN_IncrementDebugCounter(recoveryCount);
          }
          __set_PRIMASK(primask);
        }
      }
      break;

    default:
      *state = FDCAN_BUSOFF_STATE_IDLE;
      *stateTick = now;
      break;
  }
}

void FDCAN_CheckAndRecoverAllBusOff(void)
{
  uint32_t now = HAL_GetTick();
  if (batteryCanStarted != 0U)
  {
    FDCAN_HandleInstanceBusOff(&hfdcan1, FDCAN1, &fdcan1_busoff_flag, &fdcan1_busoff_generation,
                              &fdcan1BusoffDetectTick, &fdcan1StateTick, &fdcan1SyncStartTick,
                              &fdcan1_busoff_state, &fdcan1_busoff_recovery_count,
                              &fdcan1_busoff_recovery_fail_count,
                              &fdcan1_last_psr, &fdcan1_last_ecr, now);
    FDCAN_HandleInstanceBusOff(&hfdcan2, FDCAN2, &fdcan2_busoff_flag, &fdcan2_busoff_generation,
                              &fdcan2BusoffDetectTick, &fdcan2StateTick, &fdcan2SyncStartTick,
                              &fdcan2_busoff_state, &fdcan2_busoff_recovery_count,
                              &fdcan2_busoff_recovery_fail_count,
                              &fdcan2_last_psr, &fdcan2_last_ecr, now);
    FDCAN_HandleInstanceBusOff(&hfdcan3, FDCAN3, &fdcan3_busoff_flag, &fdcan3_busoff_generation,
                              &fdcan3BusoffDetectTick, &fdcan3StateTick, &fdcan3SyncStartTick,
                              &fdcan3_busoff_state, &fdcan3_busoff_recovery_count,
                              &fdcan3_busoff_recovery_fail_count,
                              &fdcan3_last_psr, &fdcan3_last_ecr, now);
  }
}

static int16_t FDCAN_CurrentToCanRaw(float current)
{
  float scaled = current * FDCAN_CURRENT_REPORT_SCALE;

  if (scaled > 32767.0f)
  {
    return 32767;
  }

  if (scaled < -32768.0f)
  {
    return -32768;
  }

  return (int16_t)((scaled >= 0.0f) ? (scaled + 0.5f) : (scaled - 0.5f));
}

static void FDCAN_PackInt16LittleEndian(uint8_t data[], uint8_t offset, int16_t value)
{
  uint16_t raw = (uint16_t)value;

  data[offset] = (uint8_t)(raw & 0xFFU);
  data[offset + 1U] = (uint8_t)((raw >> 8) & 0xFFU);
}

static HAL_StatusTypeDef FDCAN_SendCurrentReport(uint32_t identifier, const uint8_t txData[])
{
  FDCAN_TxHeaderTypeDef txHeader;
  HAL_StatusTypeDef status;
  uint32_t primask;

  /* 快速预检（无锁） */
  if (fdcan2_busoff_flag != 0U)
  {
    return HAL_BUSY;
  }

  if (HAL_FDCAN_GetTxFifoFreeLevel(&hfdcan2) == 0U)
  {
    return HAL_BUSY;
  }

  /* 配置 txHeader（不需要在临界区内） */
  txHeader.Identifier = identifier;
  txHeader.IdType = FDCAN_EXTENDED_ID;
  txHeader.TxFrameType = FDCAN_DATA_FRAME;
  txHeader.DataLength = FDCAN_DLC_BYTES_8;
  txHeader.ErrorStateIndicator = FDCAN_ESI_ACTIVE;
  txHeader.BitRateSwitch = FDCAN_BRS_OFF;
  txHeader.FDFormat = FDCAN_CLASSIC_CAN;
  txHeader.TxEventFifoControl = FDCAN_NO_TX_EVENTS;
  txHeader.MessageMarker = 0U;

  /* 临界区保护：原子检查标志与入队 */
  primask = __get_PRIMASK();
  __disable_irq();
  if (fdcan2_busoff_flag != 0U)
  {
    __set_PRIMASK(primask);
    return HAL_BUSY;
  }
  status = HAL_FDCAN_AddMessageToTxFifoQ(&hfdcan2, &txHeader, (uint8_t *)txData);
  __set_PRIMASK(primask);

  return status;
}

static void FDCAN_SendCurrentReportsToRk(void)
{
  uint8_t legCurrentData[8] = {0U, 0U, 0U, 0U, 0U, 0U, 0U, 0U};
  uint8_t peripheralCurrentData[8] = {0U, 0U, 0U, 0U, 0U, 0U, 0U, 0U};

  FDCAN_PackInt16LittleEndian(legCurrentData, 0U, FDCAN_CurrentToCanRaw(ADC_GetLeg1Current()));
  FDCAN_PackInt16LittleEndian(legCurrentData, 2U, FDCAN_CurrentToCanRaw(ADC_GetLeg2Current()));
  FDCAN_PackInt16LittleEndian(legCurrentData, 4U, FDCAN_CurrentToCanRaw(ADC_GetLeg3Current()));
  FDCAN_PackInt16LittleEndian(legCurrentData, 6U, FDCAN_CurrentToCanRaw(ADC_GetLeg4Current()));

  FDCAN_PackInt16LittleEndian(peripheralCurrentData,
                              0U,
                              FDCAN_CurrentToCanRaw(ADC_GetPeripheralDischargeCurrent()));

  (void)FDCAN_SendCurrentReport(FDCAN_LEG_CURRENT_REPORT_ID, legCurrentData);
  (void)FDCAN_SendCurrentReport(FDCAN_PERIPHERAL_CURRENT_REPORT_ID, peripheralCurrentData);
}

/* [急停功能已停用，硬件未连接]
static void FDCAN_SendEmergencyStopReportToRk(void)
{
  uint8_t estopData[8] = {1U, 0U, 0U, 0U, 0U, 0U, 0U, 0U};

  (void)FDCAN_SendCurrentReport(FDCAN_ESTOP_REPORT_ID, estopData);
}
*/

HAL_StatusTypeDef FDCAN_SendBatteryAlarmReportToRk(void)
{
  uint8_t alarmData[8] = {0U, 0U, 0U, 0U, 0U, 0U, 0U, 0U};

  alarmData[0] = Power_GetBattery1AlarmStatus();
  alarmData[1] = Power_GetBattery2AlarmStatus();
  alarmData[2] = bat1_discharge_mos_state;
  alarmData[3] = bat1_recharge_mos_state;
  alarmData[4] = bat2_discharge_mos_state;
  alarmData[5] = bat2_recharge_mos_state;
  alarmData[6] = bat1_charge_mos_state;
  alarmData[7] = bat2_charge_mos_state;

  return FDCAN_SendCurrentReport(FDCAN_BATTERY_ALARM_REPORT_ID, alarmData);
}

static void FDCAN_SendChargeModeStatusToRk(uint8_t status)
{
  FDCAN_TxHeaderTypeDef txHeader;
  uint8_t statusData[1];
  uint32_t primask;

  statusData[0] = status;

  /* 快速预检（无锁） */
  if (fdcan2_busoff_flag != 0U)
  {
    return;
  }

  if (HAL_FDCAN_GetTxFifoFreeLevel(&hfdcan2) == 0U)
  {
    return;
  }

  /* 配置 txHeader（不需要在临界区内） */
  txHeader.Identifier = FDCAN_RK_CHARGE_MODE_STATUS_ID;
  txHeader.IdType = FDCAN_EXTENDED_ID;
  txHeader.TxFrameType = FDCAN_DATA_FRAME;
  txHeader.DataLength = FDCAN_DLC_BYTES_1;
  txHeader.ErrorStateIndicator = FDCAN_ESI_ACTIVE;
  txHeader.BitRateSwitch = FDCAN_BRS_OFF;
  txHeader.FDFormat = FDCAN_CLASSIC_CAN;
  txHeader.TxEventFifoControl = FDCAN_NO_TX_EVENTS;
  txHeader.MessageMarker = 0U;

  /* 临界区保护：原子检查标志与入队 */
  primask = __get_PRIMASK();
  __disable_irq();
  if (fdcan2_busoff_flag != 0U)
  {
    __set_PRIMASK(primask);
    return;
  }
  (void)HAL_FDCAN_AddMessageToTxFifoQ(&hfdcan2, &txHeader, statusData);
  __set_PRIMASK(primask);
}

static void FDCAN_ConfigBatteryRxFilters(FDCAN_HandleTypeDef *hfdcan)
{
  static const uint32_t filterIdBases[] =
  {
    FDCAN_BATTERY_STATUS_ID_BASE,
    FDCAN_BATTERY_MOS_ID_BASE,
    FDCAN_BATTERY_INFO_ID_BASE,
    FDCAN_BATTERY_FAULT_ID_BASE,
    FDCAN_BATTERY_TEMP_ID_BASE,
    FDCAN_BATTERY_CHARGE_REPLY_INFO_ID_BASE,
    FDCAN_BATTERY_CHARGE_REPLY_TEMP_ID_BASE
  };
  FDCAN_FilterTypeDef filterConfig;
  uint32_t filterIndex;

  filterConfig.IdType = FDCAN_EXTENDED_ID;
  filterConfig.FilterType = FDCAN_FILTER_MASK;
  filterConfig.FilterConfig = FDCAN_FILTER_TO_RXFIFO0;

  for (filterIndex = 0U; filterIndex < (sizeof(filterIdBases) / sizeof(filterIdBases[0])); filterIndex++)
  {
    filterConfig.FilterIndex = filterIndex;
    filterConfig.FilterID1 = filterIdBases[filterIndex];
    filterConfig.FilterID2 = FDCAN_BATTERY_ID_MASK;

    if (HAL_FDCAN_ConfigFilter(hfdcan, &filterConfig) != HAL_OK)
    {
      Error_Handler();
    }
  }

  if (hfdcan->Instance == FDCAN3)
  {
    filterConfig.FilterIndex = filterIndex;
    filterConfig.FilterID1 = FDCAN_CHARGE_MODE_CMD_ID;
    filterConfig.FilterID2 = 0x1FFFFFFFU;

    if (HAL_FDCAN_ConfigFilter(hfdcan, &filterConfig) != HAL_OK)
    {
      Error_Handler();
    }
  }
}

static void FDCAN_ConfigRkRxFilters(void)
{
  FDCAN_FilterTypeDef filterConfig;

  filterConfig.IdType = FDCAN_EXTENDED_ID;
  filterConfig.FilterIndex = 0U;
  filterConfig.FilterType = FDCAN_FILTER_MASK;
  filterConfig.FilterConfig = FDCAN_FILTER_TO_RXFIFO0;
  filterConfig.FilterID1 = FDCAN_RK_CHARGE_MODE_CMD_ID;
  filterConfig.FilterID2 = 0x1FFFFFFFU;

  if (HAL_FDCAN_ConfigFilter(&hfdcan2, &filterConfig) != HAL_OK)
  {
    Error_Handler();
  }

  filterConfig.FilterIndex = 1U;
  filterConfig.FilterID1 = FDCAN_RK_INDICATOR_CMD_ID;
  filterConfig.FilterID2 = 0x1FFFFFFFU;

  if (HAL_FDCAN_ConfigFilter(&hfdcan2, &filterConfig) != HAL_OK)
  {
    Error_Handler();
  }

  filterConfig.FilterIndex = 2U;
  filterConfig.FilterID1 = FDCAN_IAP_CMD_ID;
  filterConfig.FilterID2 = 0x1FFFFFFFU;

  if (HAL_FDCAN_ConfigFilter(&hfdcan2, &filterConfig) != HAL_OK)
  {
    Error_Handler();
  }
}

static uint8_t FDCAN_GetChargeReplyFrameSlot(uint32_t rxId, uint8_t *slot)
{
  uint32_t idBase = rxId & FDCAN_BATTERY_ID_MASK;

  if (idBase == FDCAN_BATTERY_CHARGE_REPLY_STATUS_ID_BASE)
  {
    *slot = 0U;
    return 1U;
  }

  if (idBase == FDCAN_BATTERY_CHARGE_REPLY_INFO_ID_BASE)
  {
    *slot = 1U;
    return 1U;
  }

  if (idBase == FDCAN_BATTERY_CHARGE_REPLY_TEMP_ID_BASE)
  {
    *slot = 2U;
    return 1U;
  }

  return 0U;
}

static void FDCAN_CacheChargeReplyFrame(uint8_t batteryIndex,
                                        const FDCAN_RxHeaderTypeDef *rxHeader,
                                        const uint8_t rxData[])
{
  FDCAN_ChargeReplyFrame_t *frame;
  uint8_t slot;

  if ((batteryIndex < 1U) ||
      (batteryIndex > 2U) ||
      (rxHeader->IdType != FDCAN_EXTENDED_ID) ||
      (rxHeader->RxFrameType != FDCAN_DATA_FRAME) ||
      (FDCAN_GetChargeReplyFrameSlot(rxHeader->Identifier, &slot) == 0U))
  {
    return;
  }

  frame = &batteryChargeReplyFrames[batteryIndex - 1U][slot];
  frame->valid = 1U;
  frame->id = rxHeader->Identifier;
  frame->dataLength = rxHeader->DataLength;
  (void)memcpy(frame->data, rxData, sizeof(frame->data));
}

static uint8_t FDCAN_IsBatteryForwardFrame(uint32_t rxId)
{
  uint32_t idBase = rxId & FDCAN_BATTERY_ID_MASK;

  return ((idBase == FDCAN_BATTERY_STATUS_ID_BASE) ||
          (idBase == FDCAN_BATTERY_INFO_ID_BASE) ||
          (idBase == FDCAN_BATTERY_FAULT_ID_BASE) ||
          (idBase == FDCAN_BATTERY_TEMP_ID_BASE)) ? 1U : 0U;
}

static void FDCAN_ForwardBatteryFrameToRk(uint8_t batteryIndex,
                                          const FDCAN_RxHeaderTypeDef *rxHeader,
                                          const uint8_t rxData[])
{
  FDCAN_TxHeaderTypeDef txHeader;
  uint32_t primask;

  if ((rxHeader->IdType != FDCAN_EXTENDED_ID) ||
      (FDCAN_IsBatteryForwardFrame(rxHeader->Identifier) == 0U))
  {
    return;
  }

  /* 快速预检（无锁） */
  if (fdcan2_busoff_flag != 0U)
  {
    FDCAN_IncrementDebugCounter(&battery_can_forward_drop_count);
    return;
  }

  if (HAL_FDCAN_GetTxFifoFreeLevel(&hfdcan2) == 0U)
  {
    FDCAN_IncrementDebugCounter(&battery_can_forward_drop_count);
    return;
  }

  /* 配置 txHeader（不需要在临界区内） */
  txHeader.Identifier = (rxHeader->Identifier & FDCAN_BATTERY_ID_MASK) | ((uint32_t)batteryIndex & 0xFFU);
  txHeader.IdType = FDCAN_EXTENDED_ID;
  txHeader.TxFrameType = rxHeader->RxFrameType;
  txHeader.DataLength = rxHeader->DataLength;
  txHeader.ErrorStateIndicator = FDCAN_ESI_ACTIVE;
  txHeader.BitRateSwitch = FDCAN_BRS_OFF;
  txHeader.FDFormat = FDCAN_CLASSIC_CAN;
  txHeader.TxEventFifoControl = FDCAN_NO_TX_EVENTS;
  txHeader.MessageMarker = batteryIndex;

  /* 临界区保护：原子检查标志与入队 */
  primask = __get_PRIMASK();
  __disable_irq();
  if (fdcan2_busoff_flag != 0U)
  {
    __set_PRIMASK(primask);
    FDCAN_IncrementDebugCounter(&battery_can_forward_drop_count);
    return;
  }

  if (HAL_FDCAN_AddMessageToTxFifoQ(&hfdcan2, &txHeader, rxData) == HAL_OK)
  {
    FDCAN_IncrementDebugCounter(&battery_can_forward_count);
  }
  else
  {
    FDCAN_IncrementDebugCounter(&battery_can_forward_drop_count);
  }
  __set_PRIMASK(primask);
}

static void FDCAN_ParseBatteryStatus(uint8_t batteryIndex, uint32_t rxId, const uint8_t rxData[], uint32_t dataLength)
{
  uint16_t rawVoltage = ((uint16_t)rxData[0] << 8) | rxData[1];
  uint16_t rawCurrent = ((uint16_t)rxData[2] << 8) | rxData[3];
  float sumVoltage = (float)rawVoltage * 0.1f;
  float current = ((float)rawCurrent - 30000.0f) * 0.1f;
  float soc = 0.0f;
  uint8_t hasSoc = 0U;

  if (dataLength >= FDCAN_DLC_BYTES_6)
  {
    uint16_t rawSoc = ((uint16_t)rxData[4] << 8) | rxData[5];
    soc = (float)rawSoc * 0.1f;
    if (soc > 100.0f)
    {
      soc = 100.0f;
    }
    hasSoc = 1U;
  }

  if (batteryIndex == 1U)
  {
    battery1_can_sum_voltage = sumVoltage;
    battery1_can_current = current;
    if (hasSoc != 0U)
    {
      battery1_can_soc = soc;
      battery1_can_soc_valid = 1U;
    }
    battery1_can_rx_id = rxId;
    FDCAN_IncrementDebugCounter(&battery1_can_rx_count);
    battery1_can_status_last_rx_tick = HAL_GetTick();
  }
  else
  {
    battery2_can_sum_voltage = sumVoltage;
    battery2_can_current = current;
    if (hasSoc != 0U)
    {
      battery2_can_soc = soc;
      battery2_can_soc_valid = 1U;
    }
    battery2_can_rx_id = rxId;
    FDCAN_IncrementDebugCounter(&battery2_can_rx_count);
    battery2_can_status_last_rx_tick = HAL_GetTick();
  }
}

static BmsDischargeMosState_t FDCAN_DebounceBmsDischargeState(
    BmsDischargeMosState_t currentState,
    uint8_t rawDischargeByte,
    uint8_t *pAllowedCount,
    uint8_t *pProhibitCount,
    uint8_t *pUnknownCount)
{
  if (rawDischargeByte == 0x01U)
  {
    *pProhibitCount = 0U;
    *pUnknownCount = 0U;
    if (currentState == BMS_DISCHARGE_MOS_ALLOWED)
    {
      *pAllowedCount = FDCAN_BMS_MOS_DEBOUNCE_FRAMES;
      return BMS_DISCHARGE_MOS_ALLOWED;
    }
    if (*pAllowedCount < 0xFFU)
    {
      (*pAllowedCount)++;
    }
    if (*pAllowedCount >= FDCAN_BMS_MOS_DEBOUNCE_FRAMES)
    {
      return BMS_DISCHARGE_MOS_ALLOWED;
    }
  }
  else if (rawDischargeByte == 0x00U)
  {
    *pAllowedCount = 0U;
    *pUnknownCount = 0U;
    if (currentState == BMS_DISCHARGE_MOS_PROHIBITED)
    {
      *pProhibitCount = FDCAN_BMS_MOS_DEBOUNCE_FRAMES;
      return BMS_DISCHARGE_MOS_PROHIBITED;
    }
    if (*pProhibitCount < 0xFFU)
    {
      (*pProhibitCount)++;
    }
    if (*pProhibitCount >= FDCAN_BMS_MOS_DEBOUNCE_FRAMES)
    {
      return BMS_DISCHARGE_MOS_PROHIBITED;
    }
  }
  else
  {
    *pAllowedCount = 0U;
    *pProhibitCount = 0U;
    if (currentState == BMS_DISCHARGE_MOS_UNKNOWN)
    {
      *pUnknownCount = FDCAN_BMS_MOS_DEBOUNCE_FRAMES;
      return BMS_DISCHARGE_MOS_UNKNOWN;
    }
    if (*pUnknownCount < 0xFFU)
    {
      (*pUnknownCount)++;
    }
    if (*pUnknownCount >= FDCAN_BMS_MOS_DEBOUNCE_FRAMES)
    {
      return BMS_DISCHARGE_MOS_UNKNOWN;
    }
  }

  /* 未达到连续消抖阈值，保持前一稳定状态，过滤单帧/双帧电磁干扰瞬态跳变 */
  return currentState;
}

static void FDCAN_ParseBatteryMosStatus(uint8_t batteryIndex, uint32_t rxId, const uint8_t rxData[])
{
  uint32_t now = HAL_GetTick();
  uint8_t chargeMosState = (rxData[0] != 0U) ? 1U : 0U;
  uint8_t dischargeMosByte = rxData[1];
  BmsDischargeMosState_t bmsDischargeState;

  if (batteryIndex == 1U)
  {
    if ((battery1_can_mos_last_rx_tick != 0U) &&
        ((now - battery1_can_mos_last_rx_tick) > 2000U))
    {
      bat1AllowedDebounceCount = 0U;
      bat1ProhibitDebounceCount = 0U;
      bat1UnknownDebounceCount = 0U;
      battery1_bms_discharge_state = BMS_DISCHARGE_MOS_UNKNOWN;
    }

    bmsDischargeState = FDCAN_DebounceBmsDischargeState(
        battery1_bms_discharge_state,
        dischargeMosByte,
        &bat1AllowedDebounceCount,
        &bat1ProhibitDebounceCount,
        &bat1UnknownDebounceCount);

    battery1_can_charge_mos_state = chargeMosState;
    battery1_bms_discharge_state = bmsDischargeState;
    battery1_can_discharge_mos_state = (bmsDischargeState == BMS_DISCHARGE_MOS_ALLOWED) ? 1U : 0U;
    battery1_can_mos_rx_id = rxId;
    FDCAN_IncrementDebugCounter(&battery1_can_mos_rx_count);
    battery1_can_mos_last_rx_tick = now;
  }
  else
  {
    if ((battery2_can_mos_last_rx_tick != 0U) &&
        ((now - battery2_can_mos_last_rx_tick) > 2000U))
    {
      bat2AllowedDebounceCount = 0U;
      bat2ProhibitDebounceCount = 0U;
      bat2UnknownDebounceCount = 0U;
      battery2_bms_discharge_state = BMS_DISCHARGE_MOS_UNKNOWN;
    }

    bmsDischargeState = FDCAN_DebounceBmsDischargeState(
        battery2_bms_discharge_state,
        dischargeMosByte,
        &bat2AllowedDebounceCount,
        &bat2ProhibitDebounceCount,
        &bat2UnknownDebounceCount);

    battery2_can_charge_mos_state = chargeMosState;
    battery2_bms_discharge_state = bmsDischargeState;
    battery2_can_discharge_mos_state = (bmsDischargeState == BMS_DISCHARGE_MOS_ALLOWED) ? 1U : 0U;
    battery2_can_mos_rx_id = rxId;
    FDCAN_IncrementDebugCounter(&battery2_can_mos_rx_count);
    battery2_can_mos_last_rx_tick = now;
  }
}

static void FDCAN_PollBatteryRx(FDCAN_HandleTypeDef *hfdcan, uint8_t batteryIndex)
{
  FDCAN_RxHeaderTypeDef rxHeader;
  uint8_t rxData[8];

  while (HAL_FDCAN_GetRxFifoFillLevel(hfdcan, FDCAN_RX_FIFO0) > 0U)
  {
    if (HAL_FDCAN_GetRxMessage(hfdcan, FDCAN_RX_FIFO0, &rxHeader, rxData) != HAL_OK)
    {
      return;
    }

    if ((hfdcan->Instance == FDCAN3) &&
        (rxHeader.IdType == FDCAN_EXTENDED_ID) &&
        (rxHeader.Identifier == FDCAN_CHARGE_MODE_CMD_ID))
    {
      uint32_t now = HAL_GetTick();
      if (charger_can_last_rx_tick != 0U)
      {
        charger_can_rx_interval_ms = now - charger_can_last_rx_tick;
      }
      charger_can_rx_id = rxHeader.Identifier;
      FDCAN_IncrementDebugCounter(&charger_can_rx_count);
      charger_can_last_rx_tick = now;

      if ((rk_charge_mode_request != 0U) && (charge_mode_active == 0U))
      {
        if (Power_EnterChargeMode() == HAL_OK)
        {
          charge_mode_active = 1U;
          FDCAN_SendChargeModeStatusToRk(FDCAN_CHARGE_MODE_ENTER);
        }
      }
      continue;
    }

    FDCAN_CacheChargeReplyFrame(batteryIndex, &rxHeader, rxData);
    FDCAN_ForwardBatteryFrameToRk(batteryIndex, &rxHeader, rxData);

    if ((rxHeader.IdType == FDCAN_EXTENDED_ID) &&
        ((rxHeader.Identifier & FDCAN_BATTERY_STATUS_ID_MASK) == FDCAN_BATTERY_STATUS_ID_BASE) &&
        (rxHeader.DataLength >= FDCAN_DLC_BYTES_4))
    {
      FDCAN_ParseBatteryStatus(batteryIndex, rxHeader.Identifier, rxData, rxHeader.DataLength);
    }
    else if ((rxHeader.IdType == FDCAN_EXTENDED_ID) &&
             ((rxHeader.Identifier & FDCAN_BATTERY_MOS_ID_MASK) == FDCAN_BATTERY_MOS_ID_BASE) &&
             (rxHeader.DataLength >= FDCAN_DLC_BYTES_2))
    {
      FDCAN_ParseBatteryMosStatus(batteryIndex, rxHeader.Identifier, rxData);
    }
  }
}

static void FDCAN_HandleRkChargeModeCommand(const FDCAN_RxHeaderTypeDef *rxHeader, const uint8_t rxData[])
{
  if ((rxHeader->IdType != FDCAN_EXTENDED_ID) ||
      (rxHeader->RxFrameType != FDCAN_DATA_FRAME) ||
      (rxHeader->Identifier != FDCAN_RK_CHARGE_MODE_CMD_ID) ||
      (rxHeader->DataLength < FDCAN_DLC_BYTES_1))
  {
    return;
  }

  if (rxData[0] == FDCAN_CHARGE_MODE_ENTER)
  {
    rk_charge_mode_request = 1U;
    return;
  }

  if (rxData[0] == FDCAN_CHARGE_MODE_EXIT)
  {
    rk_charge_mode_request = 0U;
    charge_mode_active = 0U;
    Power_ExitChargeMode();
    FDCAN_SendChargeModeStatusToRk(FDCAN_CHARGE_MODE_EXIT);
  }
}

static void FDCAN_HandleRkIndicatorCommand(const FDCAN_RxHeaderTypeDef *rxHeader, const uint8_t rxData[])
{
  uint32_t now;
  uint8_t ctrlMask;

  if ((rxHeader->IdType != FDCAN_EXTENDED_ID) ||
      (rxHeader->RxFrameType != FDCAN_DATA_FRAME) ||
      (rxHeader->Identifier != FDCAN_RK_INDICATOR_CMD_ID) ||
      (rxHeader->DataLength < FDCAN_DLC_BYTES_1))
  {
    return;
  }

  now = HAL_GetTick();
  ctrlMask = rxData[0];

  rkIndicatorCtrl.rgbTakeover = ((ctrlMask & FDCAN_INDICATOR_CTRL_RGB_MASK) != 0U) ? 1U : 0U;
#if DEBUG_DISABLE_RK_BUZZER_CTRL
  rkIndicatorCtrl.buzzerTakeover = 0U; /* 调试屏蔽：禁止小脑接管蜂鸣器 */
#else
  rkIndicatorCtrl.buzzerTakeover = ((ctrlMask & FDCAN_INDICATOR_CTRL_BUZZER_MASK) != 0U) ? 1U : 0U;
#endif

  if (rxHeader->DataLength >= FDCAN_DLC_BYTES_4)
  {
    rkIndicatorCtrl.r = (rxData[1] != 0U) ? 1U : 0U;
    rkIndicatorCtrl.g = (rxData[2] != 0U) ? 1U : 0U;
    rkIndicatorCtrl.b = (rxData[3] != 0U) ? 1U : 0U;
  }

  if (rxHeader->DataLength >= FDCAN_DLC_BYTES_5)
  {
    rkIndicatorCtrl.rgbMode = (rxData[4] != 0U) ? FDCAN_INDICATOR_RGB_MODE_BLINK : FDCAN_INDICATOR_RGB_MODE_SOLID;
  }

  if (rxHeader->DataLength >= FDCAN_DLC_BYTES_6)
  {
    rkIndicatorCtrl.buzzerMode = rxData[5];
    if (rkIndicatorCtrl.buzzerMode == FDCAN_INDICATOR_BUZZER_MODE_BEEP_ONCE)
    {
      rkIndicatorCtrl.beepStartTick = now;
      rkIndicatorCtrl.beepActive = 1U;
    }
  }

  if (rxHeader->DataLength >= FDCAN_DLC_BYTES_7)
  {
    uint8_t halfPeriodUnits = rxData[6];
    rkIndicatorCtrl.halfPeriodMs = (halfPeriodUnits > 0U) ? ((uint32_t)halfPeriodUnits * 50U) : 500U;
  }
  else
  {
    rkIndicatorCtrl.halfPeriodMs = 500U;
  }

  if (rxHeader->DataLength >= FDCAN_DLC_BYTES_8)
  {
    uint8_t timeoutUnits = rxData[7];
    rkIndicatorCtrl.timeoutMs = (timeoutUnits > 0U) ? ((uint32_t)timeoutUnits * 100U) : 0U;
  }
  else
  {
    rkIndicatorCtrl.timeoutMs = FDCAN_INDICATOR_DEFAULT_TIMEOUT_MS;
  }

  rkIndicatorCtrl.lastRxTick = now;
}

void FDCAN_IAP_JumpToBootloader(void)
{
  /* 0. 优先检查 Bootloader 起始地址是否有效 (Bootloader Flash 区域: 0x08000000 ~ 0x08005000, 20KB) */
  uint32_t bootMsp = *(volatile uint32_t *)0x08000000U;
  uint32_t resetHandlerAddr = *(volatile uint32_t *)(0x08000000U + 4U);

  /* 检查栈顶地址是否合法 (SRAM 范围: 0x20000400 ~ 0x20020000，且 8 字节对齐) */
  if ((bootMsp < 0x20000400U) || (bootMsp > 0x20020000U) || ((bootMsp & 0x07U) != 0U))
  {
    return;
  }

  /* 检查复位向量入口地址是否在 Bootloader 代码区范围内 (0x08000000 ~ 0x08005000) */
  if ((resetHandlerAddr < 0x08000000U) || (resetHandlerAddr >= 0x08005000U))
  {
    return;
  }

  /* 1. 获取当前正在放电的主电池掩码 (Bit0: Bat1, Bit1: Bat2) */
  uint8_t batMask = Power_GetActiveDischargeMask();

  /* 2. 停用 ADC 采集，防止带载干扰及 DMA 悬挂中断 */
  ADC2_StopDMA();

  /* 3. 关闭反电势泄放 PWM 定时器 */
  (void)HAL_TIM_PWM_Stop(&htim2, TIM_CHANNEL_4);
  __HAL_TIM_SET_COMPARE(&htim2, TIM_CHANNEL_4, 0U);

  /* 4. 安全关断充电、回充、预放电等高危及测试回路 */
  HAL_GPIO_WritePin(BAT_CHARGE_MOS_GPIO_Port, BAT_CHARGE_MOS_Pin, POWER_SWITCH_OFF);
  HAL_GPIO_WritePin(BAT1_RECHARGE_MOS_GPIO_Port, BAT1_RECHARGE_MOS_Pin, POWER_SWITCH_OFF);
  HAL_GPIO_WritePin(BAT2_RECHARGE_MOS_GPIO_Port, BAT2_RECHARGE_MOS_Pin, POWER_SWITCH_OFF);
  HAL_GPIO_WritePin(BAT1_PRE_DISCHARGE_MOS_GPIO_Port, BAT1_PRE_DISCHARGE_MOS_Pin, POWER_SWITCH_OFF);
  HAL_GPIO_WritePin(BAT2_PRE_DISCHARGE_MOS_GPIO_Port, BAT2_PRE_DISCHARGE_MOS_Pin, POWER_SWITCH_OFF);
  HAL_GPIO_WritePin(BACK_EMF_ABSORB_1_GPIO_Port, BACK_EMF_ABSORB_1_Pin, POWER_SWITCH_OFF);
  HAL_GPIO_WritePin(PERIPHERAL_POWER_GPIO_Port, PERIPHERAL_POWER_Pin, POWER_SWITCH_OFF);

  /* 5. 关键保持：维持上位机 12V (PA7) 和声光 24V (PC4) 隔离 DCDC 开启 (低电平使能) */
  Power_SetDcdc12V(1U);
  Power_SetDcdc24V(1U);

  /* 维持当前放电电池主 MOS 持续导通 (高电平使能)，保障动力母线不掉电 */
  HAL_GPIO_WritePin(BAT1_DISCHARGE_MOS_GPIO_Port, BAT1_DISCHARGE_MOS_Pin, (batMask & 0x01U) ? POWER_SWITCH_ON : POWER_SWITCH_OFF);
  HAL_GPIO_WritePin(BAT2_DISCHARGE_MOS_GPIO_Port, BAT2_DISCHARGE_MOS_Pin, (batMask & 0x02U) ? POWER_SWITCH_ON : POWER_SWITCH_OFF);

  /* 蓝灯点亮指示升级中，熄灭绿灯与红灯 */
  HAL_GPIO_WritePin(RGB_LED_B_GPIO_Port, RGB_LED_B_Pin, GPIO_PIN_SET);
  HAL_GPIO_WritePin(RGB_LED_G_GPIO_Port, RGB_LED_G_Pin, GPIO_PIN_RESET);
  HAL_GPIO_WritePin(RGB_LED_R_GPIO_Port, RGB_LED_R_Pin, GPIO_PIN_RESET);
  HAL_GPIO_WritePin(BUZZER_ALARM_GPIO_Port, BUZZER_ALARM_Pin, GPIO_PIN_RESET);

  /* 6. 停止无关通信外设 */
  (void)HAL_FDCAN_Stop(&hfdcan1);
  (void)HAL_FDCAN_Stop(&hfdcan3);
  (void)HAL_UART_DeInit(&huart2);

  /* 7. 停止 FDCAN2 */
  (void)HAL_FDCAN_Stop(&hfdcan2);

  /* 8. 写入 Bootloader 升级标记与放电电池掩码到 SRAM 和 RTC/TAMP 备份寄存器 */
  __HAL_RCC_PWR_CLK_ENABLE();
  HAL_PWR_EnableBkUpAccess();
  TAMP->BKP0R = (IAP_BOOT_FLAG_MAGIC & 0xFFFF0000U) | (batMask & 0xFFFFU);
  *((volatile uint32_t *)IAP_BOOT_FLAG_ADDR) = (IAP_BOOT_FLAG_MAGIC & 0xFFFF0000U) | (batMask & 0xFFFFU);

  /* 9. 调用 HAL_RCC_DeInit() 将系统时钟安全回退至内部 HSI 16MHz，以便 Bootloader 干净执行 SystemClock_Config
   * (此时中断与 SysTick 尚在运行，HAL_RCC_DeInit 内部的 HAL_GetTick 超时机制可正常工作，避免死锁) */
  HAL_RCC_DeInit();

  /* 10. 彻底禁用全局中断，防止跳转过程中产生悬挂中断 */
  __disable_irq();

  /* 11. 停止 SysTick 定时器并清空计数器及其中断使能 (消除 HAL_RCC_DeInit 内部 HAL_InitTick 的副作用) */
  SysTick->CTRL = 0U;
  SysTick->LOAD = 0U;
  SysTick->VAL  = 0U;

  /* 12. 清除 SysTick 挂起标志与所有 NVIC 中断使能和挂起请求 */
  SCB->ICSR = SCB_ICSR_PENDSTCLR_Msk;
  for (uint8_t i = 0; i < 8; i++)
  {
    NVIC->ICER[i] = 0xFFFFFFFFU;
    NVIC->ICPR[i] = 0xFFFFFFFFU;
  }

  /* 13. 刷新并重置 Flash 预取与指令/数据缓存，防止旧指令残留导致 HardFault */
  __HAL_FLASH_INSTRUCTION_CACHE_DISABLE();
  __HAL_FLASH_DATA_CACHE_DISABLE();
  __HAL_FLASH_INSTRUCTION_CACHE_RESET();
  __HAL_FLASH_DATA_CACHE_RESET();
  __HAL_FLASH_INSTRUCTION_CACHE_ENABLE();
  __HAL_FLASH_DATA_CACHE_ENABLE();

  /* 14. 重定位中断向量表到 Bootloader 基地址 */
  SCB->VTOR = 0x08000000U;

  /* 15. 复位特权与堆栈控制寄存器，设置主堆栈指针 (MSP) 并执行内存屏障 */
  __set_CONTROL(0U);
  __set_MSP(bootMsp);
  __DSB();
  __ISB();

  /* 16. 平滑软件直接跳转至 Bootloader 入口 */
  void (*bootEntry)(void) = (void (*)(void))resetHandlerAddr;
  bootEntry();

  while (1)
  {
  }
}

void FDCAN_HandleIapCommand(const FDCAN_RxHeaderTypeDef *rxHeader, const uint8_t *rxData)
{
  if ((rxHeader == NULL) || (rxData == NULL))
  {
    return;
  }

  if ((rxHeader->IdType != FDCAN_EXTENDED_ID) ||
      (rxHeader->RxFrameType != FDCAN_DATA_FRAME) ||
      (rxHeader->Identifier != FDCAN_IAP_CMD_ID) ||
      (rxHeader->DataLength < FDCAN_DLC_BYTES_1))
  {
    return;
  }

  uint8_t cmd = rxData[0];
  FDCAN_TxHeaderTypeDef txHeader;
  uint8_t txData[8] = {0};

  txHeader.Identifier = FDCAN_IAP_RESP_ID;
  txHeader.IdType = FDCAN_EXTENDED_ID;
  txHeader.TxFrameType = FDCAN_DATA_FRAME;
  txHeader.DataLength = FDCAN_DLC_BYTES_8;
  txHeader.ErrorStateIndicator = FDCAN_ESI_ACTIVE;
  txHeader.BitRateSwitch = FDCAN_BRS_OFF;
  txHeader.FDFormat = FDCAN_CLASSIC_CAN;
  txHeader.TxEventFifoControl = FDCAN_NO_TX_EVENTS;
  txHeader.MessageMarker = 0U;

  if (cmd == 0x01U) /* PING: App 在线查询 */
  {
    txData[0] = 0x01U;
    txData[1] = 0x00U; /* ACK_OK */
    txData[2] = 0x02U; /* 状态: 当前在 App 中运行 */
    txData[3] = APP_FW_VERSION_MAJOR; /* App 固件版本 Major */
    txData[4] = APP_FW_VERSION_MINOR; /* App 固件版本 Minor */
    txData[5] = APP_FW_VERSION_PATCH; /* App 固件版本 Patch */
    txData[6] = 0x01U; /* App 固件有效状态 (当前正在 App 中运行) */
    txData[7] = 0x00U; /* 保留 */
    (void)HAL_FDCAN_AddMessageToTxFifoQ(&hfdcan2, &txHeader, txData);
  }
  else if (cmd == 0x02U) /* START_UPGRADE / ENTER_BOOTLOADER */
  {
    txData[0] = 0x02U;
    txData[1] = 0x00U; /* ACK_OK: 收到升级请求，准备切入 Bootloader */
    txData[2] = 0x02U; /* 标识当前从 App 响应 */
    (void)HAL_FDCAN_AddMessageToTxFifoQ(&hfdcan2, &txHeader, txData);

    /* 延时 20ms 确保 ACK 帧在物理 CAN 总线上发送完成 */
    HAL_Delay(20);

    /* 执行无缝热接力软件平滑跳转 */
    FDCAN_IAP_JumpToBootloader();
  }
}

static void FDCAN_PollRkRx(void)
{
  FDCAN_RxHeaderTypeDef rxHeader;
  uint8_t rxData[8];

  while (HAL_FDCAN_GetRxFifoFillLevel(&hfdcan2, FDCAN_RX_FIFO0) > 0U)
  {
    if (HAL_FDCAN_GetRxMessage(&hfdcan2, FDCAN_RX_FIFO0, &rxHeader, rxData) != HAL_OK)
    {
      return;
    }

    if (rxHeader.Identifier == FDCAN_RK_CHARGE_MODE_CMD_ID)
    {
      FDCAN_HandleRkChargeModeCommand(&rxHeader, rxData);
    }
    else if (rxHeader.Identifier == FDCAN_RK_INDICATOR_CMD_ID)
    {
      FDCAN_HandleRkIndicatorCommand(&rxHeader, rxData);
    }
    else if (rxHeader.Identifier == FDCAN_IAP_CMD_ID)
    {
      FDCAN_HandleIapCommand(&rxHeader, rxData);
    }
  }
}

HAL_StatusTypeDef FDCAN_SendChargeReplyToCharger(uint8_t batteryIndex)
{
  FDCAN_TxHeaderTypeDef txHeader;
  HAL_StatusTypeDef result = HAL_OK;
  uint8_t sentFrameCount = 0U;
  uint8_t slot;
  uint32_t primask;

  if ((batteryIndex < 1U) || (batteryIndex > 2U))
  {
    return HAL_ERROR;
  }

  /* 快速预检（无锁） */
  if (fdcan3_busoff_flag != 0U)
  {
    return HAL_BUSY;
  }

  for (slot = 0U; slot < 3U; slot++)
  {
    FDCAN_ChargeReplyFrame_t *frame = &batteryChargeReplyFrames[batteryIndex - 1U][slot];

    if (frame->valid == 0U)
    {
      continue;
    }

    if (HAL_FDCAN_GetTxFifoFreeLevel(&hfdcan3) == 0U)
    {
      result = HAL_BUSY;
      break;
    }

    /* 配置 txHeader（不需要在临界区内） */
    txHeader.Identifier = (frame->id & 0x00FFFFFFU) | 0x05000000U;
    txHeader.IdType = FDCAN_EXTENDED_ID;
    txHeader.TxFrameType = FDCAN_DATA_FRAME;
    txHeader.DataLength = frame->dataLength;
    txHeader.ErrorStateIndicator = FDCAN_ESI_ACTIVE;
    txHeader.BitRateSwitch = FDCAN_BRS_OFF;
    txHeader.FDFormat = FDCAN_CLASSIC_CAN;
    txHeader.TxEventFifoControl = FDCAN_NO_TX_EVENTS;
    txHeader.MessageMarker = batteryIndex;

    /* 临界区保护：原子检查标志与入队 */
    primask = __get_PRIMASK();
    __disable_irq();
    if (fdcan3_busoff_flag != 0U)
    {
      __set_PRIMASK(primask);
      return HAL_BUSY;
    }

    if (HAL_FDCAN_AddMessageToTxFifoQ(&hfdcan3, &txHeader, frame->data) == HAL_OK)
    {
      sentFrameCount++;
    }
    else
    {
      result = HAL_ERROR;
    }
    __set_PRIMASK(primask);
  }

  if (sentFrameCount != 0U)
  {
    result = HAL_OK;
  }
  else
  {
    result = HAL_ERROR;
  }

  return result;
}

__attribute__((unused))
static HAL_StatusTypeDef FDCAN_SendBatteryWakeFrame(FDCAN_HandleTypeDef *hfdcan, uint8_t marker)
{
  FDCAN_TxHeaderTypeDef txHeader;
  uint8_t txData[8] = {0U, 0U, 0U, 0U, 0U, 0U, 0U, 0U};
  HAL_StatusTypeDef status;
  uint32_t primask;

  /* 参数有效性检查 */
  if (hfdcan == NULL)
  {
    return HAL_ERROR;
  }

  /* 只允许 FDCAN1/3 调用此函数（FDCAN2 用于上位机上报，不发送唤醒帧） */
  if ((hfdcan != &hfdcan1) && (hfdcan != &hfdcan3))
  {
    return HAL_ERROR;
  }

  /* 快速预检（无锁） */
  if ((hfdcan == &hfdcan1 && fdcan1_busoff_flag != 0U) ||
      (hfdcan == &hfdcan3 && fdcan3_busoff_flag != 0U))
  {
    return HAL_BUSY;
  }

  if (HAL_FDCAN_GetTxFifoFreeLevel(hfdcan) == 0U)
  {
    return HAL_BUSY;
  }

  /* 配置 txHeader（不需要在临界区内） */
  txHeader.Identifier = 0x0400FF80U;
  txHeader.IdType = FDCAN_EXTENDED_ID;
  txHeader.TxFrameType = FDCAN_DATA_FRAME;
  txHeader.DataLength = FDCAN_DLC_BYTES_8;
  txHeader.ErrorStateIndicator = FDCAN_ESI_ACTIVE;
  txHeader.BitRateSwitch = FDCAN_BRS_OFF;
  txHeader.FDFormat = FDCAN_CLASSIC_CAN;
  txHeader.TxEventFifoControl = FDCAN_NO_TX_EVENTS;
  txHeader.MessageMarker = marker;

  /* 临界区保护：原子检查标志与入队 */
  primask = __get_PRIMASK();
  __disable_irq();
  if ((hfdcan == &hfdcan1 && fdcan1_busoff_flag != 0U) ||
      (hfdcan == &hfdcan3 && fdcan3_busoff_flag != 0U))
  {
    __set_PRIMASK(primask);
    return HAL_BUSY;
  }
  status = HAL_FDCAN_AddMessageToTxFifoQ(hfdcan, &txHeader, txData);
  __set_PRIMASK(primask);

  return status;
}

void FDCAN_BatteryCanStart(void)
{
  if (batteryCanStarted != 0U)
  {
    return;
  }

  FDCAN_ConfigBatteryRxFilters(&hfdcan1);
  FDCAN_ConfigBatteryRxFilters(&hfdcan3);
  FDCAN_ConfigRkRxFilters();

  if (HAL_FDCAN_Start(&hfdcan1) != HAL_OK)
  {
    Error_Handler();
  }

  if (HAL_FDCAN_Start(&hfdcan2) != HAL_OK)
  {
    Error_Handler();
  }

  if (HAL_FDCAN_Start(&hfdcan3) != HAL_OK)
  {
    Error_Handler();
  }

  /* 使能 Bus-Off 中断 */
  (void)HAL_FDCAN_ActivateNotification(&hfdcan1, FDCAN_IT_BUS_OFF, 0U);
  (void)HAL_FDCAN_ActivateNotification(&hfdcan2, FDCAN_IT_BUS_OFF, 0U);
  (void)HAL_FDCAN_ActivateNotification(&hfdcan3, FDCAN_IT_BUS_OFF, 0U);

  batteryCanStarted = 1U;
  bat1AllowedDebounceCount = 0U;
  bat1ProhibitDebounceCount = 0U;
  bat1UnknownDebounceCount = 0U;
  bat2AllowedDebounceCount = 0U;
  bat2ProhibitDebounceCount = 0U;
  bat2UnknownDebounceCount = 0U;
  batteryCanLastTxTick = HAL_GetTick() - FDCAN_BATTERY_WAKE_PERIOD_MS;
  currentReportLastTxTick = HAL_GetTick();
  /* estopReportLastTxTick = HAL_GetTick() - FDCAN_ESTOP_REPORT_PERIOD_MS; // [急停功能已停用] */
  batteryAlarmReportLastTxTick = HAL_GetTick() - FDCAN_BATTERY_ALARM_REPORT_PERIOD_MS;
}//负责初始化接收过滤器并启动 CAN。

void FDCAN_BatteryCanTask(void)
{
  static uint8_t prevBat1Alarm = BATTERY_ALARM_STATUS_NORMAL;
  static uint8_t prevBat2Alarm = BATTERY_ALARM_STATUS_NORMAL;
  static uint8_t prevBat1DischargeMos = 0U;
  static uint8_t prevBat1RechargeMos = 0U;
  static uint8_t prevBat1ChargeMos = 0U;
  static uint8_t prevBat2DischargeMos = 0U;
  static uint8_t prevBat2RechargeMos = 0U;
  static uint8_t prevBat2ChargeMos = 0U;
  static uint8_t alarmClearBurstRemaining = 0U;
  static uint8_t mosChangedPending = 0U;

  uint32_t now;

  if (batteryCanStarted == 0U)
  {
    return;
  }

  now = HAL_GetTick();

  FDCAN_PollRkRx();
  FDCAN_PollBatteryRx(&hfdcan1, 1U);
  FDCAN_PollBatteryRx(&hfdcan3, 2U);

  /* 充电桩通信超时监测：在充电激活状态下，若超过 FDCAN_CHARGER_CAN_TIMEOUT_MS（当前3000ms）未收到充电桩握手帧（拔枪或充电机断电），自动退出充电模式 */
  now = HAL_GetTick();  /* 在超时判断前刷新 now，消除与 PollBatteryRx 内部更新 charger_can_last_rx_tick 的时序下溢 */
  if (charge_mode_active != 0U)
  {
    uint32_t elapsed = now - charger_can_last_rx_tick;
    if ((charger_can_last_rx_tick != 0U) && (elapsed < 0x80000000U) && (elapsed >= FDCAN_CHARGER_CAN_TIMEOUT_MS))
    {
      rk_charge_mode_request = 0U;
      charge_mode_active = 0U;
      Power_ExitChargeMode();
      FDCAN_SendChargeModeStatusToRk(FDCAN_CHARGE_MODE_EXIT);
    }
  }

  /* RK 上报统一门禁：FDCAN2 Bus-Off 期间跳过所有向 RK 的上报，避免无效计算 */
  if (fdcan2_busoff_flag == 0U)
  {
    /* [急停功能已停用，硬件未连接]
    if ((Power_IsEmergencyStopActive() != 0U) &&
        ((now - estopReportLastTxTick) >= FDCAN_ESTOP_REPORT_PERIOD_MS))
    {
      estopReportLastTxTick = now;
      FDCAN_SendEmergencyStopReportToRk();
    }
    */

    uint8_t curBat1Alarm = Power_GetBattery1AlarmStatus();
    uint8_t curBat2Alarm = Power_GetBattery2AlarmStatus();
    uint8_t hasAlarm = ((curBat1Alarm != BATTERY_ALARM_STATUS_NORMAL) ||
                        (curBat2Alarm != BATTERY_ALARM_STATUS_NORMAL)) ? 1U : 0U;

    /* 监测本地 MOS 状态是否发生跳变（放电、回充、充电 MOS） */
    uint8_t mosChanged = ((bat1_discharge_mos_state != prevBat1DischargeMos) ||
                          (bat1_recharge_mos_state != prevBat1RechargeMos) ||
                          (bat1_charge_mos_state != prevBat1ChargeMos) ||
                          (bat2_discharge_mos_state != prevBat2DischargeMos) ||
                          (bat2_recharge_mos_state != prevBat2RechargeMos) ||
                          (bat2_charge_mos_state != prevBat2ChargeMos)) ? 1U : 0U;

    if (mosChanged != 0U)
    {
      mosChangedPending = 1U;
    }

    /* 检测是否从有报警恢复到全正常 */
    if ((hasAlarm == 0U) &&
        ((prevBat1Alarm != BATTERY_ALARM_STATUS_NORMAL) ||
         (prevBat2Alarm != BATTERY_ALARM_STATUS_NORMAL)))
    {
      alarmClearBurstRemaining = FDCAN_BATTERY_ALARM_CLEAR_BURST_COUNT;
    }

    prevBat1Alarm = curBat1Alarm;
    prevBat2Alarm = curBat2Alarm;
    prevBat1DischargeMos = bat1_discharge_mos_state;
    prevBat1RechargeMos = bat1_recharge_mos_state;
    prevBat1ChargeMos = bat1_charge_mos_state;
    prevBat2DischargeMos = bat2_discharge_mos_state;
    prevBat2RechargeMos = bat2_recharge_mos_state;
    prevBat2ChargeMos = bat2_charge_mos_state;

    /* 
     * 状态上报优先级决策：
     * 1. 最高优先级：mosChangedPending 激活（本地 MOS 状态发生开/关动作），
     *    立即触发发送，不受报警限速或心跳周期延缓；若遇 Tx FIFO 满返回 HAL_BUSY 则保持挂起重试，杜绝事件丢失；
     * 2. 次高优先级：hasAlarm != 0（存在电池异常报警），按 200ms 周期高频刷新上报；
     * 3. 第三优先级：alarmClearBurstRemaining > 0（刚从异常恢复正常），按 200ms 周期突发连续确认；
     * 4. 最低优先级：正常状态下按 1000ms 心跳周期低频保活上报。
     */
    if (mosChangedPending != 0U)
    {
      if (FDCAN_SendBatteryAlarmReportToRk() == HAL_OK)
      {
        batteryAlarmReportLastTxTick = now;
        mosChangedPending = 0U;
      }
    }
    else if (hasAlarm != 0U)
    {
      if ((now - batteryAlarmReportLastTxTick) >= FDCAN_BATTERY_ALARM_REPORT_PERIOD_MS)
      {
        if (FDCAN_SendBatteryAlarmReportToRk() == HAL_OK)
        {
          batteryAlarmReportLastTxTick = now;
        }
      }
    }
    else if (alarmClearBurstRemaining > 0U)
    {
      if ((now - batteryAlarmReportLastTxTick) >= FDCAN_BATTERY_ALARM_REPORT_PERIOD_MS)
      {
        if (FDCAN_SendBatteryAlarmReportToRk() == HAL_OK)
        {
          batteryAlarmReportLastTxTick = now;
          alarmClearBurstRemaining--;
        }
      }
    }
    else
    {
      if ((now - batteryAlarmReportLastTxTick) >= FDCAN_BATTERY_ALARM_HEARTBEAT_PERIOD_MS)
      {
        if (FDCAN_SendBatteryAlarmReportToRk() == HAL_OK)
        {
          batteryAlarmReportLastTxTick = now;
        }
      }
    }

    if ((now - currentReportLastTxTick) >= FDCAN_CURRENT_REPORT_PERIOD_MS)
    {
      currentReportLastTxTick = now;
      FDCAN_SendCurrentReportsToRk();
    }

    if ((now - rkIndicatorReportLastTxTick) >= FDCAN_RK_INDICATOR_REPORT_PERIOD_MS)
    {
      rkIndicatorReportLastTxTick = now;
      (void)FDCAN_SendIndicatorStatusToRk(Power_GetPhysicalR(),
                                          Power_GetPhysicalG(),
                                          Power_GetPhysicalB(),
                                          Power_GetPhysicalBuzzer());
    }
  } /* 结束 RK 门禁保护块 */

#if !POWER_TEST_BENCH_SUPPLY_MODE
  if ((now - batteryCanLastTxTick) < FDCAN_BATTERY_WAKE_PERIOD_MS)
  {
    return;
  }

  batteryCanLastTxTick = now;
  (void)FDCAN_SendBatteryWakeFrame(&hfdcan1, 1U);
  (void)FDCAN_SendBatteryWakeFrame(&hfdcan3, 2U);
#endif
}//负责初始化接收过滤器并启动 CAN。

/* Bus-Off 中断回调：仅单次读取 PSR，记录代际号，置 pending 态 */
void HAL_FDCAN_ErrorStatusCallback(FDCAN_HandleTypeDef *hfdcan, uint32_t ErrorStatusITs)
{
  uint32_t now = HAL_GetTick();
  uint32_t psr_snapshot;

  if ((ErrorStatusITs & FDCAN_IT_BUS_OFF) != 0U)
  {
    psr_snapshot = hfdcan->Instance->PSR;
    if ((psr_snapshot & FDCAN_PSR_BO) != 0U)
    {
      if (hfdcan->Instance == FDCAN1)
      {
        fdcan1_busoff_generation++;
        fdcan1_busoff_flag = 1U;
        fdcan1_busoff_state = FDCAN_BUSOFF_STATE_PENDING;
        fdcan1BusoffDetectTick = now;
        fdcan1_last_psr = psr_snapshot;
        fdcan1_last_ecr = hfdcan->Instance->ECR;
      }
      else if (hfdcan->Instance == FDCAN2)
      {
        fdcan2_busoff_generation++;
        fdcan2_busoff_flag = 1U;
        fdcan2_busoff_state = FDCAN_BUSOFF_STATE_PENDING;
        fdcan2BusoffDetectTick = now;
        fdcan2_last_psr = psr_snapshot;
        fdcan2_last_ecr = hfdcan->Instance->ECR;
      }
      else if (hfdcan->Instance == FDCAN3)
      {
        fdcan3_busoff_generation++;
        fdcan3_busoff_flag = 1U;
        fdcan3_busoff_state = FDCAN_BUSOFF_STATE_PENDING;
        fdcan3BusoffDetectTick = now;
        fdcan3_last_psr = psr_snapshot;
        fdcan3_last_ecr = hfdcan->Instance->ECR;
      }
    }
  }
}

/* USER CODE END 0 */

FDCAN_HandleTypeDef hfdcan1;
FDCAN_HandleTypeDef hfdcan2;
FDCAN_HandleTypeDef hfdcan3;

/* FDCAN1 init function */
void MX_FDCAN1_Init(void)
{

  hfdcan1.Instance = FDCAN1;
  hfdcan1.Init.ClockDivider = FDCAN_CLOCK_DIV1;
  hfdcan1.Init.FrameFormat = FDCAN_FRAME_CLASSIC;
  hfdcan1.Init.Mode = FDCAN_MODE_NORMAL;
  hfdcan1.Init.AutoRetransmission = ENABLE;
  hfdcan1.Init.TransmitPause = DISABLE;
  hfdcan1.Init.ProtocolException = DISABLE;
  hfdcan1.Init.NominalPrescaler = 40;
  hfdcan1.Init.NominalSyncJumpWidth = 1;
  hfdcan1.Init.NominalTimeSeg1 = 13;
  hfdcan1.Init.NominalTimeSeg2 = 3;
  hfdcan1.Init.DataPrescaler = 1;
  hfdcan1.Init.DataSyncJumpWidth = 1;
  hfdcan1.Init.DataTimeSeg1 = 1;
  hfdcan1.Init.DataTimeSeg2 = 1;
  hfdcan1.Init.StdFiltersNbr = 1;
  hfdcan1.Init.ExtFiltersNbr = 7;
  hfdcan1.Init.TxFifoQueueMode = FDCAN_TX_FIFO_OPERATION;
  if (HAL_FDCAN_Init(&hfdcan1) != HAL_OK)
  {
    Error_Handler();
  }
}
/* FDCAN2 init function */
void MX_FDCAN2_Init(void)
{

  hfdcan2.Instance = FDCAN2;
  hfdcan2.Init.ClockDivider = FDCAN_CLOCK_DIV1;
  hfdcan2.Init.FrameFormat = FDCAN_FRAME_CLASSIC;
  hfdcan2.Init.Mode = FDCAN_MODE_NORMAL;
  hfdcan2.Init.AutoRetransmission = ENABLE;
  hfdcan2.Init.TransmitPause = DISABLE;
  hfdcan2.Init.ProtocolException = DISABLE;
  hfdcan2.Init.NominalPrescaler = 40;
  hfdcan2.Init.NominalSyncJumpWidth = 1;
  hfdcan2.Init.NominalTimeSeg1 = 13;
  hfdcan2.Init.NominalTimeSeg2 = 3;
  hfdcan2.Init.DataPrescaler = 1;
  hfdcan2.Init.DataSyncJumpWidth = 1;
  hfdcan2.Init.DataTimeSeg1 = 1;
  hfdcan2.Init.DataTimeSeg2 = 1;
  hfdcan2.Init.StdFiltersNbr = 1;
  hfdcan2.Init.ExtFiltersNbr = 8;
  hfdcan2.Init.TxFifoQueueMode = FDCAN_TX_FIFO_OPERATION;
  if (HAL_FDCAN_Init(&hfdcan2) != HAL_OK)
  {
    Error_Handler();
  }
}
/* FDCAN3 init function */
void MX_FDCAN3_Init(void)
{

  hfdcan3.Instance = FDCAN3;
  hfdcan3.Init.ClockDivider = FDCAN_CLOCK_DIV1;
  hfdcan3.Init.FrameFormat = FDCAN_FRAME_CLASSIC;
  hfdcan3.Init.Mode = FDCAN_MODE_NORMAL;
  hfdcan3.Init.AutoRetransmission = ENABLE;
  hfdcan3.Init.TransmitPause = DISABLE;
  hfdcan3.Init.ProtocolException = DISABLE;
  hfdcan3.Init.NominalPrescaler = 40;
  hfdcan3.Init.NominalSyncJumpWidth = 1;
  hfdcan3.Init.NominalTimeSeg1 = 13;
  hfdcan3.Init.NominalTimeSeg2 = 3;
  hfdcan3.Init.DataPrescaler = 1;
  hfdcan3.Init.DataSyncJumpWidth = 1;
  hfdcan3.Init.DataTimeSeg1 = 1;
  hfdcan3.Init.DataTimeSeg2 = 1;
  hfdcan3.Init.StdFiltersNbr = 1;
  hfdcan3.Init.ExtFiltersNbr = 8;
  hfdcan3.Init.TxFifoQueueMode = FDCAN_TX_FIFO_OPERATION;
  if (HAL_FDCAN_Init(&hfdcan3) != HAL_OK)
  {
    Error_Handler();
  }
}

static uint32_t HAL_RCC_FDCAN_CLK_ENABLED=0;

void HAL_FDCAN_MspInit(FDCAN_HandleTypeDef* fdcanHandle)
{

  GPIO_InitTypeDef GPIO_InitStruct = {0};
  RCC_PeriphCLKInitTypeDef PeriphClkInit = {0};
  if(fdcanHandle->Instance==FDCAN1)
  {
  /** Initializes the peripherals clocks
  */
    PeriphClkInit.PeriphClockSelection = RCC_PERIPHCLK_FDCAN;
    PeriphClkInit.FdcanClockSelection = RCC_FDCANCLKSOURCE_PCLK1;
    if (HAL_RCCEx_PeriphCLKConfig(&PeriphClkInit) != HAL_OK)
    {
      Error_Handler();
    }

    /* FDCAN1 clock enable */
    HAL_RCC_FDCAN_CLK_ENABLED++;
    if(HAL_RCC_FDCAN_CLK_ENABLED==1){
      __HAL_RCC_FDCAN_CLK_ENABLE();
    }

    __HAL_RCC_GPIOA_CLK_ENABLE();
    /**FDCAN1 GPIO Configuration
    PA11     ------> FDCAN1_RX
    PA12     ------> FDCAN1_TX
    */
    GPIO_InitStruct.Pin = GPIO_PIN_11|GPIO_PIN_12;
    GPIO_InitStruct.Mode = GPIO_MODE_AF_PP;
    GPIO_InitStruct.Pull = GPIO_NOPULL;
    GPIO_InitStruct.Speed = GPIO_SPEED_FREQ_LOW;
    GPIO_InitStruct.Alternate = GPIO_AF9_FDCAN1;
    HAL_GPIO_Init(GPIOA, &GPIO_InitStruct);

    /* FDCAN1 interrupt Init */
    HAL_NVIC_SetPriority(FDCAN1_IT0_IRQn, 0, 0);
    HAL_NVIC_EnableIRQ(FDCAN1_IT0_IRQn);
    HAL_NVIC_SetPriority(FDCAN1_IT1_IRQn, 0, 0);
    HAL_NVIC_EnableIRQ(FDCAN1_IT1_IRQn);
  }
  else if(fdcanHandle->Instance==FDCAN2)
  {
  /** Initializes the peripherals clocks
  */
    PeriphClkInit.PeriphClockSelection = RCC_PERIPHCLK_FDCAN;
    PeriphClkInit.FdcanClockSelection = RCC_FDCANCLKSOURCE_PCLK1;
    if (HAL_RCCEx_PeriphCLKConfig(&PeriphClkInit) != HAL_OK)
    {
      Error_Handler();
    }

    /* FDCAN2 clock enable */
    HAL_RCC_FDCAN_CLK_ENABLED++;
    if(HAL_RCC_FDCAN_CLK_ENABLED==1){
      __HAL_RCC_FDCAN_CLK_ENABLE();
    }

    __HAL_RCC_GPIOB_CLK_ENABLE();
    /**FDCAN2 GPIO Configuration
    PB13     ------> FDCAN2_TX
    PB5     ------> FDCAN2_RX
    */
    GPIO_InitStruct.Pin = GPIO_PIN_13|GPIO_PIN_5;
    GPIO_InitStruct.Mode = GPIO_MODE_AF_PP;
    GPIO_InitStruct.Pull = GPIO_NOPULL;
    GPIO_InitStruct.Speed = GPIO_SPEED_FREQ_LOW;
    GPIO_InitStruct.Alternate = GPIO_AF9_FDCAN2;
    HAL_GPIO_Init(GPIOB, &GPIO_InitStruct);

    /* FDCAN2 interrupt Init */
    HAL_NVIC_SetPriority(FDCAN2_IT0_IRQn, 0, 0);
    HAL_NVIC_EnableIRQ(FDCAN2_IT0_IRQn);
    HAL_NVIC_SetPriority(FDCAN2_IT1_IRQn, 0, 0);
    HAL_NVIC_EnableIRQ(FDCAN2_IT1_IRQn);
  }
  else if(fdcanHandle->Instance==FDCAN3)
  {
  /** Initializes the peripherals clocks
  */
    PeriphClkInit.PeriphClockSelection = RCC_PERIPHCLK_FDCAN;
    PeriphClkInit.FdcanClockSelection = RCC_FDCANCLKSOURCE_PCLK1;
    if (HAL_RCCEx_PeriphCLKConfig(&PeriphClkInit) != HAL_OK)
    {
      Error_Handler();
    }

    /* FDCAN3 clock enable */
    HAL_RCC_FDCAN_CLK_ENABLED++;
    if(HAL_RCC_FDCAN_CLK_ENABLED==1){
      __HAL_RCC_FDCAN_CLK_ENABLE();
    }

    __HAL_RCC_GPIOA_CLK_ENABLE();
    __HAL_RCC_GPIOB_CLK_ENABLE();
    /**FDCAN3 GPIO Configuration
    PA8     ------> FDCAN3_RX
    PB4     ------> FDCAN3_TX
    */
    GPIO_InitStruct.Pin = GPIO_PIN_8;
    GPIO_InitStruct.Mode = GPIO_MODE_AF_PP;
    GPIO_InitStruct.Pull = GPIO_NOPULL;
    GPIO_InitStruct.Speed = GPIO_SPEED_FREQ_LOW;
    GPIO_InitStruct.Alternate = GPIO_AF11_FDCAN3;
    HAL_GPIO_Init(GPIOA, &GPIO_InitStruct);

    GPIO_InitStruct.Pin = GPIO_PIN_4;
    GPIO_InitStruct.Mode = GPIO_MODE_AF_PP;
    GPIO_InitStruct.Pull = GPIO_NOPULL;
    GPIO_InitStruct.Speed = GPIO_SPEED_FREQ_LOW;
    GPIO_InitStruct.Alternate = GPIO_AF11_FDCAN3;
    HAL_GPIO_Init(GPIOB, &GPIO_InitStruct);

    /* FDCAN3 interrupt Init */
    HAL_NVIC_SetPriority(FDCAN3_IT0_IRQn, 0, 0);
    HAL_NVIC_EnableIRQ(FDCAN3_IT0_IRQn);
    HAL_NVIC_SetPriority(FDCAN3_IT1_IRQn, 0, 0);
    HAL_NVIC_EnableIRQ(FDCAN3_IT1_IRQn);
  }
}

void HAL_FDCAN_MspDeInit(FDCAN_HandleTypeDef* fdcanHandle)
{

  if(fdcanHandle->Instance==FDCAN1)
  {
    /* Peripheral clock disable */
    HAL_RCC_FDCAN_CLK_ENABLED--;
    if(HAL_RCC_FDCAN_CLK_ENABLED==0){
      __HAL_RCC_FDCAN_CLK_DISABLE();
    }

    /**FDCAN1 GPIO Configuration
    PA11     ------> FDCAN1_RX
    PA12     ------> FDCAN1_TX
    */
    HAL_GPIO_DeInit(GPIOA, GPIO_PIN_11|GPIO_PIN_12);

    /* FDCAN1 interrupt Deinit */
    HAL_NVIC_DisableIRQ(FDCAN1_IT0_IRQn);
    HAL_NVIC_DisableIRQ(FDCAN1_IT1_IRQn);
  }
  else if(fdcanHandle->Instance==FDCAN2)
  {
    /* Peripheral clock disable */
    HAL_RCC_FDCAN_CLK_ENABLED--;
    if(HAL_RCC_FDCAN_CLK_ENABLED==0){
      __HAL_RCC_FDCAN_CLK_DISABLE();
    }

    /**FDCAN2 GPIO Configuration
    PB13     ------> FDCAN2_TX
    PB5     ------> FDCAN2_RX
    */
    HAL_GPIO_DeInit(GPIOB, GPIO_PIN_13|GPIO_PIN_5);

    /* FDCAN2 interrupt Deinit */
    HAL_NVIC_DisableIRQ(FDCAN2_IT0_IRQn);
    HAL_NVIC_DisableIRQ(FDCAN2_IT1_IRQn);
  }
  else if(fdcanHandle->Instance==FDCAN3)
  {
    /* Peripheral clock disable */
    HAL_RCC_FDCAN_CLK_ENABLED--;
    if(HAL_RCC_FDCAN_CLK_ENABLED==0){
      __HAL_RCC_FDCAN_CLK_DISABLE();
    }

    /**FDCAN3 GPIO Configuration
    PA8     ------> FDCAN3_RX
    PB4     ------> FDCAN3_TX
    */
    HAL_GPIO_DeInit(GPIOA, GPIO_PIN_8);

    HAL_GPIO_DeInit(GPIOB, GPIO_PIN_4);

    /* FDCAN3 interrupt Deinit */
    HAL_NVIC_DisableIRQ(FDCAN3_IT0_IRQn);
    HAL_NVIC_DisableIRQ(FDCAN3_IT1_IRQn);
  }
}

/* USER CODE BEGIN 1 */
float FDCAN_GetBatterySoc(uint8_t batteryIndex)
{
  if (batteryIndex == 1U)
  {
    return battery1_can_soc;
  }
  else if (batteryIndex == 2U)
  {
    return battery2_can_soc;
  }
  return 0.0f;
}

uint8_t FDCAN_IsBatterySocValid(uint8_t batteryIndex)
{
  uint32_t now = HAL_GetTick();

  if (batteryIndex == 1U)
  {
    if ((battery1_can_soc_valid != 0U) &&
        (battery1_can_status_last_rx_tick != 0U) &&
        ((now - battery1_can_status_last_rx_tick) <= 2000U))
    {
      return 1U;
    }
  }
  else if (batteryIndex == 2U)
  {
    if ((battery2_can_soc_valid != 0U) &&
        (battery2_can_status_last_rx_tick != 0U) &&
        ((now - battery2_can_status_last_rx_tick) <= 2000U))
    {
      return 1U;
    }
  }

  return 0U;
}

uint8_t FDCAN_IsAnyBusOff(void)
{
#if POWER_TEST_BENCH_SUPPLY_MODE
  /* 稳压电源测试模式下，可能未连接任何 CAN 从机节点，屏蔽 Bus-Off 报警避免指示灯闪烁 */
  return 0U;
#else
  /* 统一信任中断与 100ms 兜底状态机同步维护的软件标志，避免在主循环高频直读 PSR 导致 PSR.LEC 被清零 */
  return ((fdcan1_busoff_flag != 0U) || (fdcan2_busoff_flag != 0U) || (fdcan3_busoff_flag != 0U)) ? 1U : 0U;
#endif
}

uint8_t FDCAN_IsRkRgbActive(void)
{
  if (rkIndicatorCtrl.rgbTakeover == 0U)
  {
    return 0U;
  }
  if (rkIndicatorCtrl.timeoutMs == 0U)
  {
    return 1U;
  }
  return ((HAL_GetTick() - rkIndicatorCtrl.lastRxTick) <= rkIndicatorCtrl.timeoutMs) ? 1U : 0U;
}

uint8_t FDCAN_IsRkBuzzerActive(void)
{
#if DEBUG_DISABLE_RK_BUZZER_CTRL
  return 0U; /* 调试配置：小脑控制蜂鸣器接口关闭 */
#else
  if (rkIndicatorCtrl.buzzerTakeover == 0U)
  {
    return 0U;
  }
  if (rkIndicatorCtrl.timeoutMs == 0U)
  {
    return 1U;
  }
  return ((HAL_GetTick() - rkIndicatorCtrl.lastRxTick) <= rkIndicatorCtrl.timeoutMs) ? 1U : 0U;
#endif
}

HAL_StatusTypeDef FDCAN_SendIndicatorStatusToRk(uint8_t rOutput, uint8_t gOutput, uint8_t bOutput, uint8_t buzzerOutput)
{
  uint8_t statusData[8] = {0U, 0U, 0U, 0U, 0U, 0U, 0U, 0U};
  uint8_t takeoverByte = 0U;
  float minSoc = 100.0f;
  uint8_t hasSoc = 0U;
  uint8_t faultByte = 0U;

  if (FDCAN_IsRkRgbActive() != 0U)
  {
    takeoverByte |= 0x01U;
  }
  if (FDCAN_IsRkBuzzerActive() != 0U)
  {
    takeoverByte |= 0x02U;
  }

  statusData[0] = takeoverByte;
  statusData[1] = (rOutput != 0U) ? 1U : 0U;
  statusData[2] = (gOutput != 0U) ? 1U : 0U;
  statusData[3] = (bOutput != 0U) ? 1U : 0U;
  statusData[4] = (buzzerOutput != 0U) ? 1U : 0U;

  if (FDCAN_IsBatterySocValid(1U) != 0U)
  {
    minSoc = FDCAN_GetBatterySoc(1U);
    hasSoc = 1U;
  }
  if (FDCAN_IsBatterySocValid(2U) != 0U)
  {
    float s2 = FDCAN_GetBatterySoc(2U);
    if ((hasSoc == 0U) || (s2 < minSoc))
    {
      minSoc = s2;
    }
    hasSoc = 1U;
  }
  statusData[5] = (hasSoc != 0U) ? (uint8_t)(minSoc + 0.5f) : 100U;

  if (FDCAN_IsAnyBusOff() != 0U)
  {
    faultByte |= 0x01U;
  }
  /* [急停功能已停用，硬件未连接]
  if (Power_IsEmergencyStopActive() != 0U)
  {
    faultByte |= 0x02U;
  }
  */
  if ((hasSoc != 0U) && (minSoc < 20.0f))
  {
    faultByte |= 0x04U;
  }
  statusData[6] = faultByte;
  statusData[7] = 0x00U;

  return FDCAN_SendCurrentReport(FDCAN_RK_INDICATOR_STATUS_ID, statusData);
}
/* USER CODE END 1 */
