wajmh/D-Y/Core/Inc/adc.h

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
/* Define to prevent recursive inclusion -------------------------------------*/
#ifndef __ADC_H__
#define __ADC_H__

#ifdef __cplusplus
extern "C" {
#endif

/* Includes ------------------------------------------------------------------*/
#include "main.h"

extern ADC_HandleTypeDef hadc2;

/* USER CODE BEGIN Private defines */

#define ADC_REFERENCE_VOLTAGE                         3.26f
#define ADC_MAX_RAW_VALUE                             4095.0f

/* VBUS 分压电阻：R10(30k) + R9(30k) + R54(47k) = 107kΩ，R52(2kΩ) */
#define VBUS_VOLTAGE_DIVIDER_TOP_OHM                  107000.0f
#define VBUS_VOLTAGE_DIVIDER_BOTTOM_OHM               2000.0f
#define VBUS_VOLTAGE_DIVIDER_RATIO                    ((VBUS_VOLTAGE_DIVIDER_TOP_OHM + VBUS_VOLTAGE_DIVIDER_BOTTOM_OHM) / VBUS_VOLTAGE_DIVIDER_BOTTOM_OHM)

#define CURRENT_ZERO_VOLTAGE                          1.600f
#define PERIPHERAL_DISCHARGE_CURRENT_AMPS_PER_VOLT    25.0f

/* USER CODE END Private defines */

void MX_ADC2_Init(void);

/* USER CODE BEGIN Prototypes */

/* ADC2 DMA 采样启动、停止与校准 */
void ADC2_StartDMA(void);
void ADC2_StopDMA(void);
void ADC_CalibrateCurrentOffsets(void);
void ADC_CalibrateLegCurrentOffsets(void); /* 兼容旧接口名 */
void ADC_UpdateCurrents(void);
void ADC2_UpdateVbusVoltage(void);
void ADC2_UpdateBatteryVoltages(void); /* 保持兼容接口名 */

/* 模拟量读取接口 */
float ADC_GetVbusVoltage(void);
float ADC_GetPeripheralDischargeCurrent(void);
uint16_t ADC2_GetPeripheralDischargeCurrentADC(void);
uint16_t ADC2_GetVbusVoltageADC(void);

/* 兼容保留的废弃函数与变量接口（未接硬件，保持空实现避免链接报错） */
uint16_t ADC1_GetLegCurrentADC(uint8_t leg);
uint16_t ADC1_GetLegCurrentOffsetADC(uint8_t leg);
uint16_t ADC1_GetBattery1CurrentADC(void);
uint16_t ADC1_GetBattery2CurrentADC(void);
float ADC_GetLegCurrent(uint8_t leg);
float ADC_GetLeg1Current(void);
float ADC_GetLeg2Current(void);
float ADC_GetLeg3Current(void);
float ADC_GetLeg4Current(void);
float ADC_GetBattery1Current(void);
float ADC_GetBattery2Current(void);
float ADC2_GetBattery1Voltage(void);
float ADC2_GetBattery2Voltage(void);

/* 全局变量 */
extern float vbus_voltage;
extern uint16_t adc2_buffer[2];
extern float peripheral_discharge_current;
extern float battery1_voltage;
extern float battery2_voltage;
extern float leg_current[4];
extern float battery1_current;
extern float battery2_current;

/* USER CODE END Prototypes */

#ifdef __cplusplus
}
#endif

#endif /* __ADC_H__ */
