wajmh/D-Y/Bootloader/Core/Inc/boot_jump.h

#ifndef __BOOT_JUMP_H__
#define __BOOT_JUMP_H__

#ifdef __cplusplus
extern "C" {
#endif

#include "stm32g4xx_hal.h"

void Boot_JumpToApp(void);

#ifdef __cplusplus
}
#endif

#endif /* __BOOT_JUMP_H__ */
