wajmh/D-Y/(commit log)

2026-05-17 电源板初始配置代码
2026-05-20 adc采样的双电池模组的电压
2026-05-24 初版双电池版本 但未完善
2026-05-29 上电池放电版本
2026-05-29 四条腿以及外设的电流采样ok
2026-06-05 目前电源板放电&can通信
2026-07-13 添加急停和信息上报
2026-07-27 反接引脚（硬件提出）
2026-08-17 Add files via upload
    docs: 添加电源板硬件说明PDF
2026-08-20 更改预充时间为400ms
2026-08-25 工程转cmake工程后的第一次提交
2026-08-25 双电池dcdc不重复delay
2026-09-03 电池CAN通信掉线安全处理
    区分电池物理拔出与 CAN 通信掉线；通信掉线时保持动力和外设供电，物理拔出时关闭对应路径。新增 0x04400000 状态上报，并保留双电池预充与反电吸收单次释放处理。
2026-09-03 修复BMS放电状态与预充逻辑
2026-09-03 通过CAN向小脑上报双电池主放电MOS与回充MOS状态
    主要实施内容：
    1. 报文载荷扩展 (0x04400000U, DLC=8)
    - Byte 0: BAT1 告警状态 (0x00~0x04)
    - Byte 1: BAT2 告警状态 (0x00~0x04)
    - Byte 2: BAT1 主放电 MOS 状态 (PA0 引脚回读，0=关，1=开)
    - Byte 3: BAT1 回充 MOS 状态 (PA4 引脚回读，0=关，1=开)
    - Byte 4: BAT2 主放电 MOS 状态 (PA5 引脚回读，0=关，1=开)
    - Byte 5: BAT2 回充 MOS 状态 (PC4 引脚回读，0=关，1=开)
    - Byte 6~7: 保留 (0x00)
    2. 通信时序与机制优化
    - 常态心跳加速：无故障稳态心跳周期从 1000ms 缩短为 100ms，满足小脑实时监视要求
    - MOS 边沿即时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
2026-09-07 修改电池在线判定阈值、电源板状态上报速度、pb11
    电池在线判定阈值60V 改为50V ;上报速度不管异常还是正常统一200ms；pb11由默认拉低改为拉高
2026-09-09 移植双电池充电控制逻辑至A10分支并统一CAN协议
    移植与实现详情：
    1. 充电状态机与引脚控制 (gpio.h / gpio.c)
    - 新增 PowerWorkMode_t 枚举 (POWER_WORK_MODE_DISCHARGE / POWER_WORK_MODE_CHARGE)
    - 模式切换管理：
    * Power_EnterChargeMode()：切入充电前立即切断所有放电、预放电、回充 MOS（防止高压母线直通倒灌），重置放电状态机，安全进入纯充电模式
    * Power_ExitChargeMode()：断开所有充电 MOS，切回放电模式并复位相关状态
    - 充电均衡控制 (Power_UpdateChargeMode)：
    * 双电池在线时计算压差：若压差大于 POWER_CHARGE_BALANCE_DIFF (0.10V)，仅开启较低电压电池的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
2026-09-09 [调试] 添加充电桩握手CAN帧接收与充电状态监控变量
    本提交仅用于桌面台架及现场调试验证单片机是否正常收到充电桩 CAN 帧，
    便于在 Keil/STM32CubeIDE 中直接通过 Watch 观察。调试完成后若无需保留可直接通过 git revert 回退。
    主要改动：
    1. Core/Inc/fdcan.h & Core/Src/fdcan.c:
    - charger_can_rx_count: 接收到 0x0500FF80 握手帧的自增计数器（无条件自增，无上位机参与亦可验证收包）
    - charger_can_rx_id: 最近一次接收到的充电桩握手帧 ID（0x0500FF80）
    - charger_can_last_rx_tick: 最近一次接收时间戳 (HAL_GetTick())
    - rk_charge_mode_request: 导出上位机小脑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
    [fdcan.c, fdcan.h]
2026-09-11 修复充电桩超时检测无符号下溢导致充电模式误退出；充电期间维持放电MOS保障VBUS供电
    [Bug 修复] fdcan.c — 充电桩通信超时检测存在无符号时间戳下溢（Race Condition）
    根本原因：
    FDCAN_BatteryCanTask() 在函数入口处采样 now = HAL_GetTick() 得到值 N，
    随后调用 FDCAN_PollBatteryRx() 时接收到充电桩报文，在其内部再次调用
    HAL_GetTick() 更新 charger_can_last_rx_tick 为 N+1（SysTick 恰好递增）。
    之后执行超时判断 (now - charger_can_last_rx_tick) 时，无符号减法
    N - (N+1) 下溢为 0xFFFFFFFF（约42.9亿），远大于超时阈值 3000ms，
    导致系统误判为通信超时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
    [fdcan.c, fdcan.h, gpio.c]
2026-09-20 CAN Bus-Off 自动恢复机制及优化 - v1.4
    ## 新增功能
    ### 1. CAN Bus-Off 中断驱动自动恢复机制
    - 实现完整的 Bus-Off 自动恢复状态机（IDLE → PENDING → REQUEST_INIT → START_SYNC → RECOVERING）
    - 采用中断驱动 + 异步非阻塞设计，全程 0ms 阻塞
    - 符合 ISO 11898-1 规范，等待硬件自主完成 129×11 bit 隐性位同步
    - 主循环轮询兜底，防止中断丢失
    - 代际号机制避免 ABA 竞态问题
    ### 2. 发包函数临界区保护（关键安全优化）
    - 为所有 FDCAN 发送函数添加双重检查锁定模式
    - 彻底消除 TOCTOU 竞态窗口（检查标志与入队之间的中断风险）
    - 关中断时间 1-2µs，占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
    [fdcan.c, fdcan.h, gpio.c, gpio.h, main.c]
2026-09-21 [v1.2原理图] 适配V1.2硬件设计：精简ADC与移除I2C，新增双路反电势泄放、DCDC使能与RGB蜂鸣器状态指示
    根据 V1.2 版本硬件原理图（v1.2新版_SCH_Schematic1_2026-09-17.pdf）及引脚规划，完成固件适配、保护逻辑重构与文档同步：
    1. ADC 与采样架构精简 (adc.c / adc.h):
    - 彻底移除 ADC1 及 4 路支路电流（leg_current）硬件采样，各电池电压与电流全面依赖 BMS CAN 报文。
    - 仅保留 ADC2（DMA 循环双通道）：
    * PA4 (ADC2_IN17)：外设/总线放电电流采样与上电偏置校准；
    * PB15 (ADC2_IN15)：VBUS 高压母线电压采样（滑动中值滤波）。
    - 更新接口为 A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
2026-09-22 [v1.2原理图] 适配V1.2硬件：CAN2/CAN3职责对调、TIM2 PWM母线泄放、预充重叠导通缓冲及小脑声光指示控制
    依据《v1.2新版_SCH_Schematic1_2026-09-17.pdf》及硬件改版要求，完成固件层面对 V1.2 硬件的全面适配与功能重构：
    1. CAN 控制器职责软件对调（硬件走线反接适配）
    - 背景：PCB 走线中 CAN2 与 CAN3 外接接口反接，由于 STM32G474 物理引脚 AF 映射无法互换，在软件层对调 FDCAN2 与 FDCAN3 控制器职责。
    - 调整后职责：
    * FDCAN2 (PB13/PB5)：连接上位机/小脑 (RK3588)，负责接收充电模式控制、声光指示指令及遥测状态上报；
    * FDCAN3 (PB4/PA8)：连接电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
2026-09-23 [v1.2原理图|测试|9月23] 适配V1.2硬件修改(DCDC使能/急停停用/ADC校准)，优化BMS状态消抖与母线泄放安全策略
    ## 1. 硬件适配 (V1.2 原理图与引脚分配调整)
    - DCDC 电源使能反转为低电平有效 (Active-Low)：
    * 定义 POWER_DCDC_ON 为 GPIO_PIN_RESET，POWER_DCDC_OFF 为 GPIO_PIN_SET
    * 同步更新 Power_SetDcdc12V() 与 Power_SetDcdc24V() 控制逻辑
    * D-Y.ioc 中配置 PA7 (12V使能) 和 PC4 (24V使能) 初始上电默认输出高电平 (GPIO_PIN_SET)，防止开机误使能
    - 停用急停功能 (硬件未连接)：
    * 因 V1.2 硬件未连接运控板光耦急停信号，在 D-Y.ioc 中移除 PD2 引脚配置
    * 代码中注释 EMER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
2026-09-24 feat(iap): 实现基于FDCAN2的在线固件升级系统与无缝热接力机制
    - 新增 Bootloader 微型工程 (22KB Flash / 单分区原地升级防变砖)
    - 实现供电无缝热接力 (维持12V/24V DCDC与主放电MOS，跳过400ms预充消抖)
    - 适配 Single-Bank 128-bit 线性 Flash 擦除与 Page 11 元数据魔数校验
    - 完善中断安全、FDCAN 资源释放、Flash 缓存刷新与 ARM 内存屏障
    - 提供 Python 上位机流式烧录工具 (支持平滑微延时) 及完整使用手册
2026-09-24 fix(iap): 增强Flash烧录稳定性与兼容性，并将Bus-Off指示调整为红灯闪烁
    1. CAN IAP 烧录与稳定性优化:
    - Flash 写入临界区保护: 增加关中断 (__disable_irq/__set_PRIMASK)，防止 SysTick 等中断打断 Flash 编程触发 PGSERR 错误
    - 动态页大小适配: 区分 Dual-Bank (2KB/页) 与 Single-Bank (4KB/页)，动态计算 App 擦除起始页与页数
    - 优化 App 有效性校验: 完善栈顶指针 (SRAM 范围与 8 字节对齐) 校验；允许元数据为空 (0xFFFFFFFF) 时直接运行合法固件，兼容 ST-Link/J-Link 直烧场景
    - App 跳转至 Bootloader 完善: 前置 Bootloader 栈顶与入口地址合法性校验，调用 HAL_R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
    [boot_can.c, boot_flash.c, boot_flash.h, boot_jump.c, can_iap_tool.py, fdcan.c, gpio.c, gpio.h]
2026-09-28 fix(iap): 优化跳转时钟复位时序与Bootloader稳定性，支持测试流水灯及完善升级工具
2026-10-08 feat(fdcan/iap): 完善固件三位版本协议与状态上报优先级，更新升级工具交互及工程文档
    1. FDCAN与IAP通信：
    - 固件版本号统一定义为三位语义化版本(Major.Minor.Patch)，PING指令响应增加Patch字段；
    - 优化FDCAN Bus-Off兜底轮询机制，增加100ms周期限频避免持续清零PSR.LEC；
    - 增强电池CAN上报状态机，新增mosChangedPending事件挂起重试机制，确保MOS状态跳变即时可靠送达。
    2. 升级工具与Bootloader：
    - 更新can_iap_tool.py，新增交互式控制台菜单与设备状态查询功能(-q/--query)；
    - 对应更新Bootloader版本响应及IAP通信协议文档。
    3. 文档与配置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
2026-10-09 feat(v1.2.1): 优化回充防倒灌控制与IAP一键升级，更新README及项目文档 (v1.2.1)
    - docs: 更新 README.md，在标题中增加 v1.2.1 版本标识，全面同步 400ms+200ms 预充重叠时序与回充防倒灌逻辑
    - feat(gpio): 主放电 MOS 闭合前依据压差同步配置回充 MOS，双路未平衡 CAN 掉线时强制关断回充防倒灌
    - fix(fdcan): 移除报警发送多余标志复位，统一使用软件标志判断 Bus-Off 避免清除 PSR.LEC
    - feat(scripts): can_iap_tool.py 支持默认同级固件免路径交互升级与 -u/--upgrade 命令行一键热升级
    - docs: 同步更新 CAN_IAP_GUIDE.md 使用说明
    [can_iap_tool.py, fdcan.c, gpio.c, gpio.h]
